ferdymercury/Controller-Electrical-Schematics/kicad/my_Design_fields.xlsx

Refs | datasheet | footprint | value | mfg-pn | digikey-pn
C1 | http://datasheets.avx.com/AR-Series.pdf | C_Rect_L5.08mm_W3.175mm_P2.54mm:C_Rect_L5.08mm_W3.175mm_P2.54mm | 0.1uF | AR205F104K4R | 478-5096-ND
C10 | http://datasheets.avx.com/AR-Series.pdf | C_Rect_L5.08mm_W3.175mm_P2.54mm:C_Rect_L5.08mm_W3.175mm_P2.54mm | 0.1uF | AR205F104K4R | 478-5096-ND
C11 | http://datasheets.avx.com/AR-Series.pdf | C_Rect_L5.08mm_W3.175mm_P2.54mm:C_Rect_L5.08mm_W3.175mm_P2.54mm | 0.1uF | AR205F104K4R | 478-5096-ND
C12 | http://datasheets.avx.com/AR-Series.pdf | C_Rect_L5.08mm_W3.175mm_P2.54mm:C_Rect_L5.08mm_W3.175mm_P2.54mm | 0.1uF | AR205F104K4R | 478-5096-ND
C13 | http://datasheets.avx.com/AR-Series.pdf | C_Rect_L5.08mm_W3.175mm_P2.54mm:C_Rect_L5.08mm_W3.175mm_P2.54mm | 0.1uF | AR205F104K4R | 478-5096-ND
C14 | http://datasheets.avx.com/AR-Series.pdf | C_Rect_L5.08mm_W3.175mm_P2.54mm:C_Rect_L5.08mm_W3.175mm_P2.54mm | 0.1uF | AR205F104K4R | 478-5096-ND
C15 | http://datasheets.avx.com/AR-Series.pdf | C_Rect_L5.08mm_W3.175mm_P2.54mm:C_Rect_L5.08mm_W3.175mm_P2.54mm | 0.1uF | AR205F104K4R | 478-5096-ND
C16 | http://datasheets.avx.com/AR-Series.pdf | C_Rect_L5.08mm_W3.175mm_P2.54mm:C_Rect_L5.08mm_W3.175mm_P2.54mm | 0.1uF | AR205F104K4R | 478-5096-ND
C17 | http://datasheets.avx.com/AR-Series.pdf | C_Rect_L5.08mm_W3.175mm_P2.54mm:C_Rect_L5.08mm_W3.175mm_P2.54mm | 0.1uF | AR205F104K4R | 478-5096-ND
C18 | http://datasheets.avx.com/AR-Series.pdf | C_Rect_L5.08mm_W3.175mm_P2.54mm:C_Rect_L5.08mm_W3.175mm_P2.54mm | 0.1uF | AR205F104K4R | 478-5096-ND
C2 | http://datasheets.avx.com/AR-Series.pdf | C_Rect_L5.08mm_W3.175mm_P2.54mm:C_Rect_L5.08mm_W3.175mm_P2.54mm | 0.1uF | AR205F104K4R | 478-5096-ND
C3 | http://datasheets.avx.com/AR-Series.pdf | C_Rect_L5.08mm_W3.175mm_P2.54mm:C_Rect_L5.08mm_W3.175mm_P2.54mm | 0.1uF | AR205F104K4R | 478-5096-ND
C4 | http://datasheets.avx.com/AR-Series.pdf | C_Rect_L5.08mm_W3.175mm_P2.54mm:C_Rect_L5.08mm_W3.175mm_P2.54mm | 0.1uF | AR205F104K4R | 478-5096-ND
C5 | http://datasheets.avx.com/AR-Series.pdf | C_Rect_L5.08mm_W3.175mm_P2.54mm:C_Rect_L5.08mm_W3.175mm_P2.54mm | 0.01uF | AR205F103K4R | 478-5095-ND
C6 | http://datasheets.avx.com/AR-Series.pdf | C_Rect_L5.08mm_W3.175mm_P2.54mm:C_Rect_L5.08mm_W3.175mm_P2.54mm | 0.01uF | AR205F103K4R | 478-5095-ND
C7 | http://datasheets.avx.com/AR-Series.pdf | C_Rect_L5.08mm_W3.175mm_P2.54mm:C_Rect_L5.08mm_W3.175mm_P2.54mm | 0.1uF | AR205F104K4R | 478-5096-ND
C8 | http://datasheets.avx.com/AR-Series.pdf | C_Rect_L5.08mm_W3.175mm_P2.54mm:C_Rect_L5.08mm_W3.175mm_P2.54mm | 0.1uF | AR205F104K4R | 478-5096-ND
C9 | http://datasheets.avx.com/AR-Series.pdf | C_Rect_L5.08mm_W3.175mm_P2.54mm:C_Rect_L5.08mm_W3.175mm_P2.54mm | 0.1uF | AR205F104K4R | 478-5096-ND
D11 | https://media.digikey.com/pdf/Data%20Sheets/Comchip%20PDFs/SB520E-G_SB5100E-G.pdf | Diodes_THT:D_DO-201AD_P15.24mm_Horizontal | SB5100E-G | SB5100E-G | 641-1421-1-ND
D2 | https://media.digikey.com/pdf/Data%20Sheets/Comchip%20PDFs/SB520E-G_SB5100E-G.pdf | Diodes_THT:D_DO-201AD_P15.24mm_Horizontal | SB5100E-G | SB5100E-G | 641-1421-1-ND
D3 | https://media.digikey.com/pdf/Data%20Sheets/Comchip%20PDFs/SB520E-G_SB5100E-G.pdf | Diodes_THT:D_DO-201AD_P15.24mm_Horizontal | SB5100E-G | SB5100E-G | 641-1421-1-ND
D4 | http://www.kingbrightusa.com/images/catalog/SPEC/WP7113ID.pdf | LEDs:LED_D5.0mm | WP7113ID | WP7113ID | 754-1264-ND
D5 | http://www.kingbrightusa.com/images/catalog/SPEC/WP7113ID.pdf | LEDs:LED_D5.0mm | WP7113ID | WP7113ID | 754-1264-ND
D7 | https://media.digikey.com/pdf/Data%20Sheets/Comchip%20PDFs/SB520E-G_SB5100E-G.pdf | Diodes_THT:D_DO-201AD_P15.24mm_Horizontal | SB5100E-G | SB5100E-G | 641-1421-1-ND
D8 | https://media.digikey.com/pdf/Data%20Sheets/Comchip%20PDFs/SB520E-G_SB5100E-G.pdf | Diodes_THT:D_DO-201AD_P15.24mm_Horizontal | SB5100E-G | SB5100E-G | 641-1421-1-ND
Q1 | https://www.fairchildsemi.com/datasheets/MM/MMBT3904.pdf | TO_SOT_Packages_THT:TO-92_Inline_Wide | 2N3904 | 2N3904BU | 2N3904FS-ND
Q10 | http://www.onsemi.com/pub/Collateral/NTB5605P-D.PDF | TO_SOT_Packages_THT:TO-220-3_Vertical | NTB5605PT4G | NTB5605PT4G | NTB5605PT4GOSCT-ND
Q11 | https://www.fairchildsemi.com/datasheets/MM/MMBT3904.pdf | TO_SOT_Packages_THT:TO-92_Inline_Wide | 2N3904 | 2N3904BU | 2N3904FS-ND
Q12 | https://www.fairchildsemi.com/datasheets/FQ/FQB30N06L.pdf | TO_SOT_Packages_SMD:TO-263-3_TabPin2 | FQB30N06LTM | FQB30N06LTM | FQB30N06LTMCT-ND
Q13 | https://www.fairchildsemi.com/datasheets/FQ/FQB30N06L.pdf | TO_SOT_Packages_SMD:TO-263-3_TabPin2 | FQB30N06LTM | FQB30N06LTM | FQB30N06LTMCT-ND
Q14 | http://www.onsemi.com/pub/Collateral/NTB5605P-D.PDF | TO_SOT_Packages_THT:TO-220-3_Vertical | NTB5605PT4G | NTB5605PT4G | NTB5605PT4GOSCT-ND
Q15 | https://www.fairchildsemi.com/datasheets/MM/MMBT3904.pdf | TO_SOT_Packages_THT:TO-92_Inline_Wide | 2N3904 | 2N3904BU | 2N3904FS-ND
Q16 | http://www.onsemi.com/pub/Collateral/NTB5605P-D.PDF | TO_SOT_Packages_THT:TO-220-3_Vertical | NTB5605PT4G | NTB5605PT4G | NTB5605PT4GOSCT-ND
Q17 | https://www.fairchildsemi.com/datasheets/MM/MMBT3904.pdf | TO_SOT_Packages_THT:TO-92_Inline_Wide | 2N3904 | 2N3904BU | 2N3904FS-ND
Q18 | http://www.onsemi.com/pub/Collateral/NTB5605P-D.PDF | TO_SOT_Packages_THT:TO-220-3_Vertical | NTB5605PT4G | NTB5605PT4G | NTB5605PT4GOSCT-ND
Q19 | https://www.fairchildsemi.com/datasheets/MM/MMBT3904.pdf | TO_SOT_Packages_THT:TO-92_Inline_Wide | 2N3904 | 2N3904BU | 2N3904FS-ND
Q2 | http://www.onsemi.com/pub/Collateral/NTB5605P-D.PDF | TO_SOT_Packages_THT:TO-220-3_Vertical | NTB5605PT4G | NTB5605PT4G | NTB5605PT4GOSCT-ND
Q20 | http://www.onsemi.com/pub/Collateral/NTB5605P-D.PDF | TO_SOT_Packages_THT:TO-220-3_Vertical | FQB30N06LTM | FQB30N06LTM | FQB30N06LTMCT-ND
Q21 | https://www.fairchildsemi.com/datasheets/MM/MMBT3904.pdf | TO_SOT_Packages_THT:TO-92_Molded_Narrow | 2N3904 | 2N3904BU | 2N3904FS-ND
Q22 | https://www.fairchildsemi.com/datasheets/MM/MMBT3904.pdf | TO_SOT_Packages_THT:TO-92_Molded_Narrow | 2N3904 | 2N3904BU | 2N3904FS-ND
Q23 | http://www.onsemi.com/pub/Collateral/NTB5605P-D.PDF | TO_SOT_Packages_THT:TO-220-3_Vertical | NTB5605PT4G | NTB5605PT4G | NTB5605PT4GOSCT-ND
Q24 | https://www.fairchildsemi.com/datasheets/MM/MMBT3904.pdf | TO_SOT_Packages_THT:TO-92_Inline_Wide | 2N3904 | 2N3904BU | 2N3904FS-ND
Q25 | http://www.onsemi.com/pub/Collateral/NTB5605P-D.PDF | TO_SOT_Packages_THT:TO-220-3_Vertical | NTB5605PT4G | NTB5605PT4G | NTB5605PT4GOSCT-ND
Q26 | https://www.fairchildsemi.com/datasheets/MM/MMBT3904.pdf | TO_SOT_Packages_THT:TO-92_Inline_Wide | 2N3904 | 2N3904BU | 2N3904FS-ND
Q27 | http://www.onsemi.com/pub/Collateral/NTB5605P-D.PDF | TO_SOT_Packages_THT:TO-220-3_Vertical | NTB5605PT4G | NTB5605PT4G | NTB5605PT4GOSCT-ND
Q28 | https://www.fairchildsemi.com/datasheets/MM/MMBT3904.pdf | TO_SOT_Packages_THT:TO-92_Inline_Wide | 2N3904 | 2N3904BU | 2N3904FS-ND
Q29 | http://www.onsemi.com/pub/Collateral/NTB5605P-D.PDF | TO_SOT_Packages_THT:TO-220-3_Vertical | NTB5605PT4G | NTB5605PT4G | NTB5605PT4GOSCT-ND
Q3 | http://www.onsemi.com/pub/Collateral/NTB5605P-D.PDF | TO_SOT_Packages_THT:TO-220-3_Vertical | NTB5605PT4G | NTB5605PT4G | NTB5605PT4GOSCT-ND
Q30 | https://www.fairchildsemi.com/datasheets/MM/MMBT3904.pdf | TO_SOT_Packages_THT:TO-92_Inline_Wide | 2N3904 | 2N3904BU | 2N3904FS-ND
Q31 | https://www.fairchildsemi.com/datasheets/FQ/FQB30N06L.pdf | TO_SOT_Packages_SMD:TO-263-3_TabPin2 | FQB30N06LTM | FQB30N06LTM | FQB30N06LTMCT-ND
Q32 | https://www.fairchildsemi.com/datasheets/FQ/FQB30N06L.pdf | TO_SOT_Packages_SMD:TO-263-3_TabPin2 | FQB30N06LTM | FQB30N06LTM | FQB30N06LTMCT-ND
Q33 | http://www.onsemi.com/pub/Collateral/NTB5605P-D.PDF | TO_SOT_Packages_THT:TO-220-3_Vertical | NTB5605PT4G | NTB5605PT4G | NTB5605PT4GOSCT-ND
Q34 | https://www.fairchildsemi.com/datasheets/MM/MMBT3904.pdf | TO_SOT_Packages_THT:TO-92_Inline_Wide | 2N3904 | 2N3904BU | 2N3904FS-ND
Q35 | http://www.onsemi.com/pub/Collateral/NTB5605P-D.PDF | TO_SOT_Packages_THT:TO-220-3_Vertical | NTB5605PT4G | NTB5605PT4G | NTB5605PT4GOSCT-ND
Q36 | https://www.fairchildsemi.com/datasheets/MM/MMBT3904.pdf | TO_SOT_Packages_THT:TO-92_Inline_Wide | 2N3904 | 2N3904BU | 2N3904FS-ND
Q37 | http://www.onsemi.com/pub/Collateral/NTB5605P-D.PDF | TO_SOT_Packages_THT:TO-220-3_Vertical | NTB5605PT4G | NTB5605PT4G | NTB5605PT4GOSCT-ND
Q38 | https://www.fairchildsemi.com/datasheets/MM/MMBT3904.pdf | TO_SOT_Packages_THT:TO-92_Inline_Wide | 2N3904 | 2N3904BU | 2N3904FS-ND
Q39 | http://www.onsemi.com/pub/Collateral/NTB5605P-D.PDF | TO_SOT_Packages_THT:TO-220-3_Vertical | NTB5605PT4G | NTB5605PT4G | NTB5605PT4GOSCT-ND
Q4 | https://www.fairchildsemi.com/datasheets/MM/MMBT3904.pdf | TO_SOT_Packages_THT:TO-92_Inline_Wide | 2N3904 | 2N3904BU | 2N3904FS-ND
Q40 | https://www.fairchildsemi.com/datasheets/MM/MMBT3904.pdf | TO_SOT_Packages_THT:TO-92_Inline_Wide | 2N3904 | 2N3904BU | 2N3904FS-ND
Q41 | http://www.onsemi.com/pub/Collateral/BSS138LT1-D.PDF | TO_SOT_Packages_SMD:SOT-23 | BSS138 | BSS138LT1G | BSS138LT1GOSCT-ND
Q42 | http://www.onsemi.com/pub/Collateral/BSS138LT1-D.PDF | TO_SOT_Packages_SMD:SOT-23 | BSS138 | BSS138LT1G | BSS138LT1GOSCT-ND
Q5 | http://www.onsemi.com/pub/Collateral/NTB5605P-D.PDF | TO_SOT_Packages_THT:TO-220-3_Vertical | NTB5605PT4G | NTB5605PT4G | NTB5605PT4GOSCT-ND
Q6 | https://www.fairchildsemi.com/datasheets/MM/MMBT3904.pdf | TO_SOT_Packages_THT:TO-92_Inline_Wide | 2N3904 | 2N3904BU | 2N3904FS-ND
Q7 | https://www.fairchildsemi.com/datasheets/FQ/FQB30N06L.pdf | TO_SOT_Packages_SMD:TO-263-3_TabPin2 | FQB30N06LTM | FQB30N06LTM | FQB30N06LTMCT-ND
Q8 | http://www.onsemi.com/pub/Collateral/NTB5605P-D.PDF | TO_SOT_Packages_THT:TO-220-3_Vertical | NTB5605PT4G | NTB5605PT4G | NTB5605PT4GOSCT-ND
Q9 | https://www.fairchildsemi.com/datasheets/MM/MMBT3904.pdf | TO_SOT_Packages_THT:TO-92_Inline_Wide | 2N3904 | 2N3904BU | 2N3904FS-ND
R1 |  | Resistors_THT:R_Axial_DIN0204_L3.6mm_D1.6mm_P5.08mm_Horizontal | 10KΩ | MBA02040C1002FRP00 | BC10.0KXCT-ND
R100 |  | Resistors_THT:R_Axial_DIN0204_L3.6mm_D1.6mm_P5.08mm_Horizontal | 10KΩ | MBA02040C1002FRP00 | BC10.0KXCT-ND
R102 |  | Resistors_THT:R_Axial_DIN0204_L3.6mm_D1.6mm_P5.08mm_Horizontal | 10KΩ | MBA02040C1002FRP00 | BC10.0KXCT-ND
R103 |  | Resistors_THT:R_Axial_DIN0204_L3.6mm_D1.6mm_P5.08mm_Horizontal | 1KΩ | MBA02040C1001FRP00 | BC1.00KXCT-ND
R104 |  | Resistors_THT:R_Axial_DIN0204_L3.6mm_D1.6mm_P5.08mm_Horizontal | 10KΩ | MBA02040C1002FRP00 | BC10.0KXCT-ND
R107 |  | Resistors_THT:R_Axial_DIN0204_L3.6mm_D1.6mm_P5.08mm_Horizontal | 10KΩ | MBA02040C1002FRP00 | BC10.0KXCT-ND
R109 |  | Resistors_THT:R_Axial_DIN0204_L3.6mm_D1.6mm_P5.08mm_Horizontal | 10KΩ | MBA02040C1002FRP00 | BC10.0KXCT-ND
R11 |  | Resistors_THT:R_Axial_DIN0204_L3.6mm_D1.6mm_P5.08mm_Horizontal | 1KΩ | MBA02040C1001FRP00 | BC1.00KXCT-ND
R110 |  | Resistors_THT:R_Axial_DIN0204_L3.6mm_D1.6mm_P5.08mm_Horizontal | 10KΩ | MBA02040C1002FRP00 | BC10.0KXCT-ND
R111 |  | Resistors_THT:R_Axial_DIN0204_L3.6mm_D1.6mm_P5.08mm_Horizontal | 1KΩ | MBA02040C1001FRP00 | BC1.00KXCT-ND
R112 |  | Resistors_THT:R_Axial_DIN0204_L3.6mm_D1.6mm_P5.08mm_Horizontal | 10KΩ | MBA02040C1002FRP00 | BC10.0KXCT-ND
R114 |  | Resistors_THT:R_Axial_DIN0204_L3.6mm_D1.6mm_P5.08mm_Horizontal | 10KΩ | MBA02040C1002FRP00 | BC10.0KXCT-ND
R115 |  | Resistors_THT:R_Axial_DIN0204_L3.6mm_D1.6mm_P5.08mm_Horizontal | 1KΩ | MBA02040C1001FRP00 | BC1.00KXCT-ND
R116 |  | Resistors_THT:R_Axial_DIN0204_L3.6mm_D1.6mm_P5.08mm_Horizontal | 10KΩ | MBA02040C1002FRP00 | BC10.0KXCT-ND
R118 |  | Resistors_THT:R_Axial_DIN0204_L3.6mm_D1.6mm_P5.08mm_Horizontal | 100KΩ | MBA02040C1003FRP00 | BC100KXCT-ND
R119 |  | Resistors_THT:R_Axial_DIN0204_L3.6mm_D1.6mm_P5.08mm_Horizontal | 51KΩ | MBA02040C5102FRP00 | BC3531CT-ND
R12 |  | Resistors_THT:R_Axial_DIN0204_L3.6mm_D1.6mm_P5.08mm_Horizontal | 1KΩ | MBA02040C1001FRP00 | BC1.00KXCT-ND
R120 |  | Resistors_THT:R_Axial_DIN0204_L3.6mm_D1.6mm_P5.08mm_Horizontal | 10KΩ | MBA02040C1002FRP00 | BC10.0KXCT-ND
R121 |  | Resistors_THT:R_Axial_DIN0204_L3.6mm_D1.6mm_P5.08mm_Horizontal | 1KΩ | MBA02040C1001FRP00 | BC1.00KXCT-ND
R122 |  | Resistors_THT:R_Axial_DIN0204_L3.6mm_D1.6mm_P5.08mm_Horizontal | 10KΩ | MBA02040C1002FRP00 | BC10.0KXCT-ND
R124 |  | Resistors_THT:R_Axial_DIN0204_L3.6mm_D1.6mm_P5.08mm_Horizontal | 10KΩ | MBA02040C1002FRP00 | BC10.0KXCT-ND
R125 |  | Resistors_THT:R_Axial_DIN0204_L3.6mm_D1.6mm_P5.08mm_Horizontal | 1KΩ | MBA02040C1001FRP00 | BC1.00KXCT-ND
R126 |  | Resistors_THT:R_Axial_DIN0204_L3.6mm_D1.6mm_P5.08mm_Horizontal | 10KΩ | MBA02040C1002FRP00 | BC10.0KXCT-ND
R128 |  | Resistors_THT:R_Axial_DIN0204_L3.6mm_D1.6mm_P5.08mm_Horizontal | 10KΩ | MBA02040C1002FRP00 | BC10.0KXCT-ND
R129 |  | Resistors_THT:R_Axial_DIN0204_L3.6mm_D1.6mm_P5.08mm_Horizontal | 10KΩ | MBA02040C1002FRP00 | BC10.0KXCT-ND
R13 |  | Resistors_THT:R_Axial_DIN0204_L3.6mm_D1.6mm_P5.08mm_Horizontal | 100KΩ | MBA02040C1003FRP00 | BC100KXCT-ND
R130 |  | Resistors_THT:R_Axial_DIN0204_L3.6mm_D1.6mm_P5.08mm_Horizontal | 10KΩ | MBA02040C1002FRP00 | BC10.0KXCT-ND
R131 |  | Resistors_THT:R_Axial_DIN0204_L3.6mm_D1.6mm_P5.08mm_Horizontal | 10KΩ | MBA02040C1002FRP00 | BC10.0KXCT-ND
R14 |  | Resistors_THT:R_Axial_DIN0204_L3.6mm_D1.6mm_P5.08mm_Horizontal | 51KΩ | MBA02040C5102FRP00 | BC3531CT-ND
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
R78 |  | Resistors_THT:R_Axial_DIN0204_L3.6mm_D1.6mm_P5.08mm_Horizontal | 3.3KΩ | MBA02040C3301FRP00 | BC3499CT-ND
R79 |  | Resistors_THT:R_Axial_DIN0204_L3.6mm_D1.6mm_P5.08mm_Horizontal | 3.3KΩ | MBA02040C3301FRP00 | BC3499CT-ND
R8 |  | Resistors_THT:R_Axial_DIN0204_L3.6mm_D1.6mm_P5.08mm_Horizontal | 10KΩ | MBA02040C1002FRP00 | BC10.0KXCT-ND
R80 |  | Resistors_THT:R_Axial_DIN0204_L3.6mm_D1.6mm_P5.08mm_Horizontal | 10KΩ | MBA02040C1002FRP00 | BC10.0KXCT-ND
R81 |  | Resistors_THT:R_Axial_DIN0204_L3.6mm_D1.6mm_P5.08mm_Horizontal | 10KΩ | MBA02040C1002FRP00 | BC10.0KXCT-ND
R82 |  | Resistors_THT:R_Axial_DIN0204_L3.6mm_D1.6mm_P5.08mm_Horizontal | 10KΩ | MBA02040C1002FRP00 | BC10.0KXCT-ND
R83 |  | Resistors_THT:R_Axial_DIN0204_L3.6mm_D1.6mm_P5.08mm_Horizontal | 10KΩ | MBA02040C1002FRP00 | BC10.0KXCT-ND
R84 |  | Resistors_THT:R_Axial_DIN0204_L3.6mm_D1.6mm_P5.08mm_Horizontal | 10KΩ | MBA02040C1002FRP00 | BC10.0KXCT-ND
R85 |  | Resistors_THT:R_Axial_DIN0204_L3.6mm_D1.6mm_P5.08mm_Horizontal | 10KΩ | MBA02040C1002FRP00 | BC10.0KXCT-ND
R86 |  | Resistors_THT:R_Axial_DIN0204_L3.6mm_D1.6mm_P5.08mm_Horizontal | 15KΩ | MBA02040C1502FCT00 | BC3248CT-ND
R87 |  | Resistors_THT:R_Axial_DIN0204_L3.6mm_D1.6mm_P5.08mm_Horizontal | 10KΩ | MBA02040C1002FRP00 | BC10.0KXCT-ND
R88 |  | Resistors_THT:R_Axial_DIN0204_L3.6mm_D1.6mm_P5.08mm_Horizontal | 10KΩ | MBA02040C1002FRP00 | BC10.0KXCT-ND
R89 |  | Resistors_THT:R_Axial_DIN0204_L3.6mm_D1.6mm_P5.08mm_Horizontal | 10KΩ | MBA02040C1002FRP00 | BC10.0KXCT-ND
R9 |  | Resistors_THT:R_Axial_DIN0204_L3.6mm_D1.6mm_P5.08mm_Horizontal | 10KΩ | MBA02040C1002FRP00 | BC10.0KXCT-ND
R90 |  | Resistors_THT:R_Axial_DIN0204_L3.6mm_D1.6mm_P5.08mm_Horizontal | 10KΩ | MBA02040C1002FRP00 | BC10.0KXCT-ND
R91 |  | Resistors_THT:R_Axial_DIN0204_L3.6mm_D1.6mm_P5.08mm_Horizontal | 1KΩ | MBA02040C1001FRP00 | BC1.00KXCT-ND
R92 |  | Resistors_THT:R_Axial_DIN0204_L3.6mm_D1.6mm_P5.08mm_Horizontal | 10KΩ | MBA02040C1002FRP00 | BC10.0KXCT-ND
R94 |  | Resistors_THT:R_Axial_DIN0204_L3.6mm_D1.6mm_P5.08mm_Horizontal | 10KΩ | MBA02040C1002FRP00 | BC10.0KXCT-ND
R95 |  | Resistors_THT:R_Axial_DIN0204_L3.6mm_D1.6mm_P5.08mm_Horizontal | 1KΩ | MBA02040C1001FRP00 | BC1.00KXCT-ND
R96 |  | Resistors_THT:R_Axial_DIN0204_L3.6mm_D1.6mm_P5.08mm_Horizontal | 10KΩ | MBA02040C1002FRP00 | BC10.0KXCT-ND
R98 |  | Resistors_THT:R_Axial_DIN0204_L3.6mm_D1.6mm_P5.08mm_Horizontal | 10KΩ | MBA02040C1002FRP00 | BC10.0KXCT-ND
R99 |  | Resistors_THT:R_Axial_DIN0204_L3.6mm_D1.6mm_P5.08mm_Horizontal | 1KΩ | MBA02040C1001FRP00 | BC1.00KXCT-ND
RV1 | http://www.bourns.com/docs/Product-Datasheets/pv36.pdf | Potentiometers:Potentiometer_Trimmer_Bourns_PV36W | 10KΩ | PV36W103C01B00 | 490-2875-ND
SHIELD1 |  | freetronics_footprints:ARDUINO_MEGA_SHIELD | ARDUINO_MEGA_SHIELD
U1 | https://power.murata.com/data/power/ncl/kdc_ncs3.pdf | NCS3S1205SC:NCS3S1205SC | NCS3S1205SC | NCS3S1205SC | 811-3084-ND
U2 | http://www.ixysic.com/home/pdfs.nsf/0/F9381D44DEE0D64A85256E390055B01F/$file/LCA715.pdf | Housings_DIP:DIP-6_W7.62mm_Socket | LCA715 | LCA715 | CLA308-ND
U3 |  | Housings_DIP:DIP-14_W7.62mm_Socket | CD4013B | CD4013BE | 296-2033-5-ND
U4 | http://www.ti.com/lit/ds/symlink/lm358.pdf | Housings_DIP:DIP-8_W7.62mm | LM358 | LM358P | 296-1395-5-ND
U5 | http://www.ti.com/lit/ds/symlink/sn74hc595.pdf | Housings_DIP:DIP-16_W7.62mm_Socket | 74HC595 | SN74HC595N | 296-1600-5-ND
U6 | http://www.ti.com/lit/ds/symlink/sn74hc595.pdf | Housings_DIP:DIP-16_W7.62mm_Socket | 74HC595 | SN74HC595N | 296-1600-5-ND
U7 | http://www.ti.com/lit/ds/symlink/cd74hct4067.pdf | Housings_SOIC:SOIC-24W_7.5x15.4mm_Pitch1.27mm | CD74HC4067 | CD74HCT4067M | 296-23078-ND
U8 | http://www.ti.com/lit/ds/symlink/lm139a.pdf | Housings_DIP:DIP-14_W7.62mm_Socket | LM339 | LM339N | 296-1393-5-ND
J1 | https://www.phoenixcontact.com/pxc-oc-itemdetail-pdf-web/eshop?lineItemType=LineItem&UID=1702972 | TerminalBlocks_Phoenix:TerminalBlock_Phoenix_MKDS1.5-16pol | Screw_Terminal_01x16 | 1702972 | 277-13705-ND
J10 | https://www.digikey.com/product-detail/en/amphenol-fci/75869-131LF/609-2845-ND/1302569 | Socket_Strips:Socket_Strip_Straight_2x03_Pitch2.54mm | Conn_02x03_Counter_Clockwise | 75869-131LF | 609-2845-ND
J11 | https://www.digikey.com/product-detail/en/amphenol-fci/75869-131LF/609-2845-ND/1302569 | Socket_Strips:Socket_Strip_Straight_2x03_Pitch2.54mm | Conn_02x03_Counter_Clockwise | 75869-131LF | 609-2845-ND
J12 | https://www.digikey.com/product-detail/en/amphenol-fci/75869-131LF/609-2845-ND/1302569 | Socket_Strips:Socket_Strip_Straight_2x03_Pitch2.54mm | Conn_02x03_Counter_Clockwise | 75869-131LF | 609-2845-ND
J13 | https://www.phoenixcontact.com/pxc-oc-itemdetail-pdf-web/eshop?lineItemType=LineItem&UID=1702972 | TerminalBlocks_Phoenix:TerminalBlock_Phoenix_MKDS1.5-16pol | Screw_Terminal_01x16 | 1702972 | 277-13705-ND
J14 | https://www.digikey.com/product-detail/en/amphenol-fci/75869-131LF/609-2845-ND/1302569 | Socket_Strips:Socket_Strip_Straight_2x03_Pitch2.54mm | Conn_02x03_Counter_Clockwise | 75869-131LF | 609-2845-ND
J15 | https://www.digikey.com/product-detail/en/amphenol-fci/75869-131LF/609-2845-ND/1302569 | Socket_Strips:Socket_Strip_Straight_2x03_Pitch2.54mm | Conn_02x03_Counter_Clockwise | 75869-131LF | 609-2845-ND
J16 | https://www.digikey.com/product-detail/en/amphenol-fci/75869-131LF/609-2845-ND/1302569 | Socket_Strips:Socket_Strip_Straight_2x03_Pitch2.54mm | Conn_02x03_Counter_Clockwise | 75869-131LF | 609-2845-ND
J17 | https://www.digikey.com/product-detail/en/amphenol-fci/75869-131LF/609-2845-ND/1302569 | Socket_Strips:Socket_Strip_Straight_2x03_Pitch2.54mm | Conn_02x03_Counter_Clockwise | 75869-131LF | 609-2845-ND
J18 | https://www.digikey.com/product-detail/en/amphenol-fci/75869-131LF/609-2845-ND/1302569 | Socket_Strips:Socket_Strip_Straight_2x03_Pitch2.54mm | Conn_02x03_Counter_Clockwise | 75869-131LF | 609-2845-ND
J19 | https://www.digikey.com/product-detail/en/amphenol-fci/75869-131LF/609-2845-ND/1302569 | Socket_Strips:Socket_Strip_Straight_2x03_Pitch2.54mm | Conn_02x03_Counter_Clockwise | 75869-131LF | 609-2845-ND
J2 | https://www.digikey.com/product-detail/en/amphenol-fci/75869-131LF/609-2845-ND/1302569 | Socket_Strips:Socket_Strip_Straight_2x03_Pitch2.54mm | Conn_02x03_Counter_Clockwise | 75869-131LF | 609-2845-ND
J20 | https://www.digikey.com/product-detail/en/amphenol-fci/75869-131LF/609-2845-ND/1302569 | Socket_Strips:Socket_Strip_Straight_2x03_Pitch2.54mm | Conn_02x03_Counter_Clockwise | 75869-131LF | 609-2845-ND
J21 | https://www.digikey.com/product-detail/en/amphenol-fci/75869-131LF/609-2845-ND/1302569 | Socket_Strips:Socket_Strip_Straight_2x03_Pitch2.54mm | Conn_02x03_Counter_Clockwise | 75869-131LF | 609-2845-ND
J22 | https://www.digikey.com/product-detail/en/amphenol-fci/75869-131LF/609-2845-ND/1302569 | Socket_Strips:Socket_Strip_Straight_2x03_Pitch2.54mm | Conn_02x03_Counter_Clockwise | 75869-131LF | 609-2845-ND
J23 | https://www.digikey.com/product-detail/en/amphenol-fci/75869-131LF/609-2845-ND/1302569 | Socket_Strips:Socket_Strip_Straight_2x03_Pitch2.54mm | Conn_02x03_Counter_Clockwise | 75869-131LF | 609-2845-ND
J24 | https://www.digikey.com/product-detail/en/amphenol-fci/75869-131LF/609-2845-ND/1302569 | Socket_Strips:Socket_Strip_Straight_2x03_Pitch2.54mm | Conn_02x03_Counter_Clockwise | 75869-131LF | 609-2845-ND
J3 | https://www.digikey.com/product-detail/en/amphenol-fci/75869-131LF/609-2845-ND/1302569 | 02x03_shrouded:Shroud_Socket_Strip_Straight_2x03_Pitch2.54mm | Conn_02x03_Counter_Clockwise | 75869-131LF | 609-2845-ND
J4 | https://www.phoenixcontact.com/pxc-oc-itemdetail-pdf-web/eshop?lineItemType=LineItem&UID=1702972 | TerminalBlocks_Phoenix:TerminalBlock_Phoenix_MKDS1.5-16pol | Screw_Terminal_01x16 | 1702972 | 277-13705-ND
J5 | https://www.digikey.com/product-detail/en/amphenol-fci/75869-131LF/609-2845-ND/1302569 | Socket_Strips:Socket_Strip_Straight_2x03_Pitch2.54mm | Conn_02x03_Counter_Clockwise | 75869-131LF | 609-2845-ND
J6 | https://www.digikey.com/product-detail/en/amphenol-fci/75869-131LF/609-2845-ND/1302569 | Socket_Strips:Socket_Strip_Straight_2x03_Pitch2.54mm | Conn_02x03_Counter_Clockwise | 75869-131LF | 609-2845-ND
J7 | https://www.digikey.com/product-detail/en/amphenol-fci/75869-131LF/609-2845-ND/1302569 | Socket_Strips:Socket_Strip_Straight_2x03_Pitch2.54mm | Conn_02x03_Counter_Clockwise | 75869-131LF | 609-2845-ND
J8 | https://www.phoenixcontact.com/pxc-oc-itemdetail-pdf-web/eshop?lineItemType=LineItem&UID=1702972 | TerminalBlocks_Phoenix:TerminalBlock_Phoenix_MKDS1.5-16pol | Screw_Terminal_01x16 | 1702972 | 277-13705-ND
J9 | https://www.digikey.com/product-detail/en/amphenol-fci/75869-131LF/609-2845-ND/1302569 | Socket_Strips:Socket_Strip_Straight_2x03_Pitch2.54mm | Conn_02x03_Counter_Clockwise | 75869-131LF | 609-2845-ND
JP1 |  |  | Jumper
