ferdymercury/Controller-Electrical-Schematics/pcb-outline.DXF

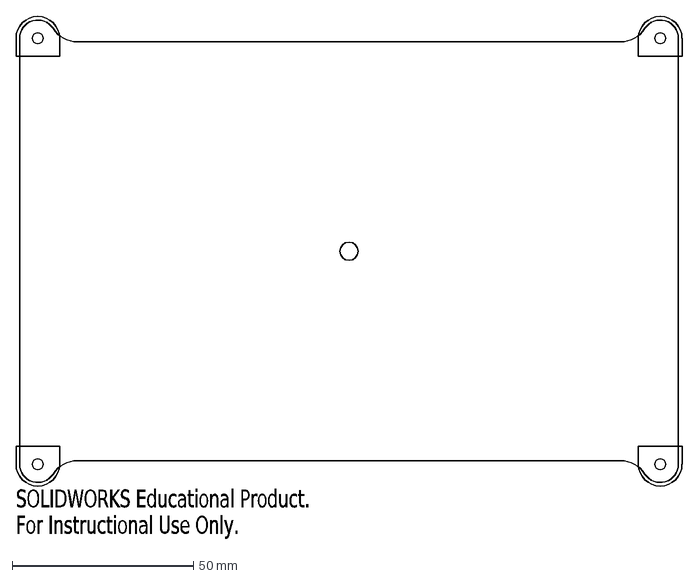
[picture p2: CAD file, 2018-07-02]
pcb-outline.DXF
SOLIDWORKS Educational Product.
For Instructional Use Only.
