ferdymercury/Controller-Electrical-Schematics/hitchco-mk4-schematic.pdf

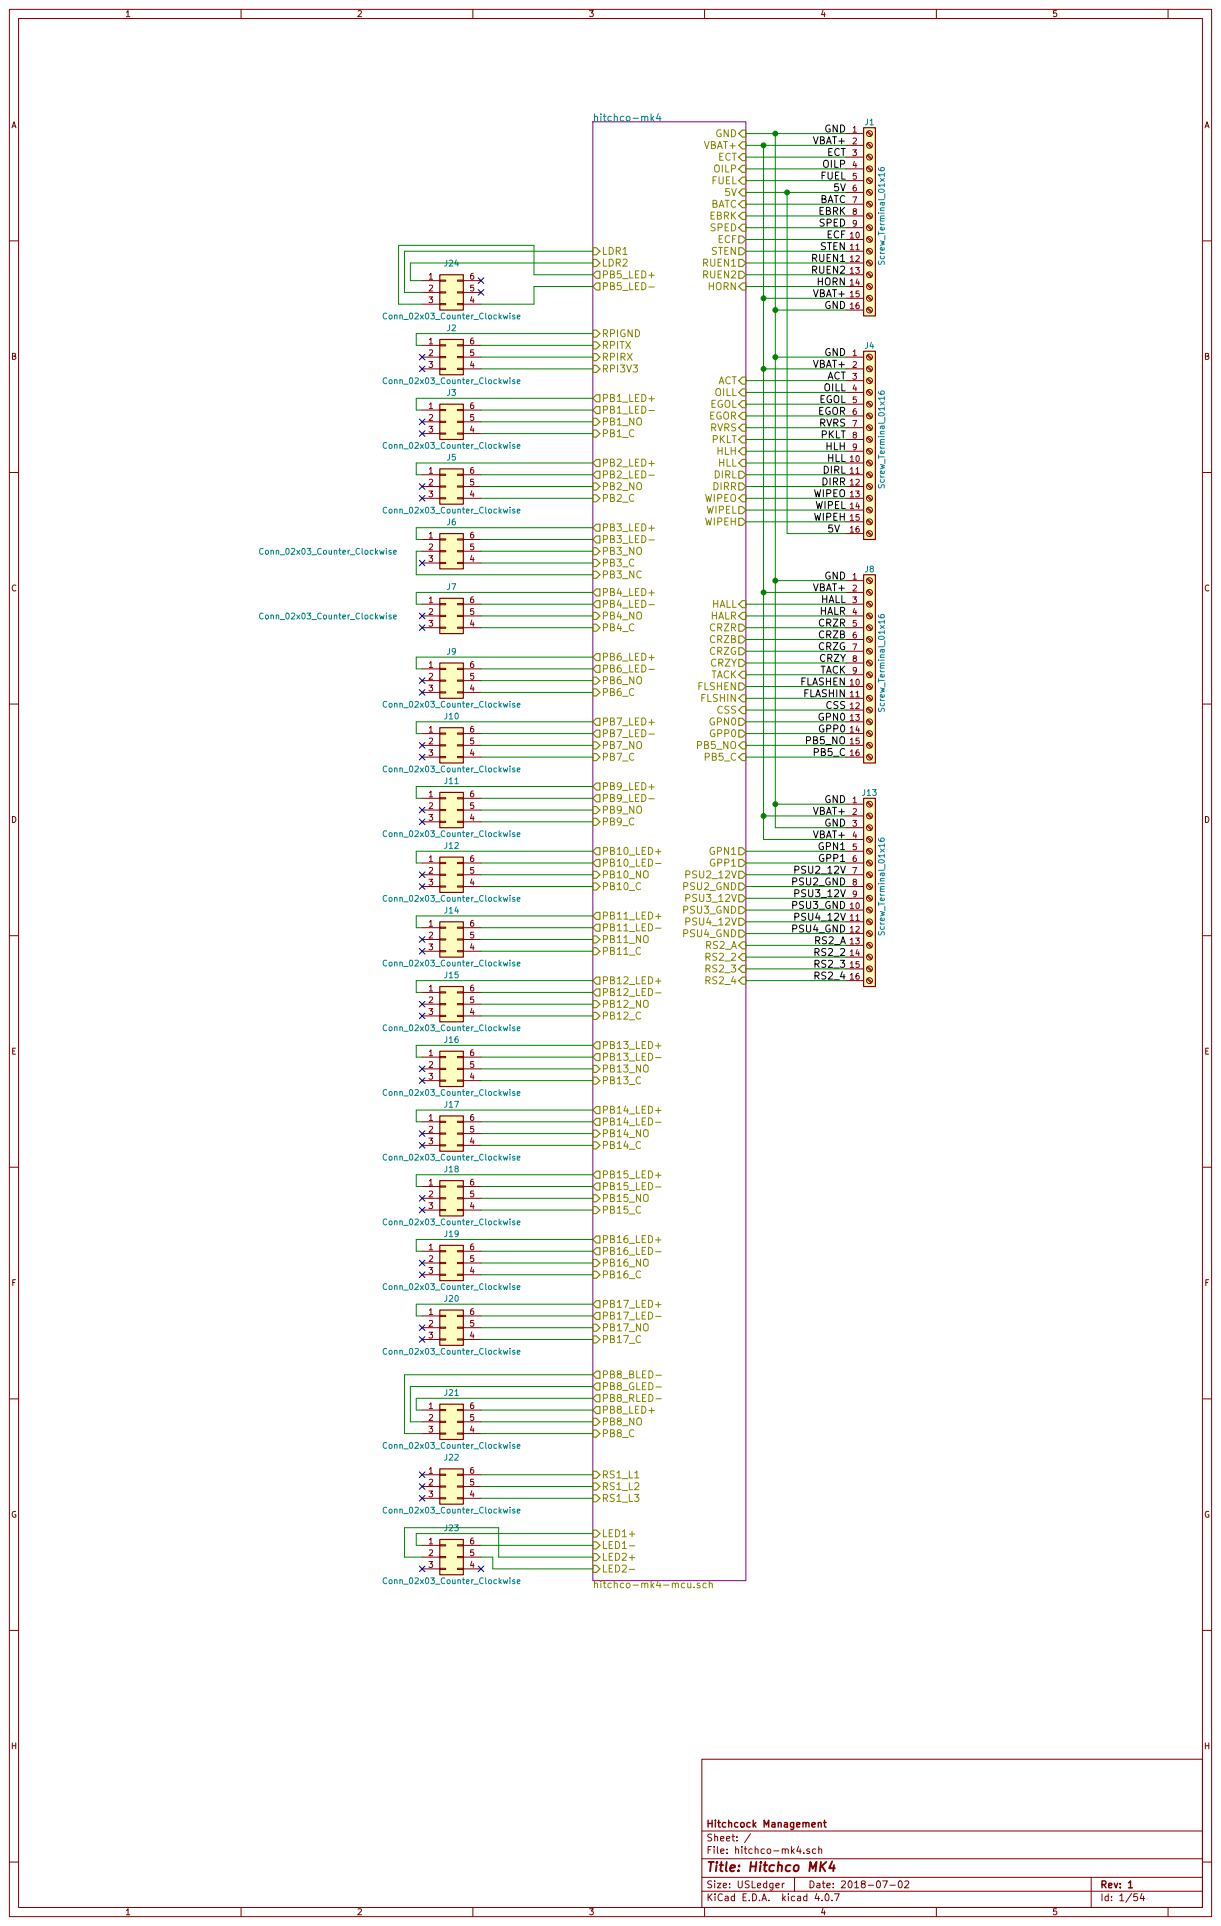
[picture p48: page 1]

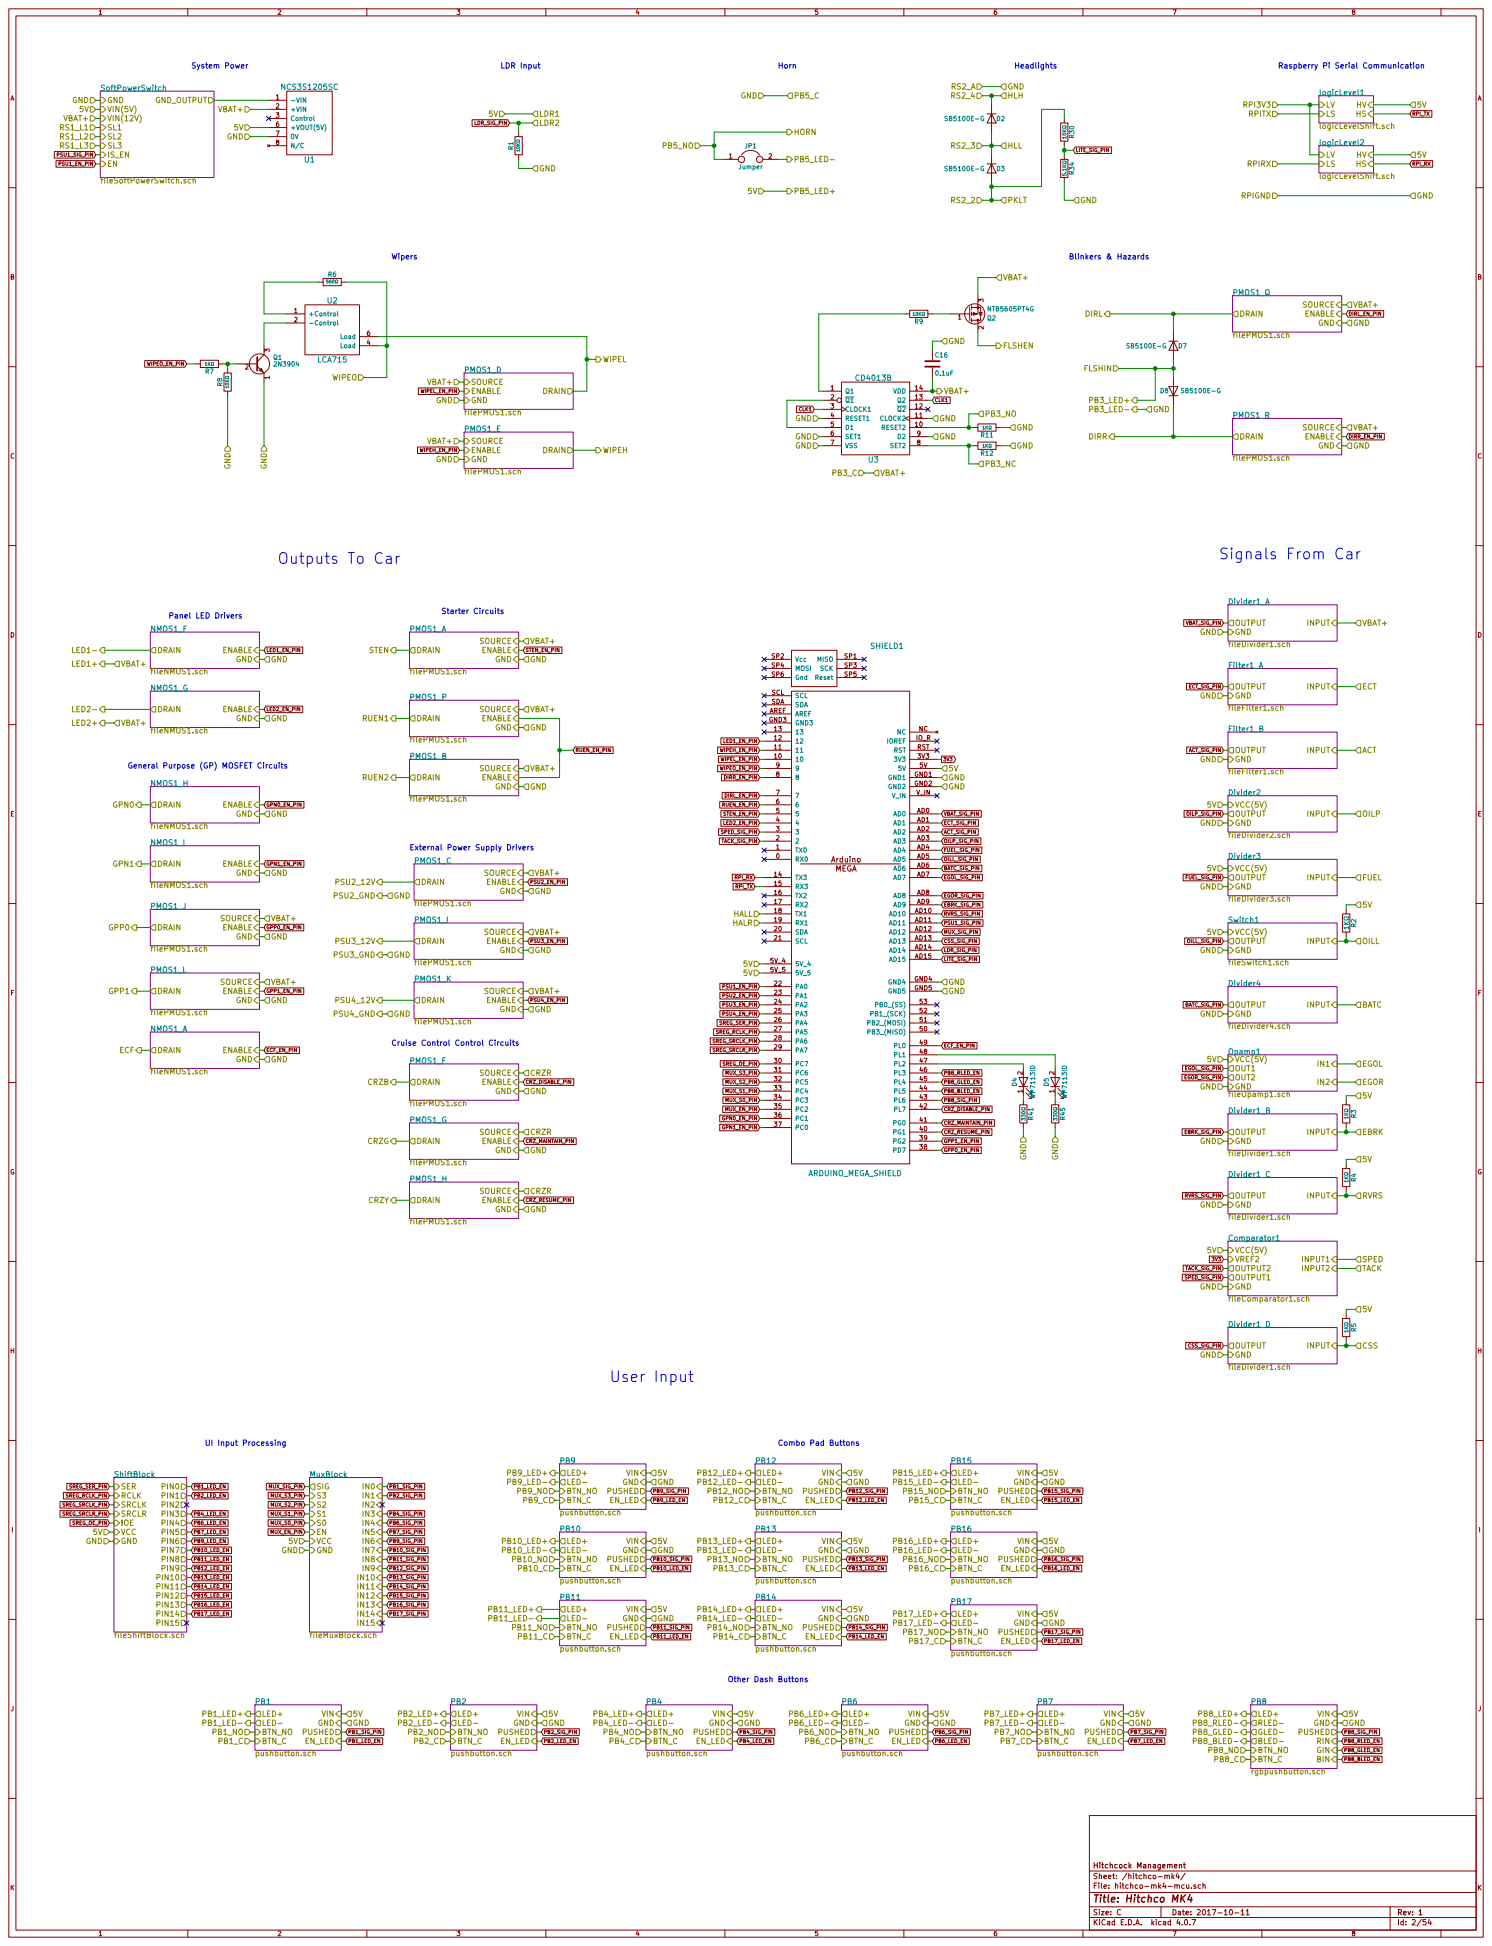
[picture p49: page 2]

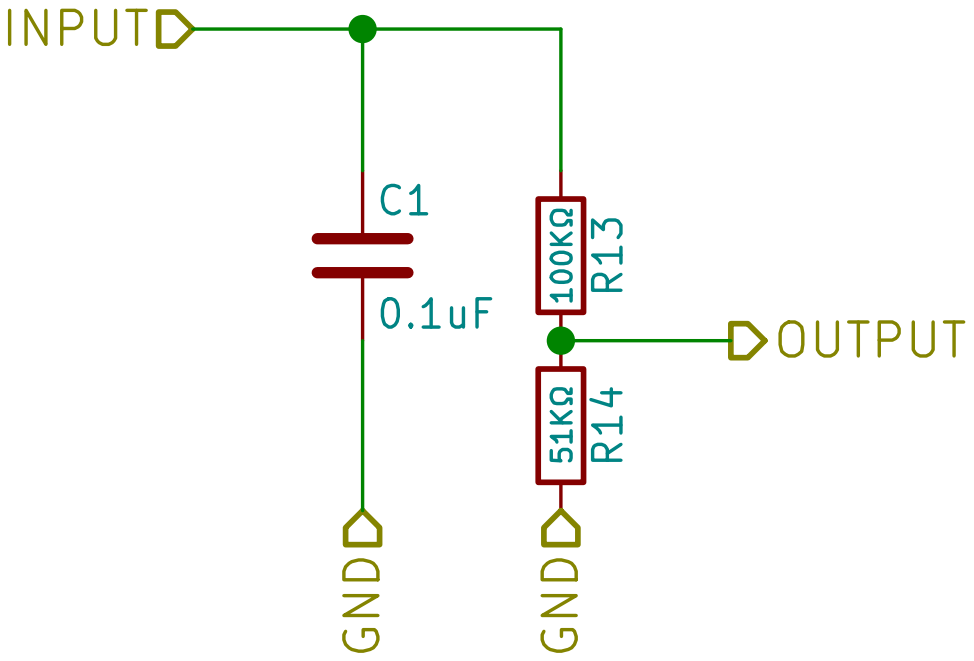
[picture p50: page 3]

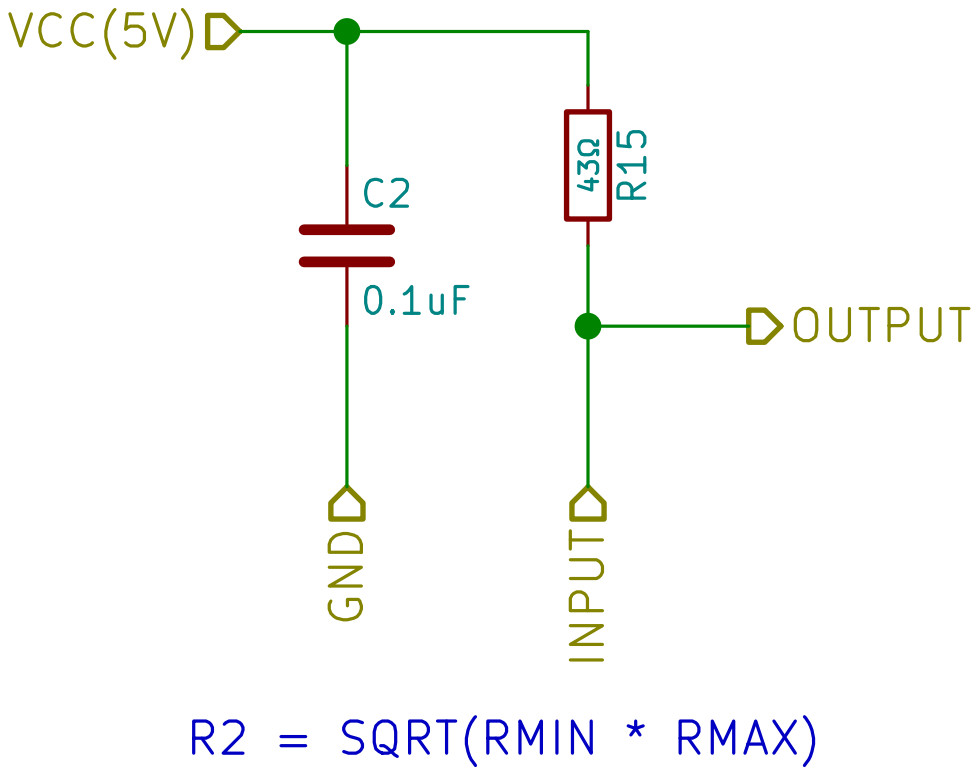
[picture p51: page 4]

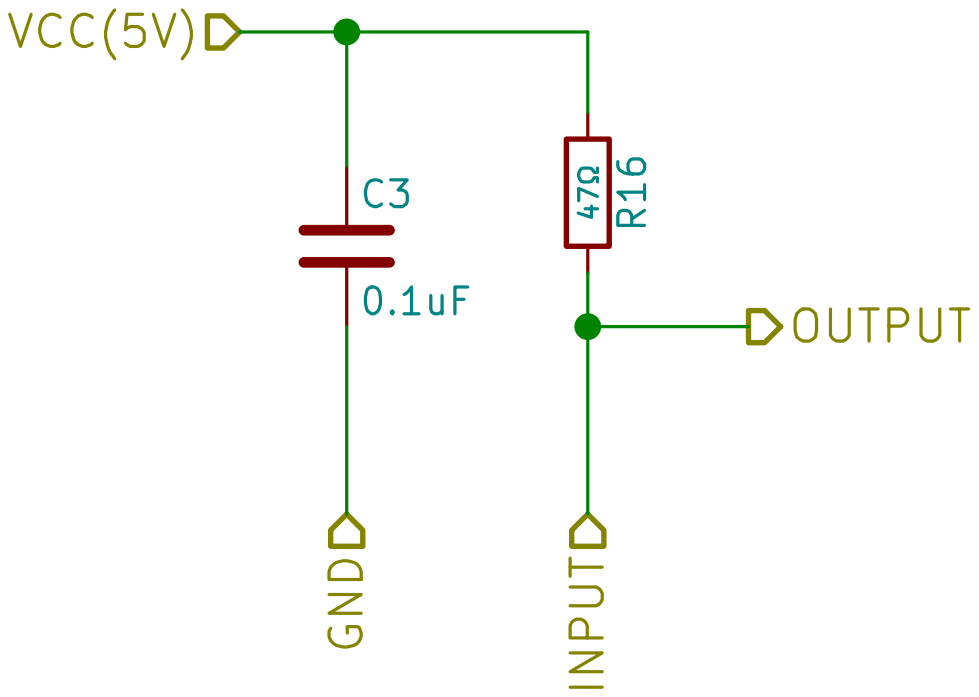
[picture p52: page 5]

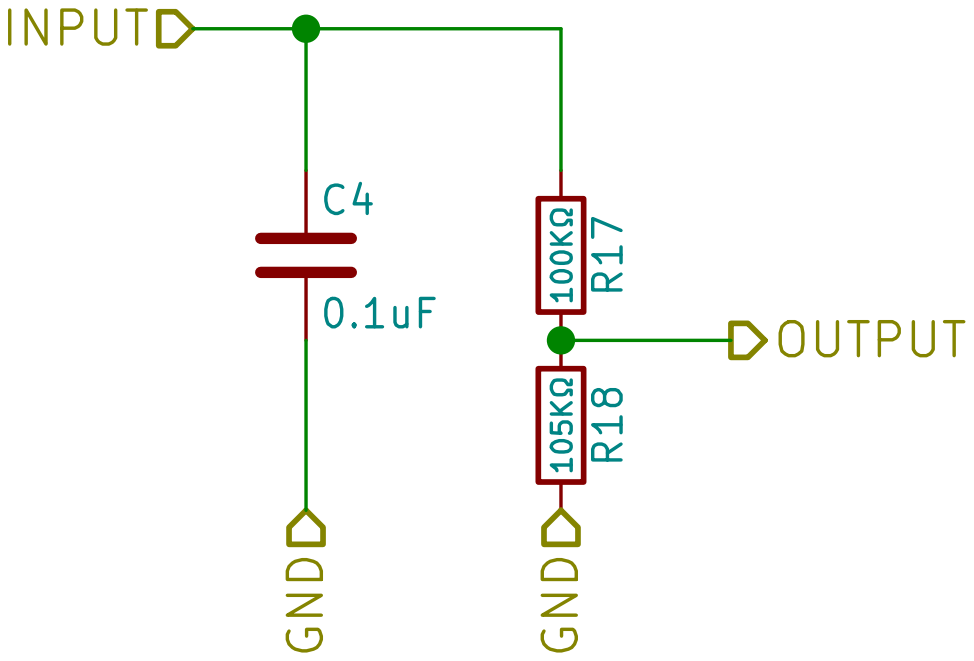
[picture p53: page 6]

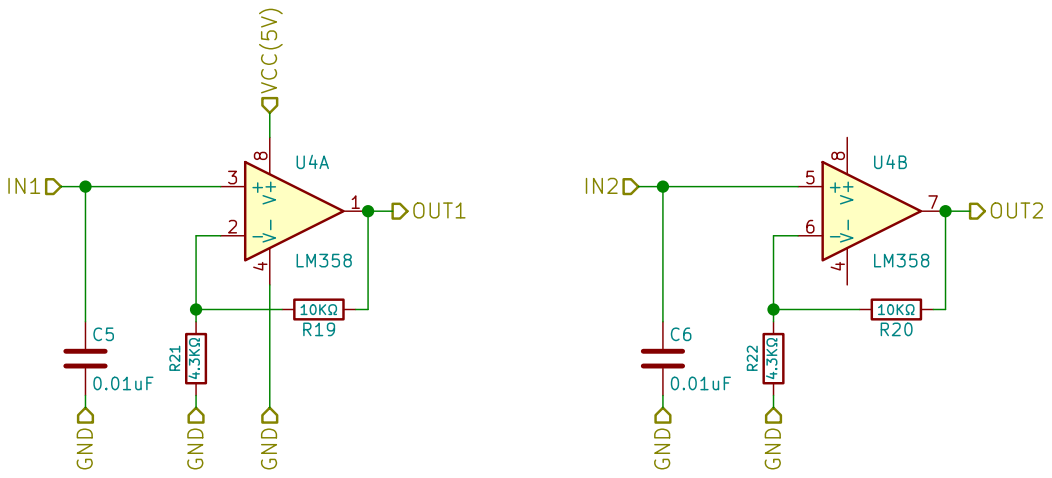
[picture p54: page 7]

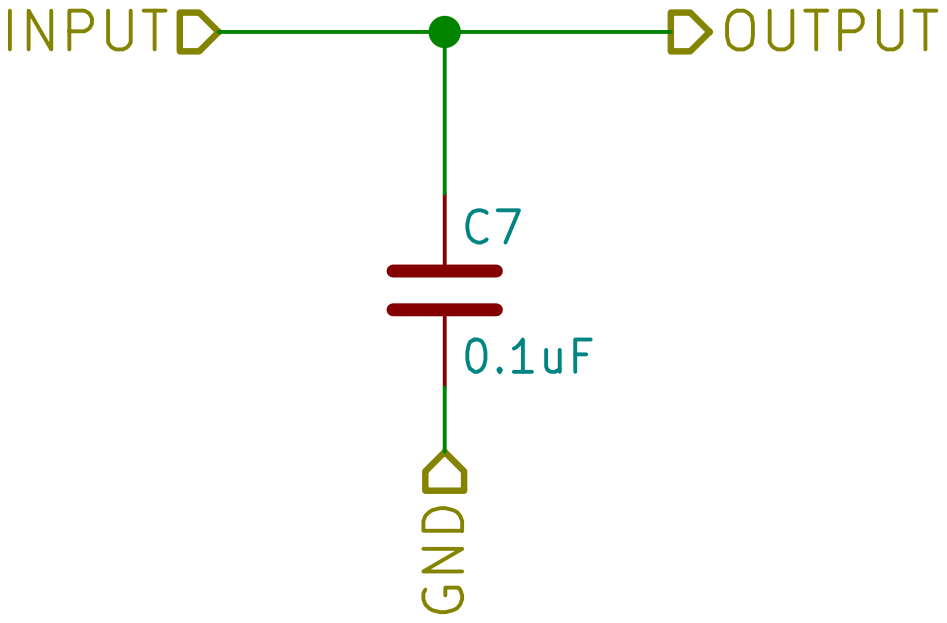
[picture p55: page 8]

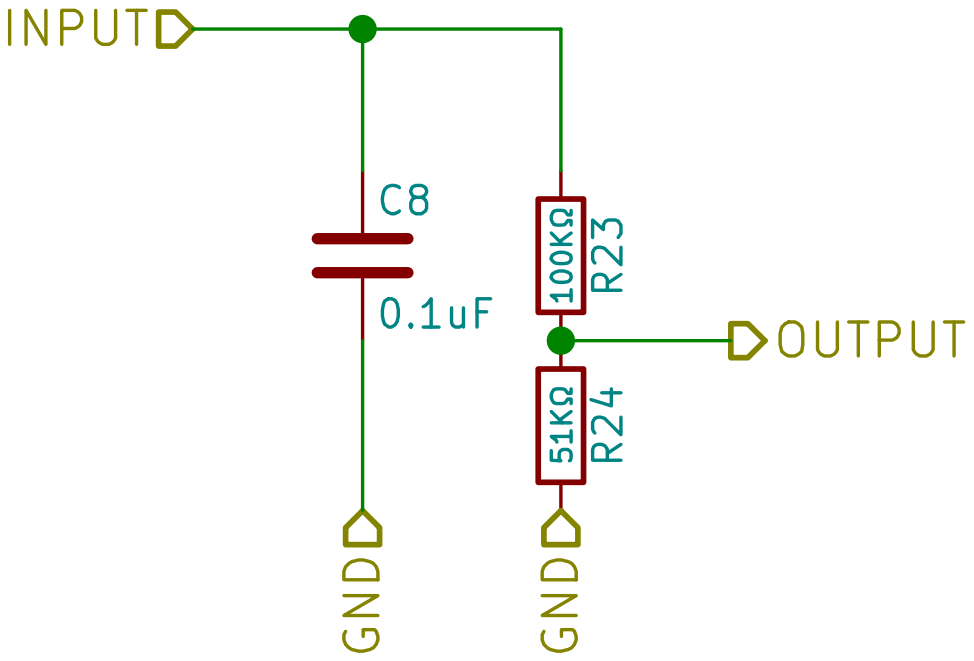
[picture p56: page 9]

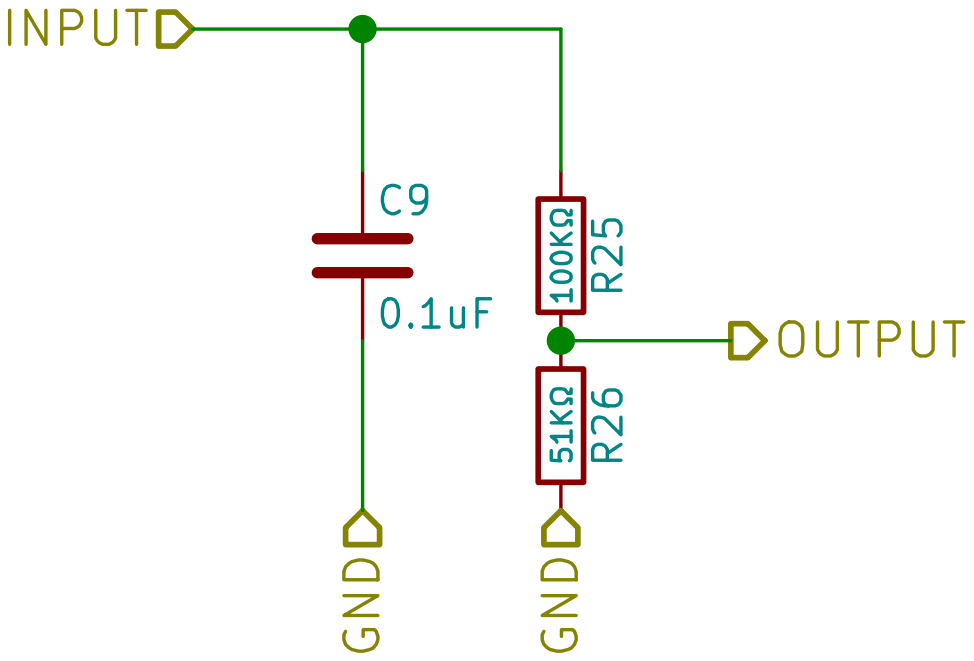
[picture p57: page 10]

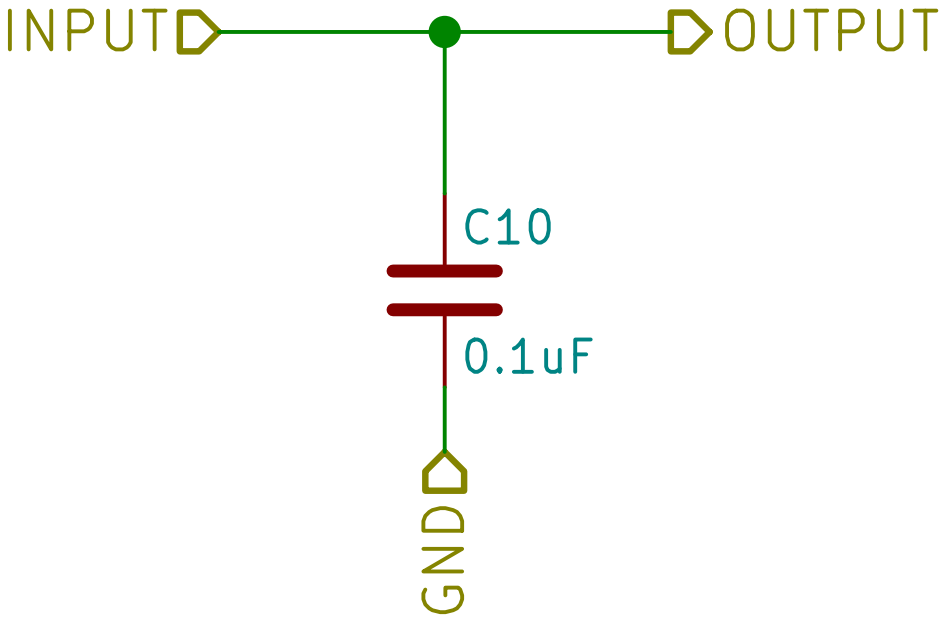
[picture p58: page 11]

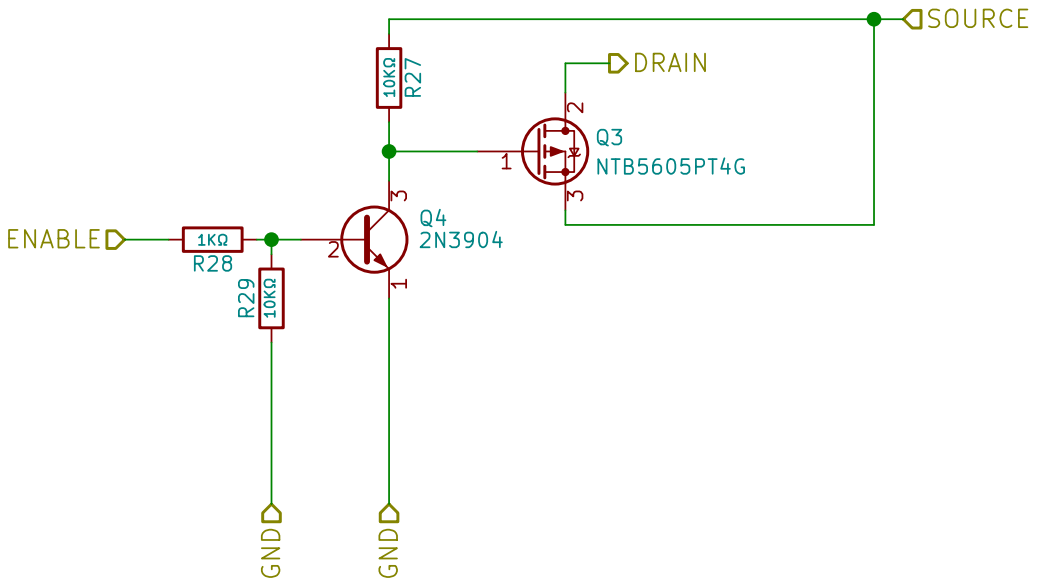
[picture p59: page 12]

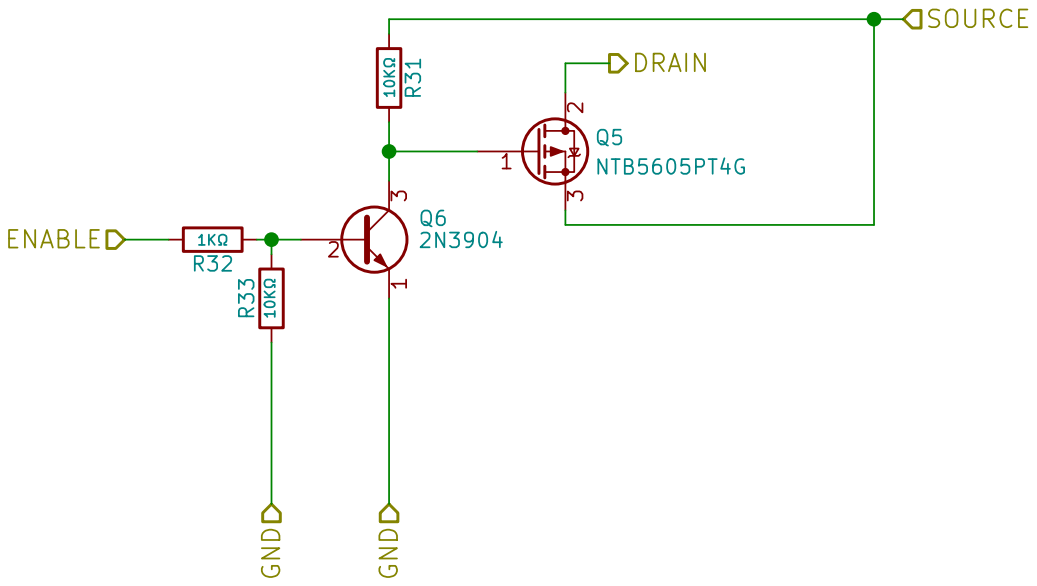
[picture p60: page 13]

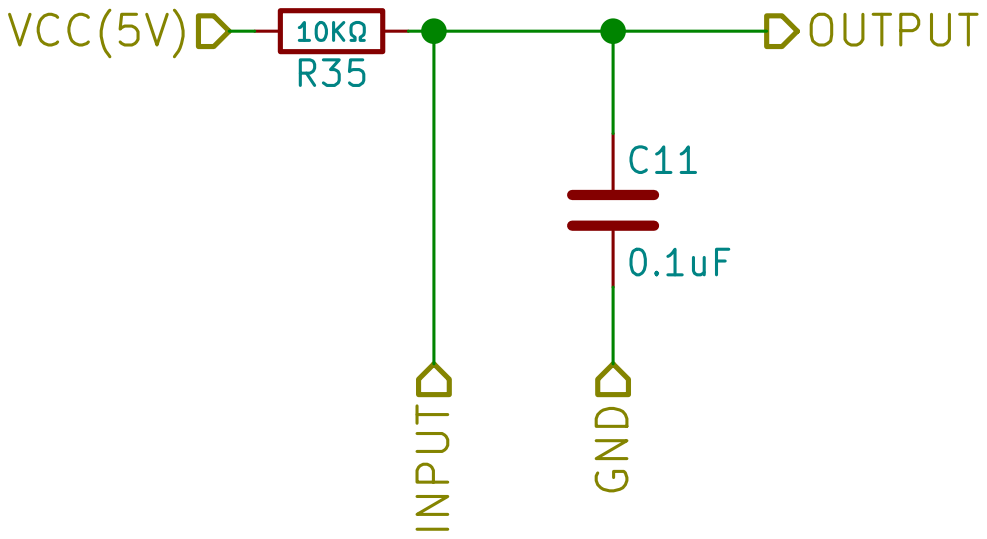
[picture p61: page 14]

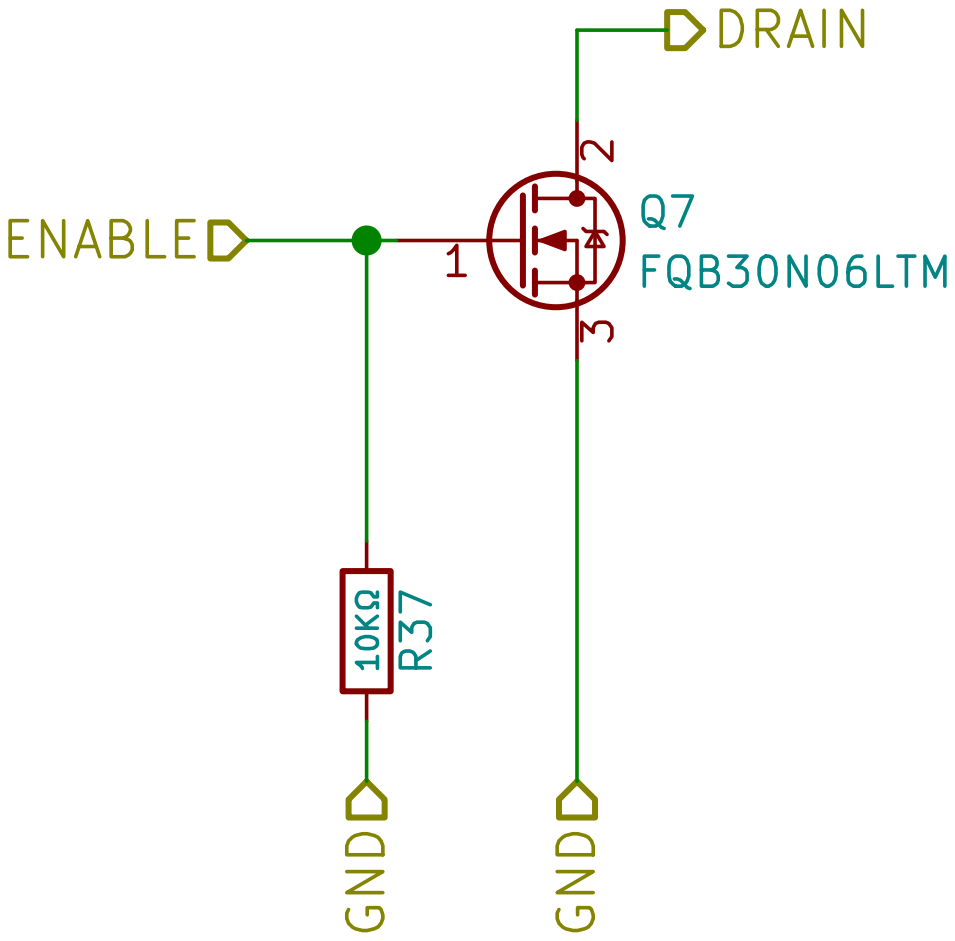
[picture p62: page 15]

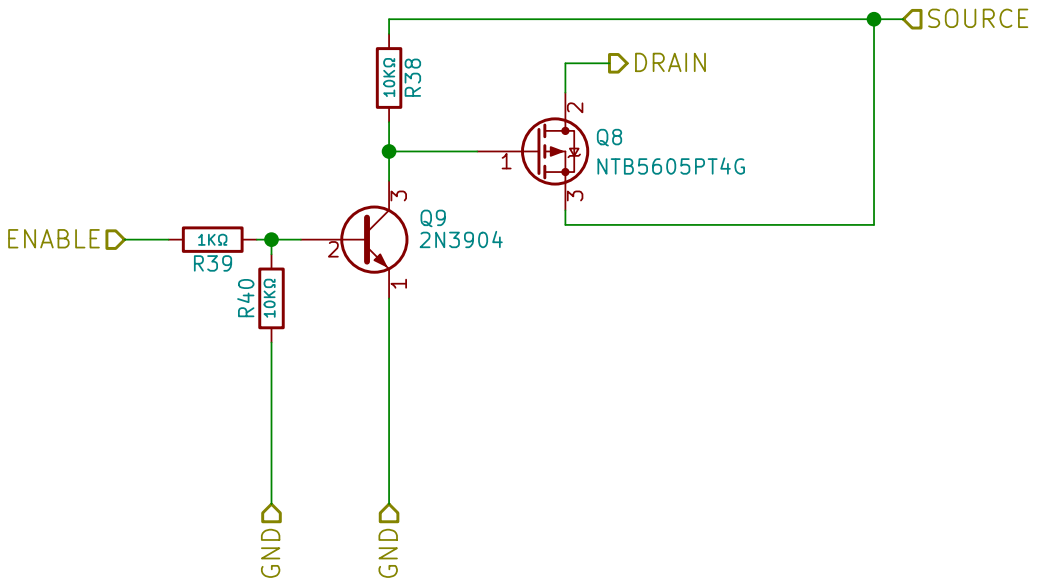
[picture p63: page 16]

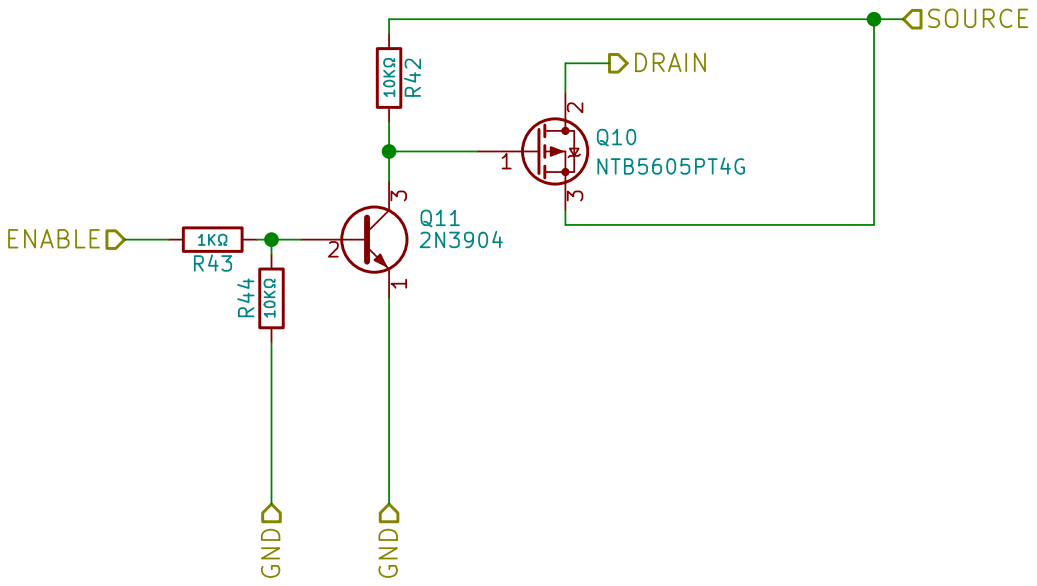
[picture p64: page 17]

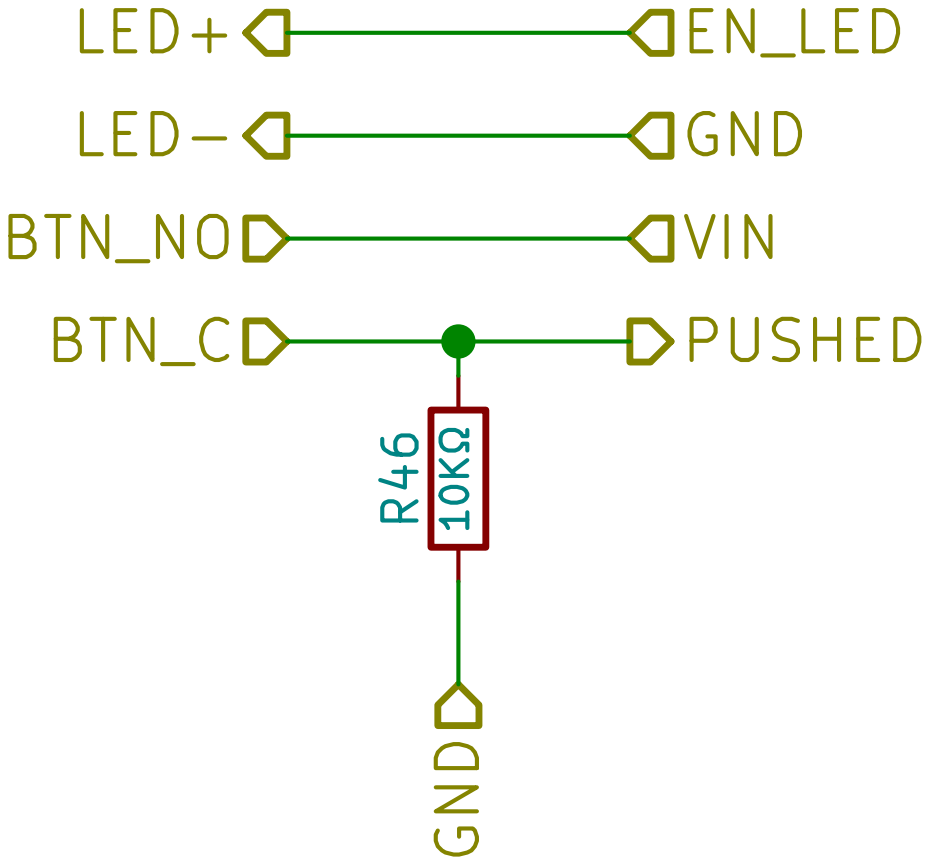
[picture p65: page 18]

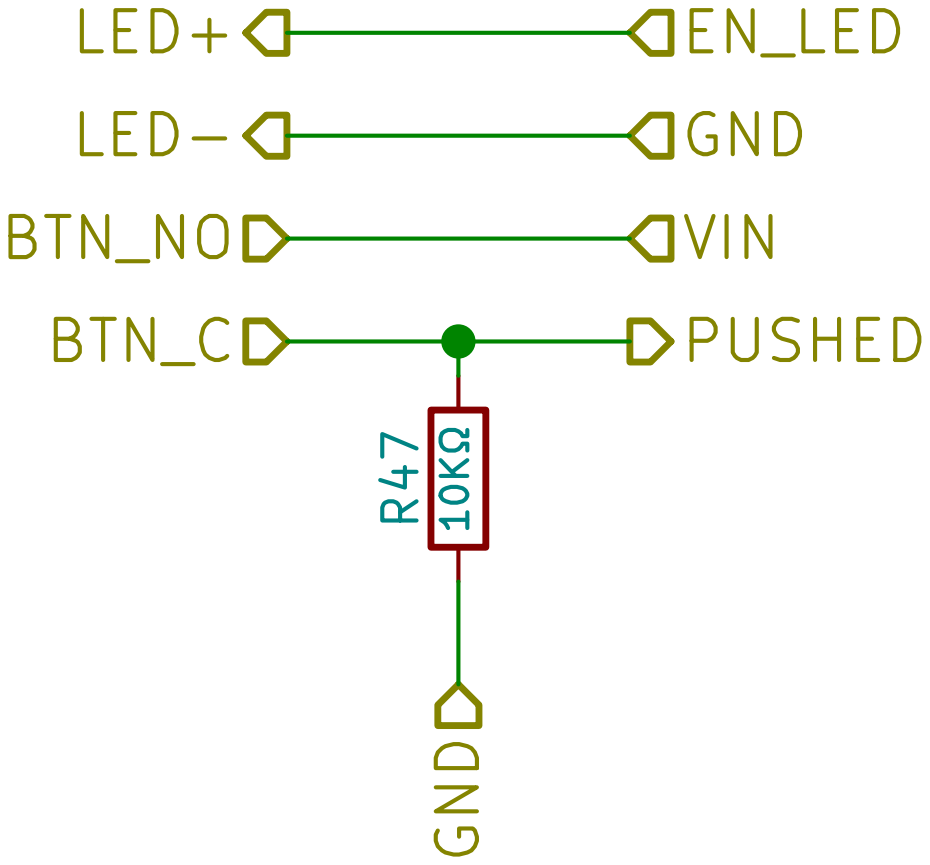
[picture p66: page 19]

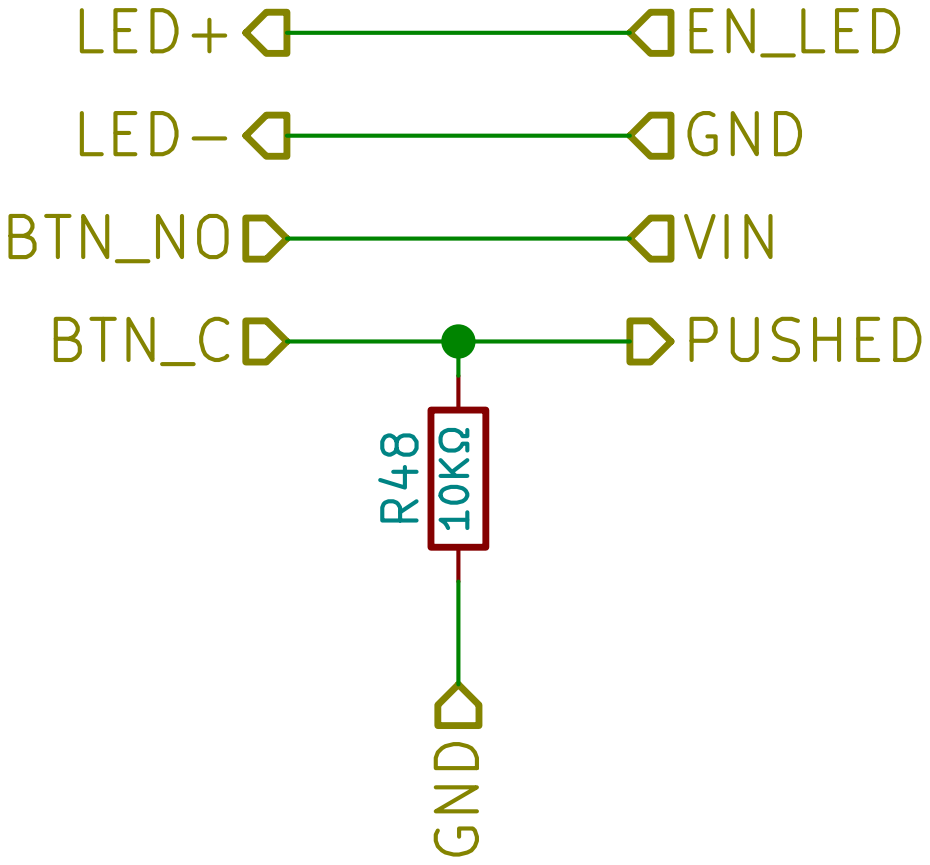
[picture p67: page 20]

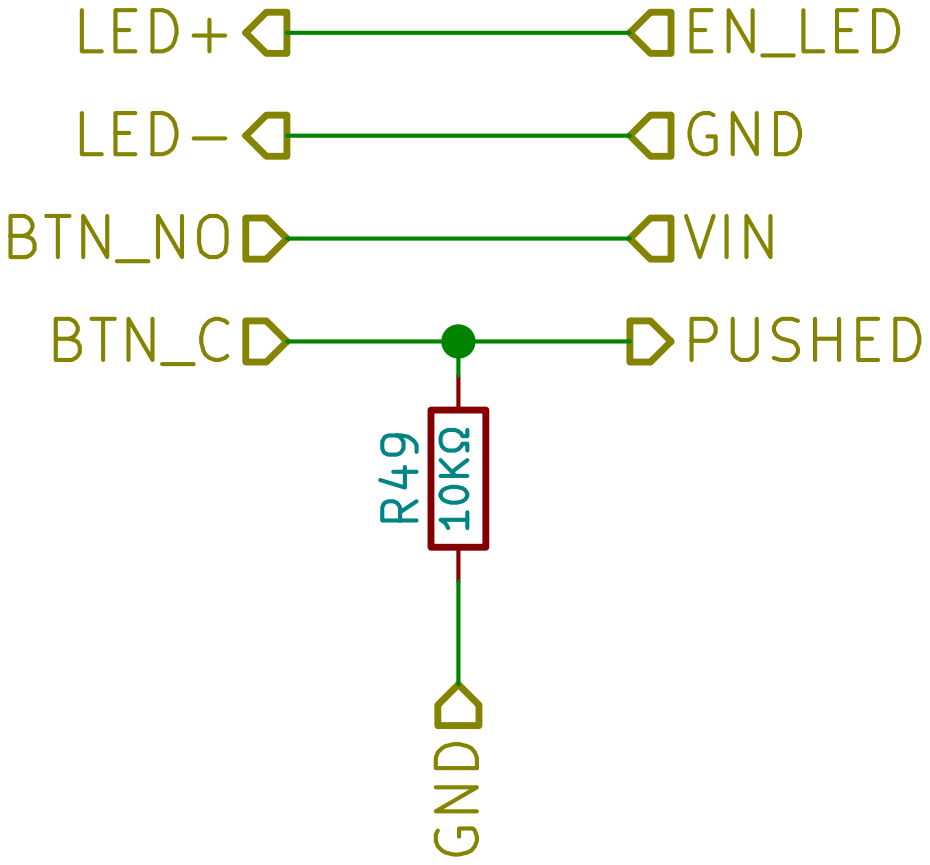
[picture p68: page 21]

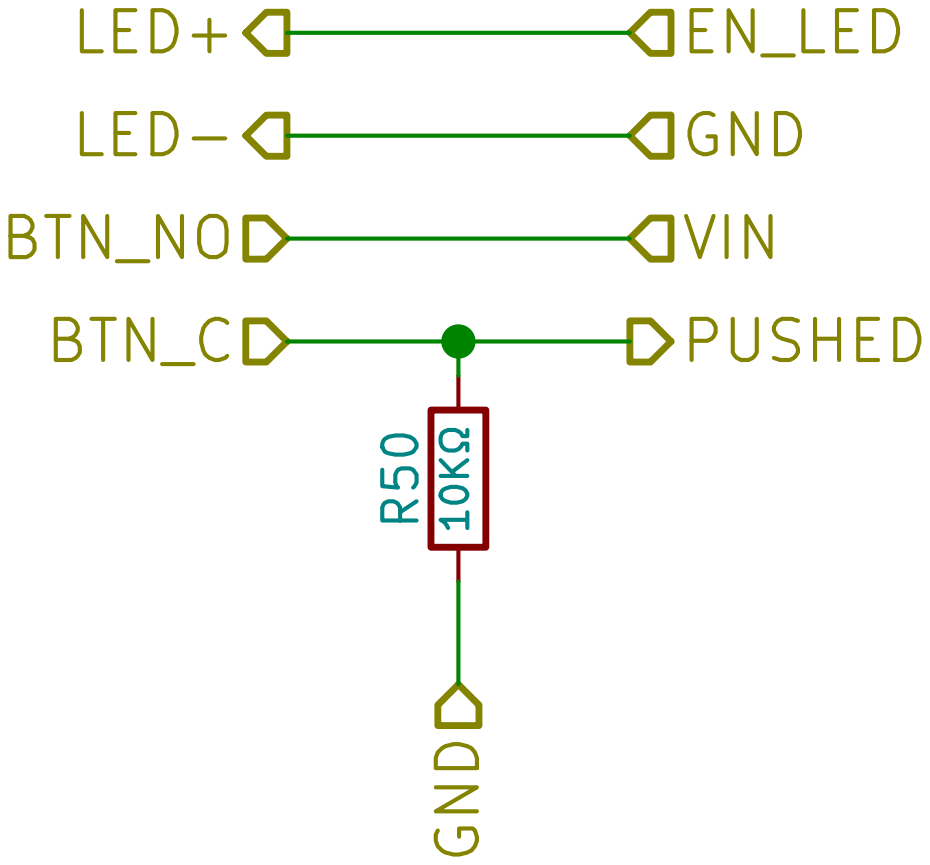
[picture p69: page 22]

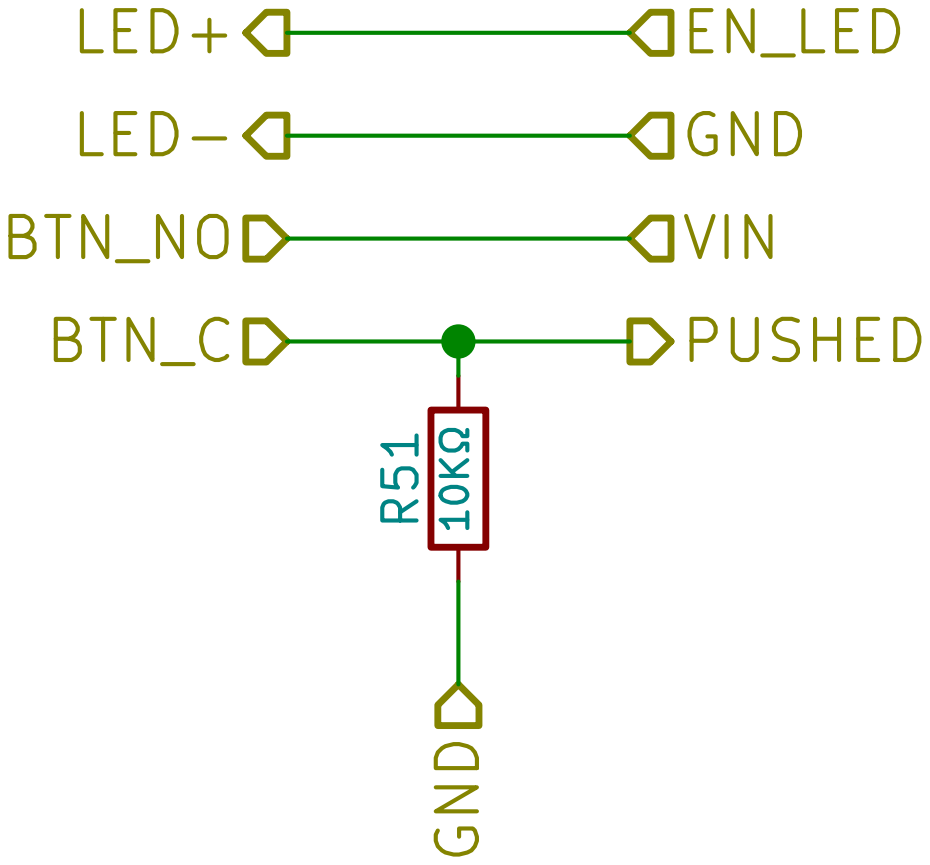
[picture p70: page 23]

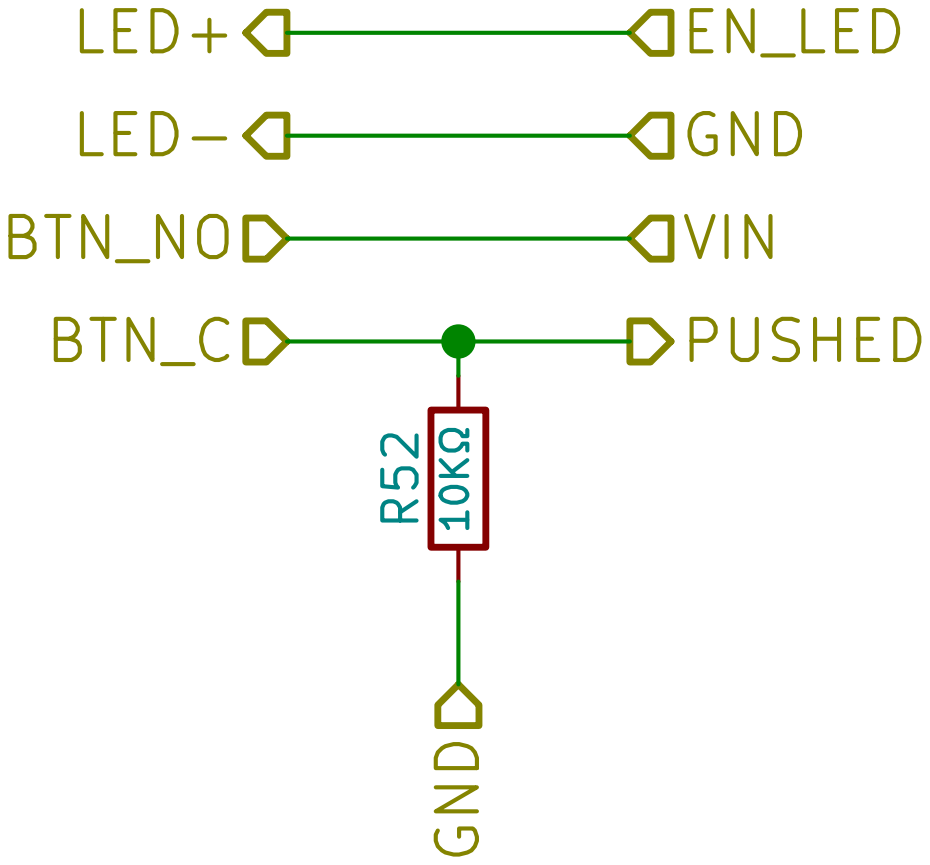
[picture p71: page 24]

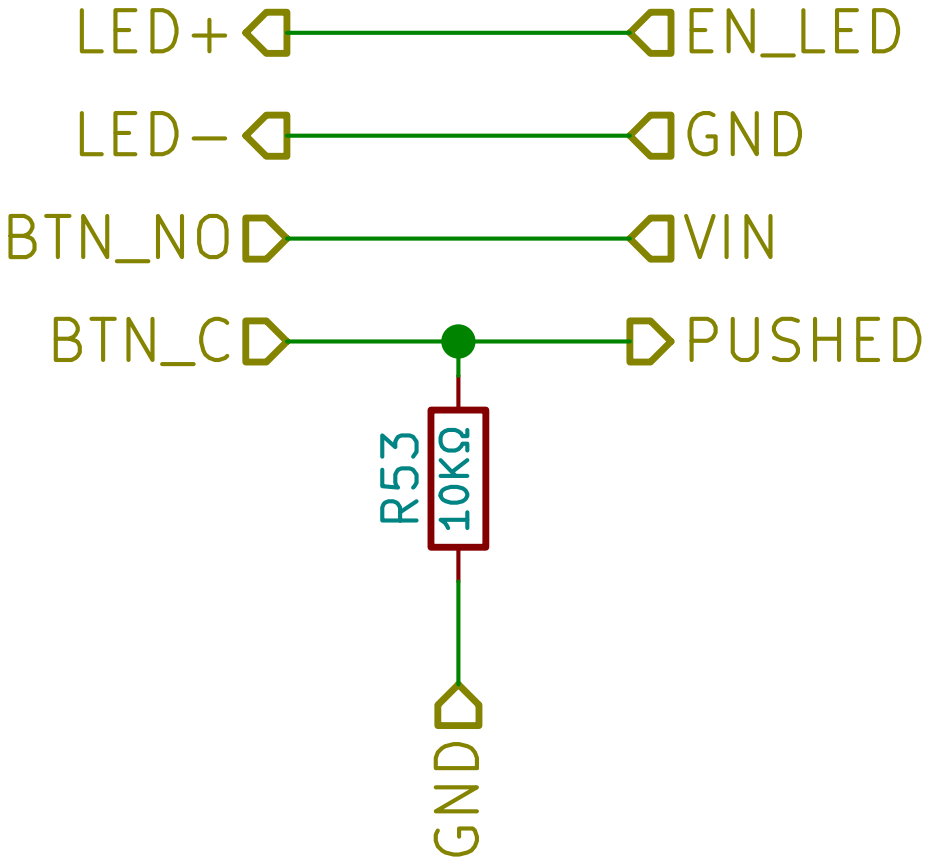
[picture p72: page 25]

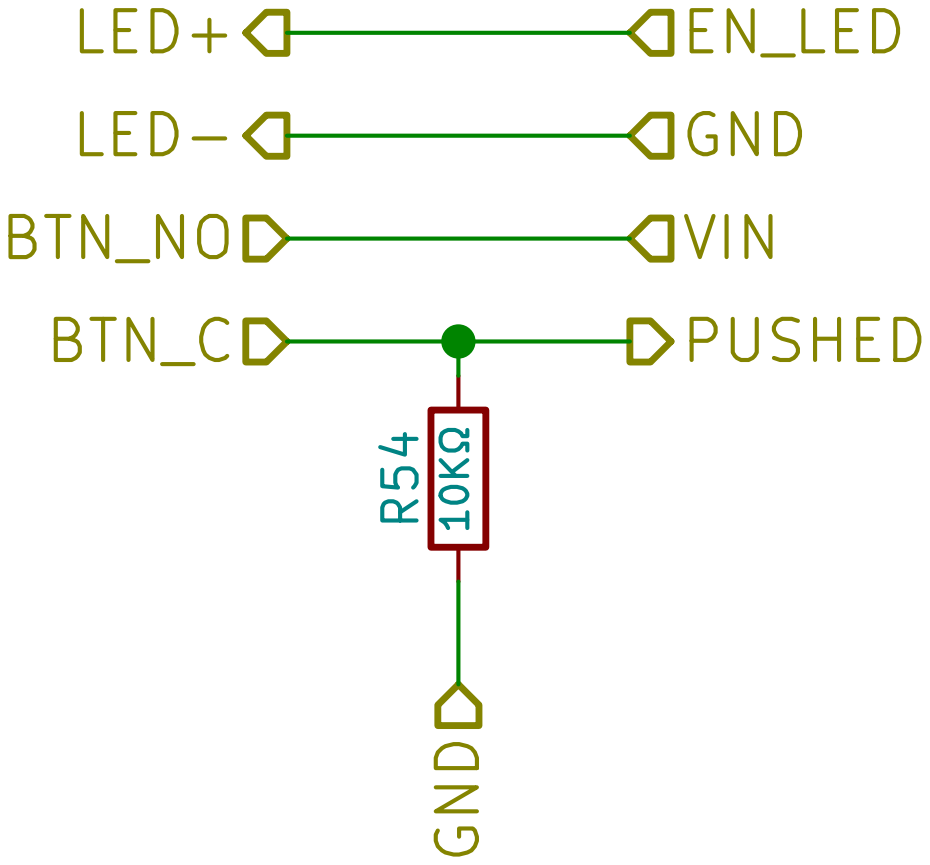
[picture p73: page 26]

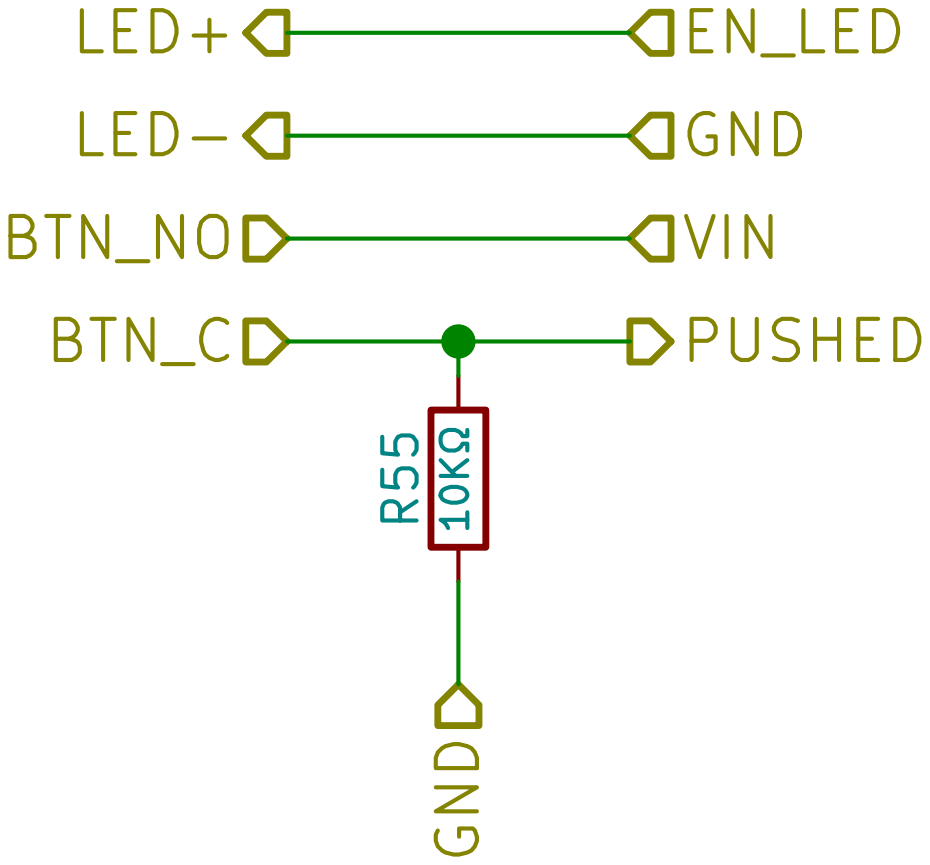
[picture p74: page 27]

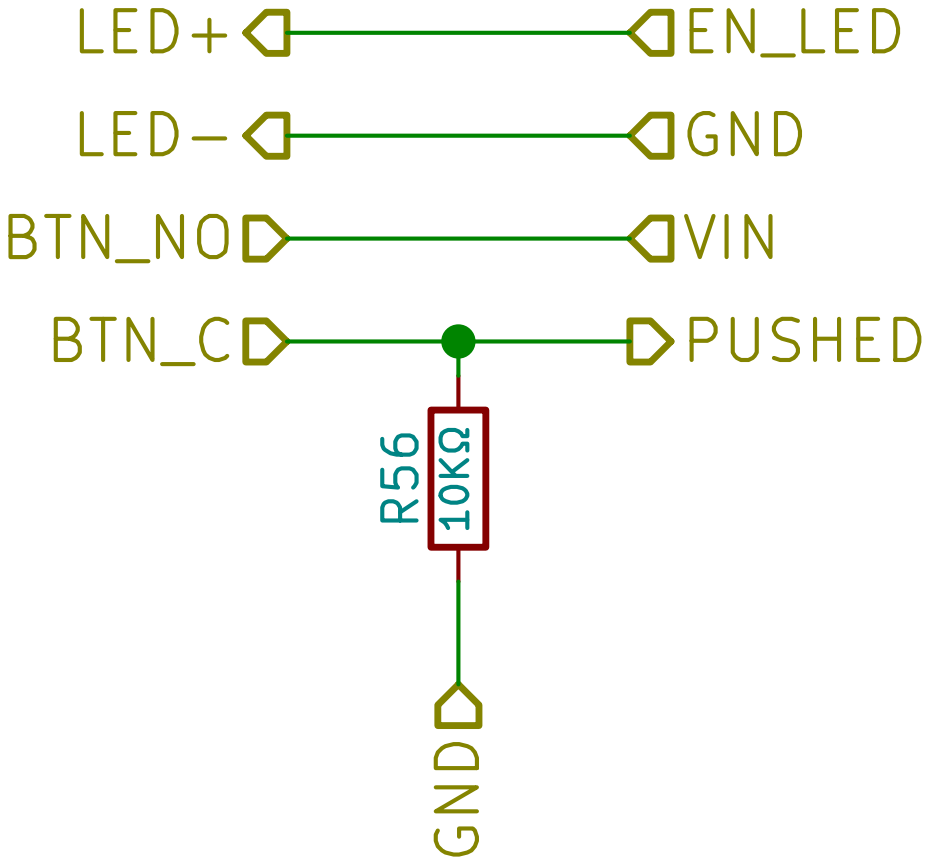
[picture p75: page 28]

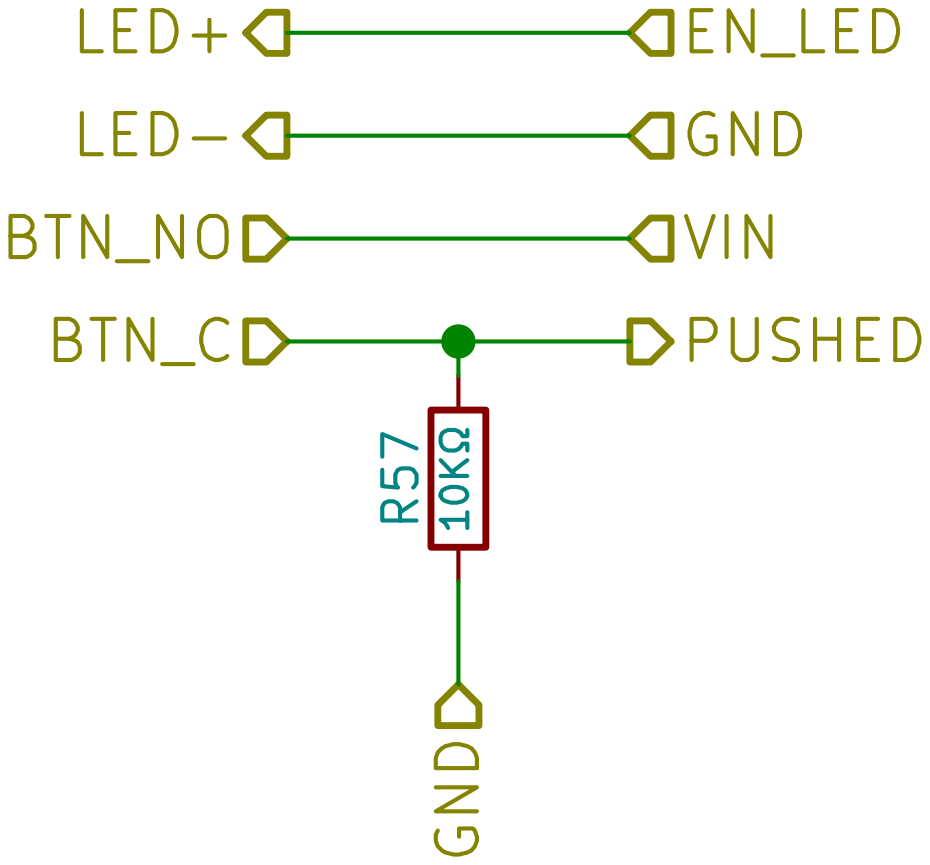
[picture p76: page 29]

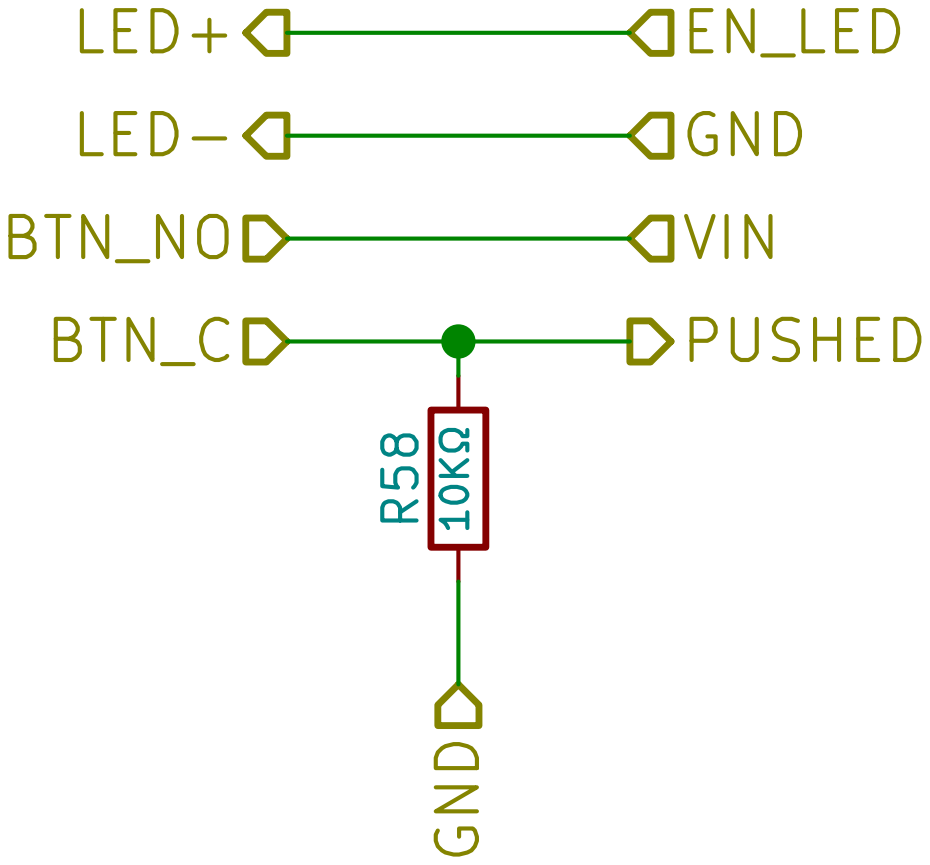
[picture p77: page 30]

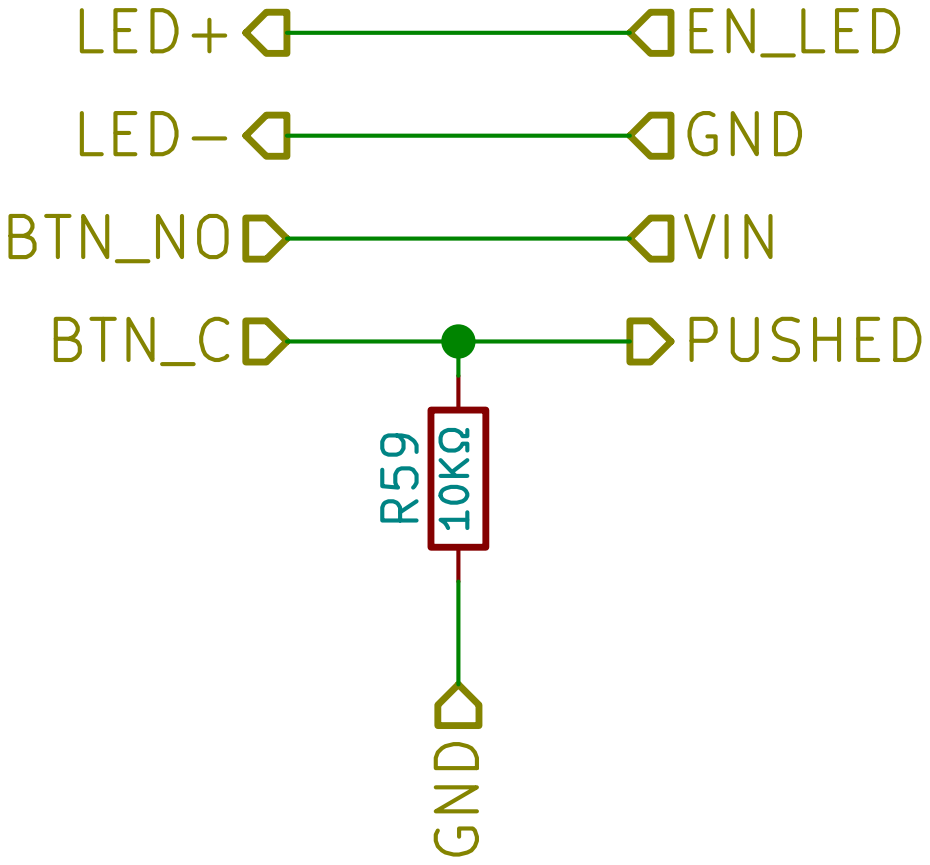
[picture p78: page 31]

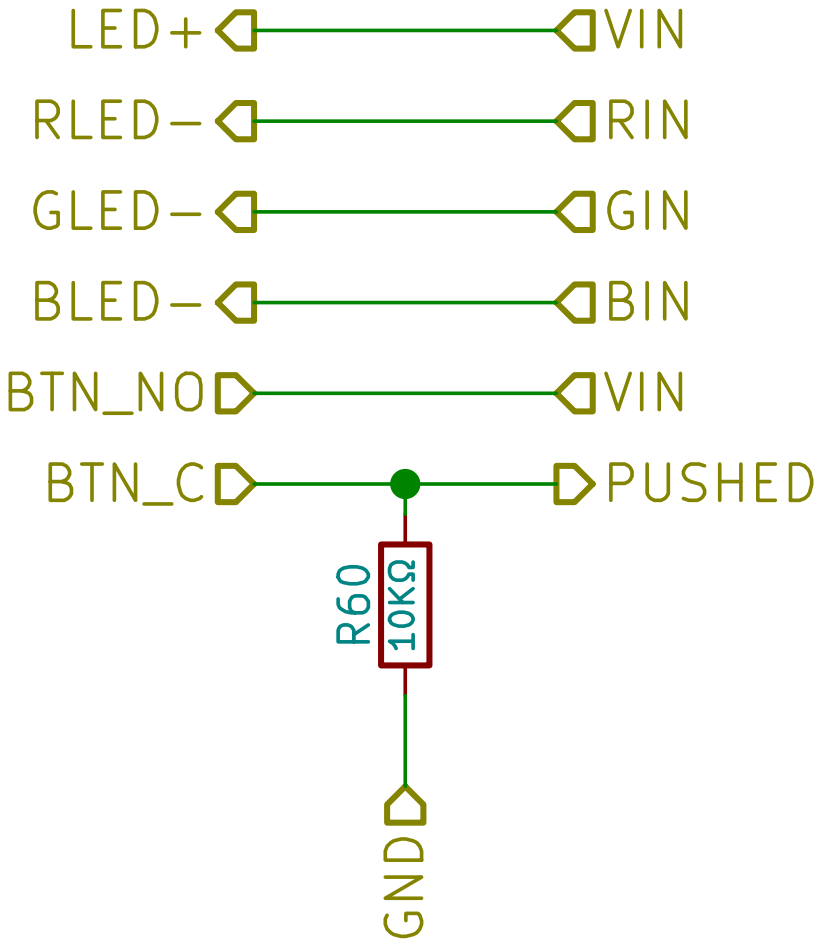
[picture p79: page 32]

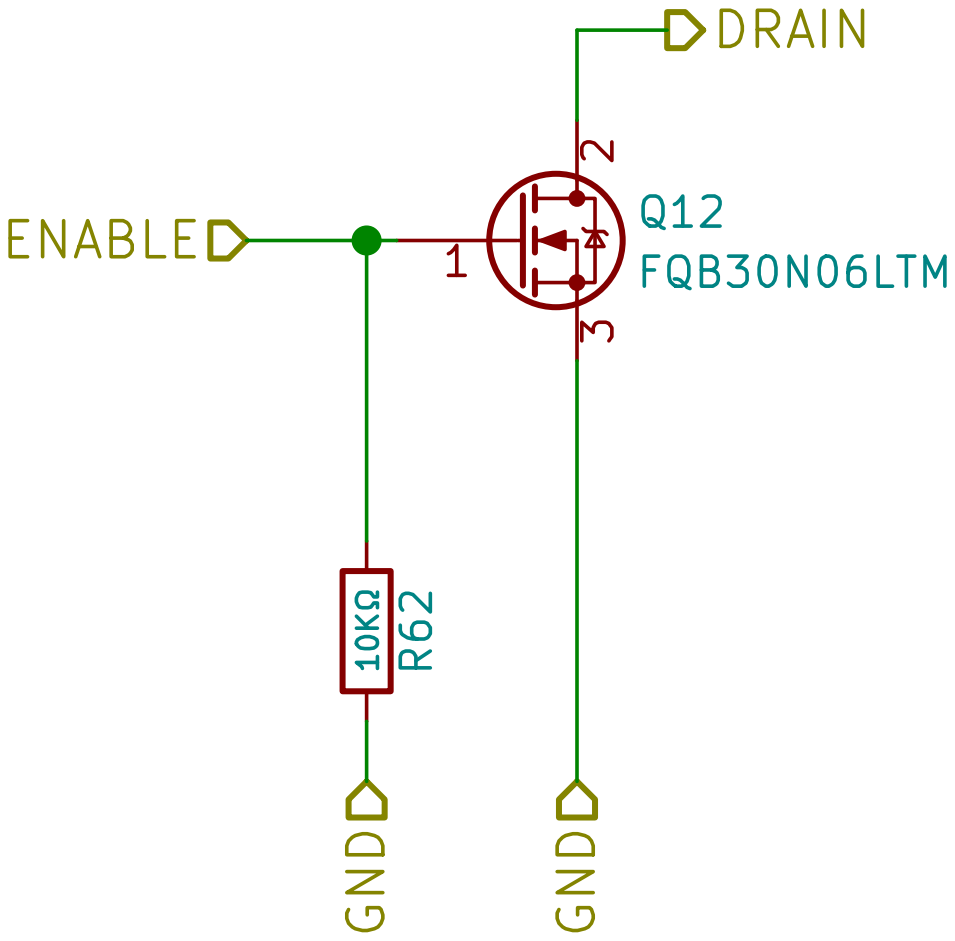
[picture p80: page 33]

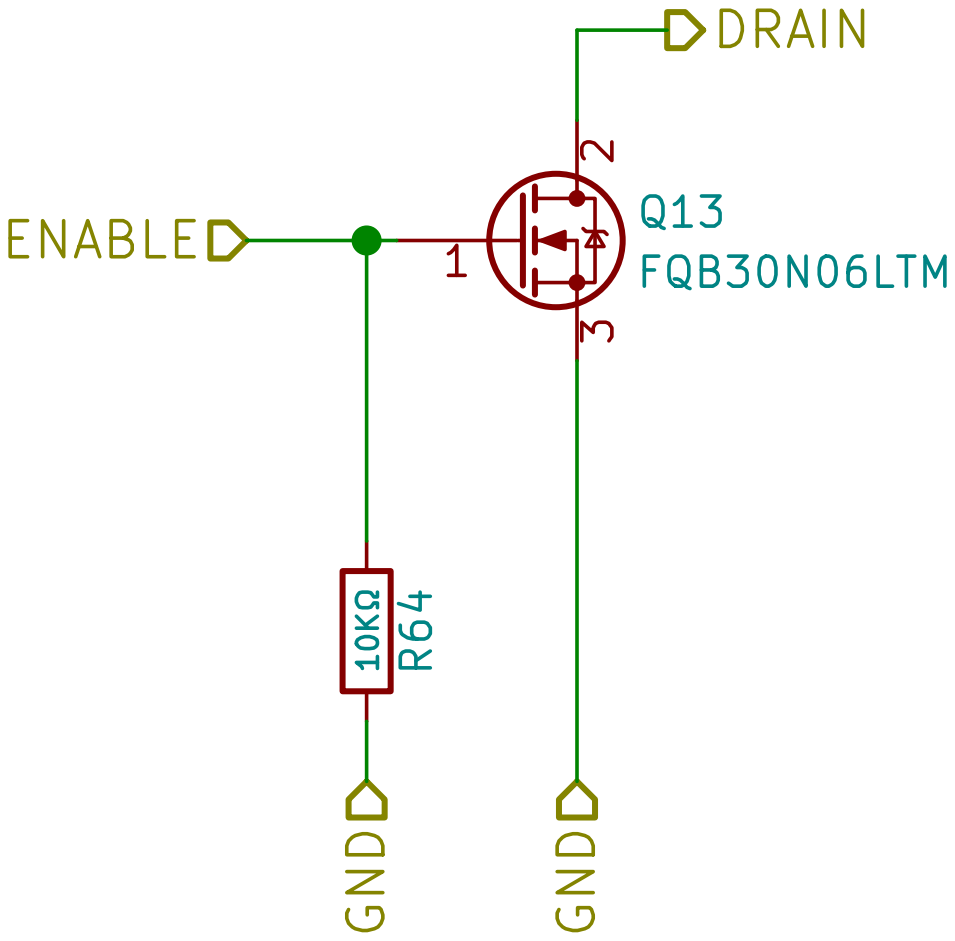
[picture p81: page 34]

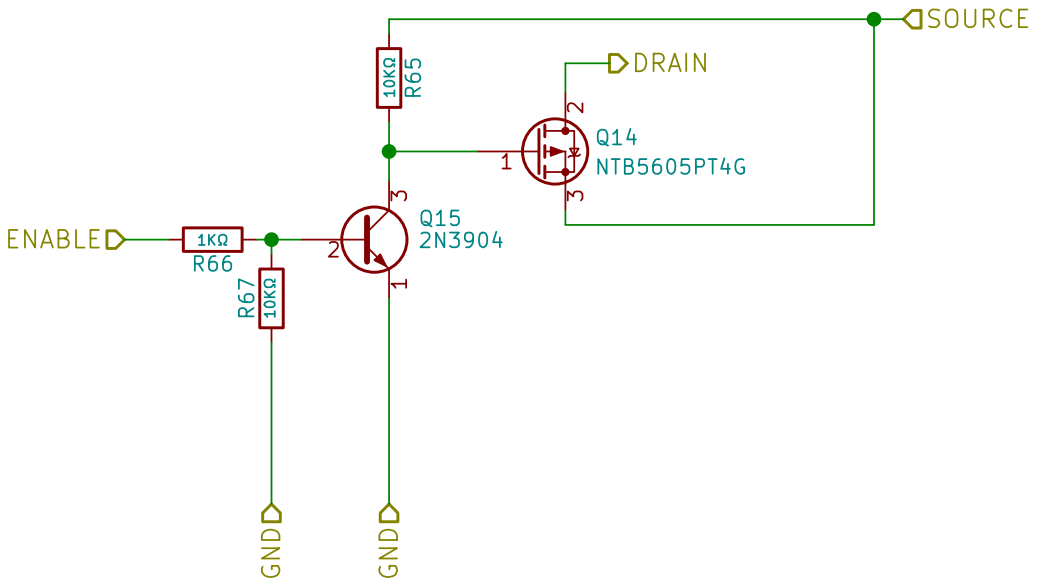
[picture p82: page 35]

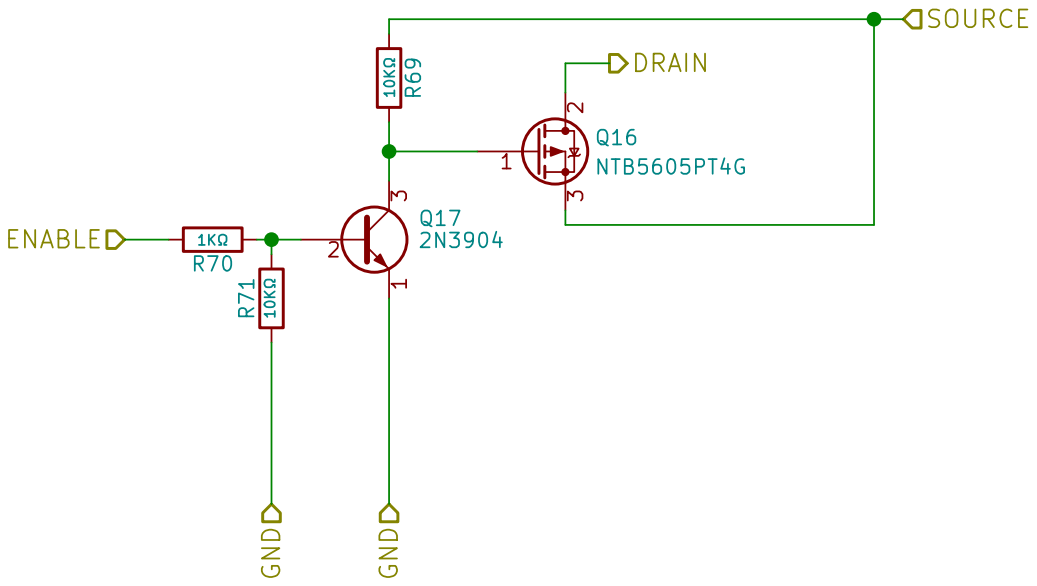
[picture p83: page 36]

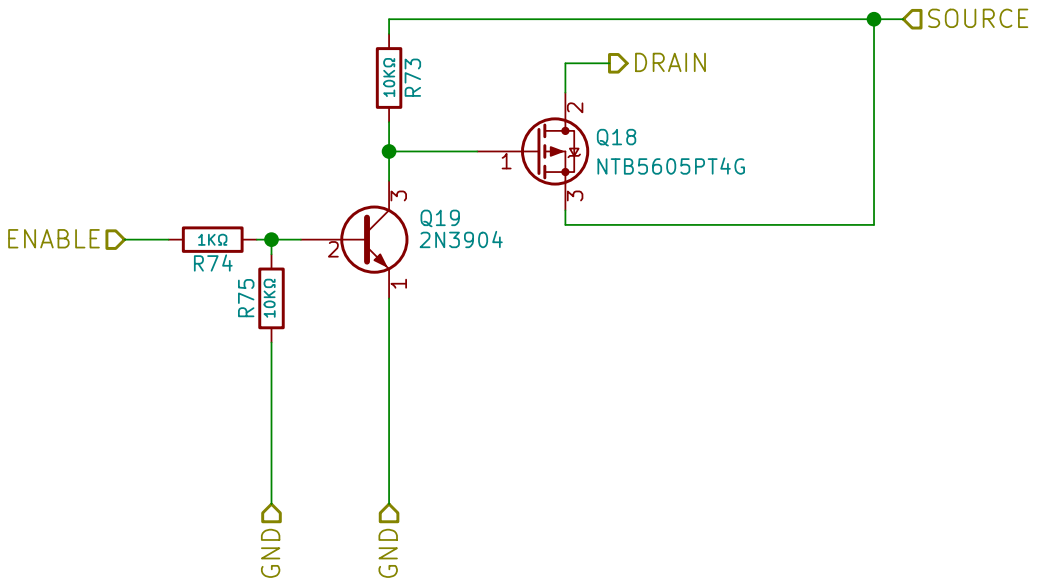
[picture p84: page 37]

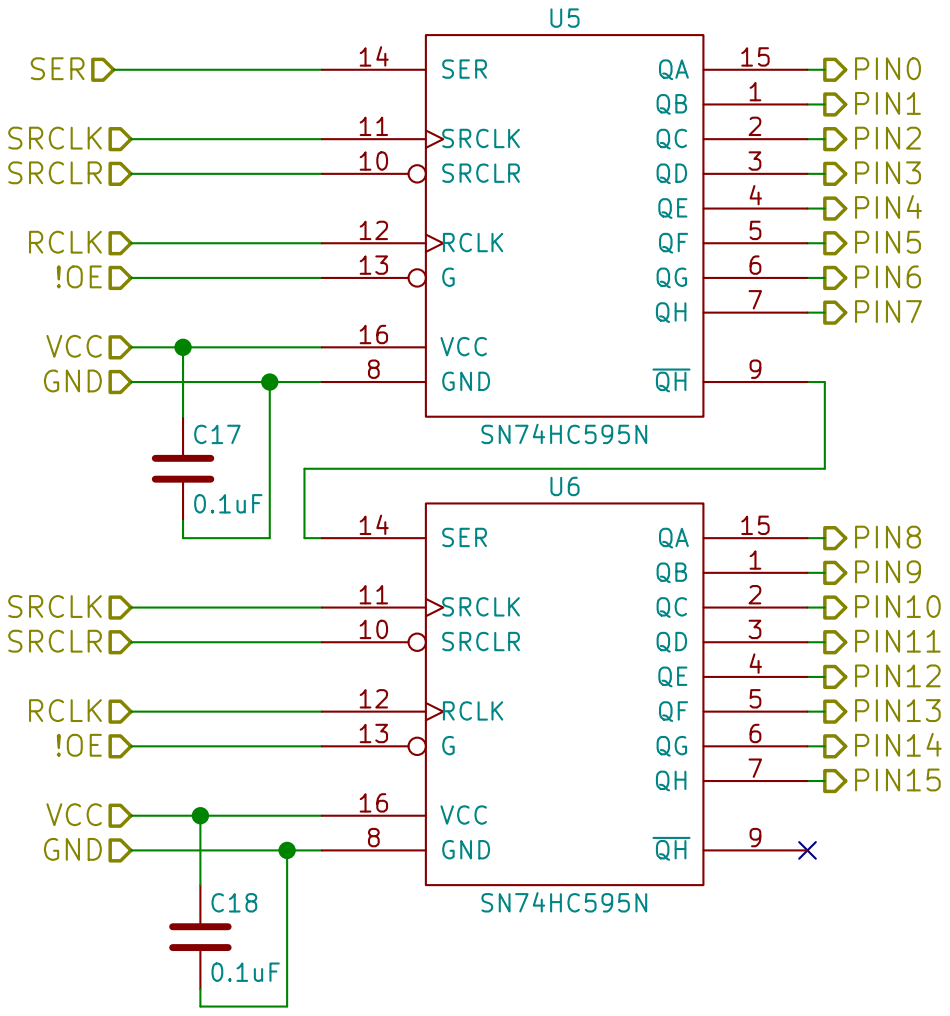
[picture p85: page 38]

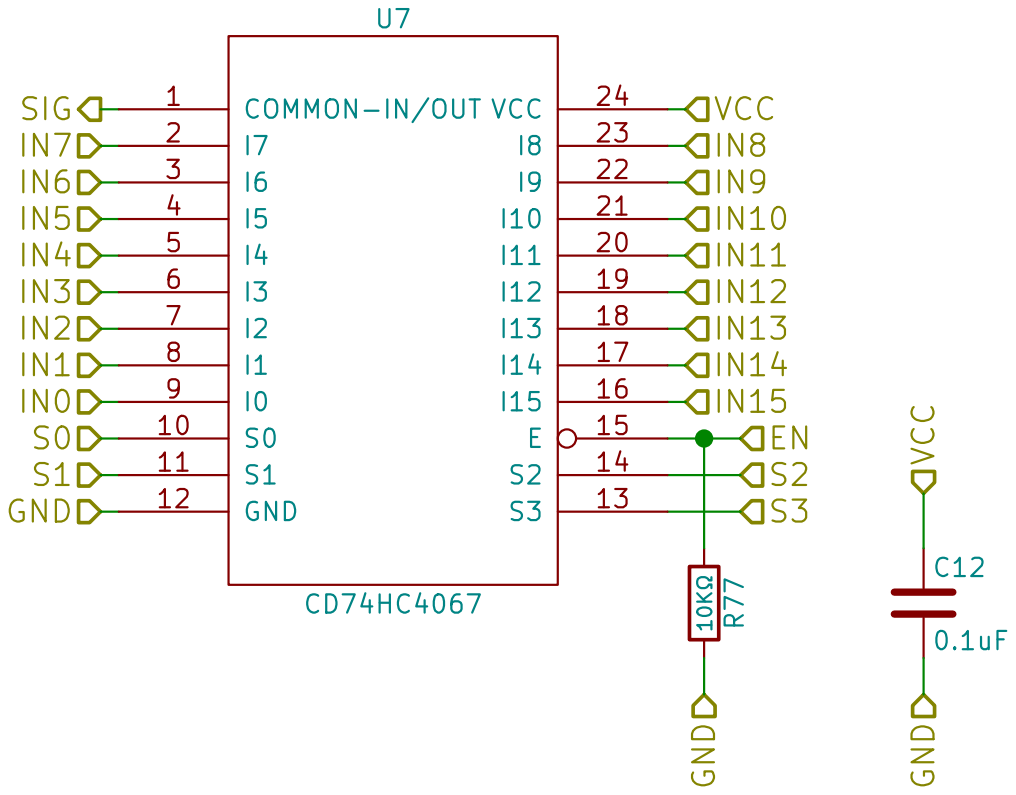
[picture p86: page 39]

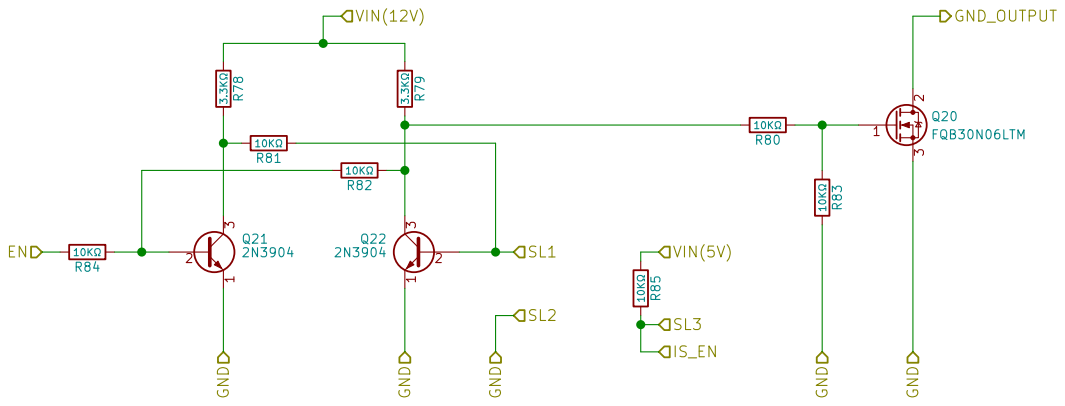
[picture p87: page 40]

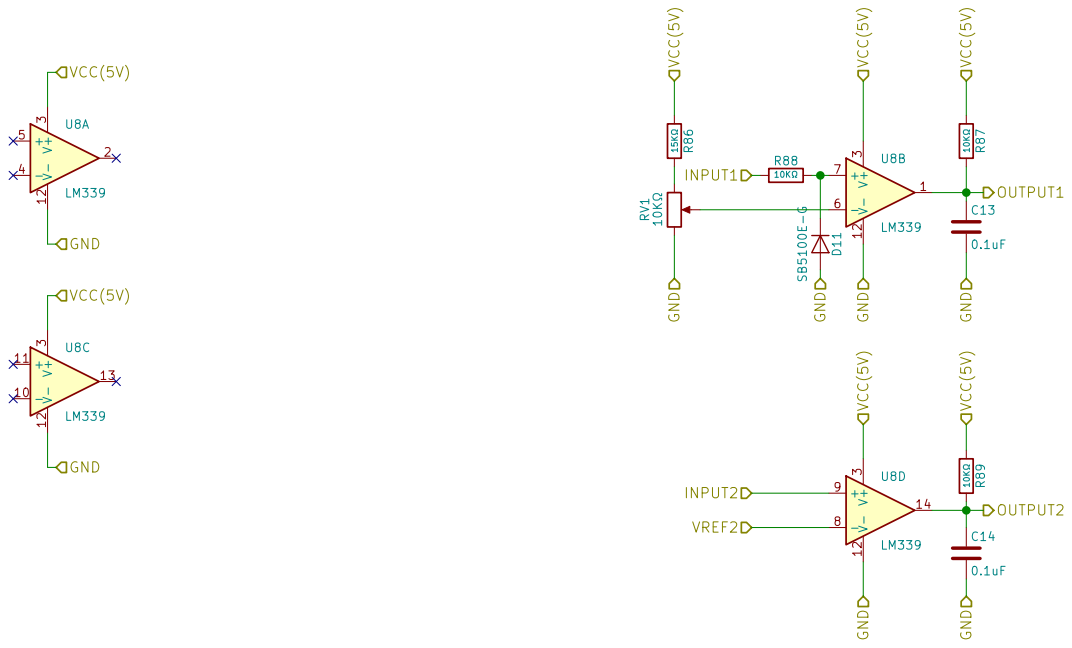
[picture p88: page 41]

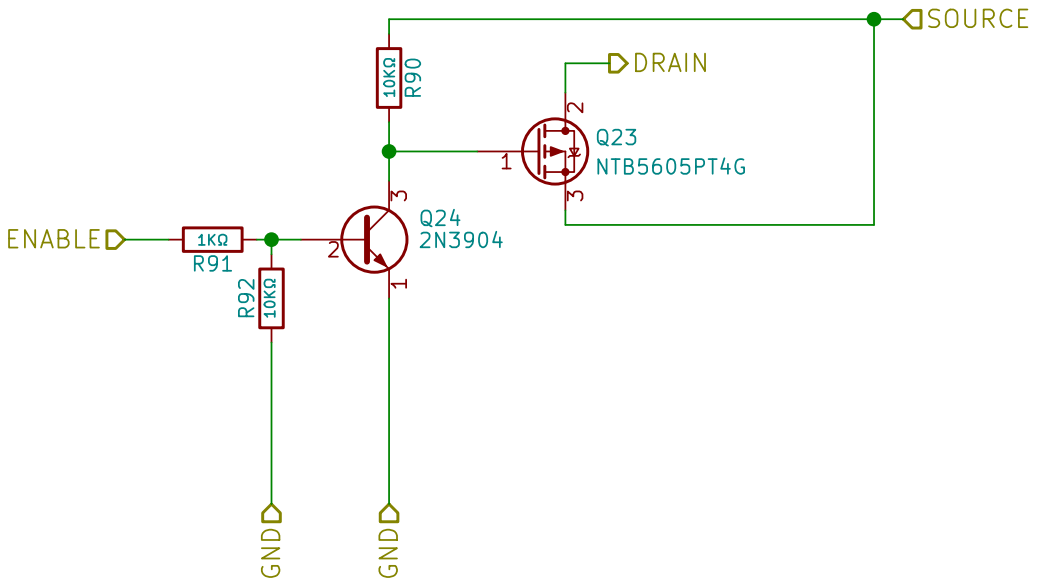
[picture p89: page 42]

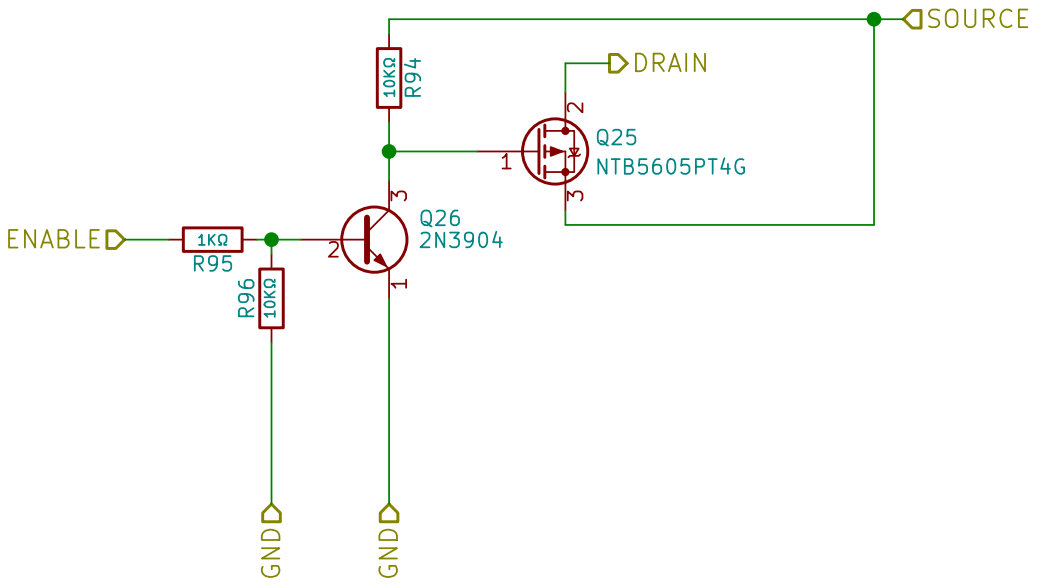
[picture p90: page 43]

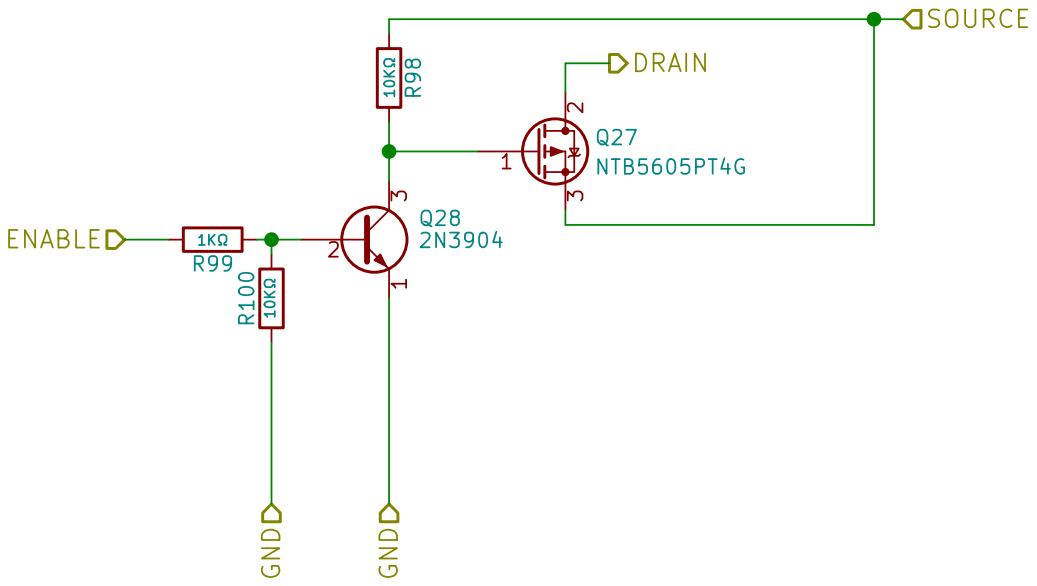
[picture p91: page 44]

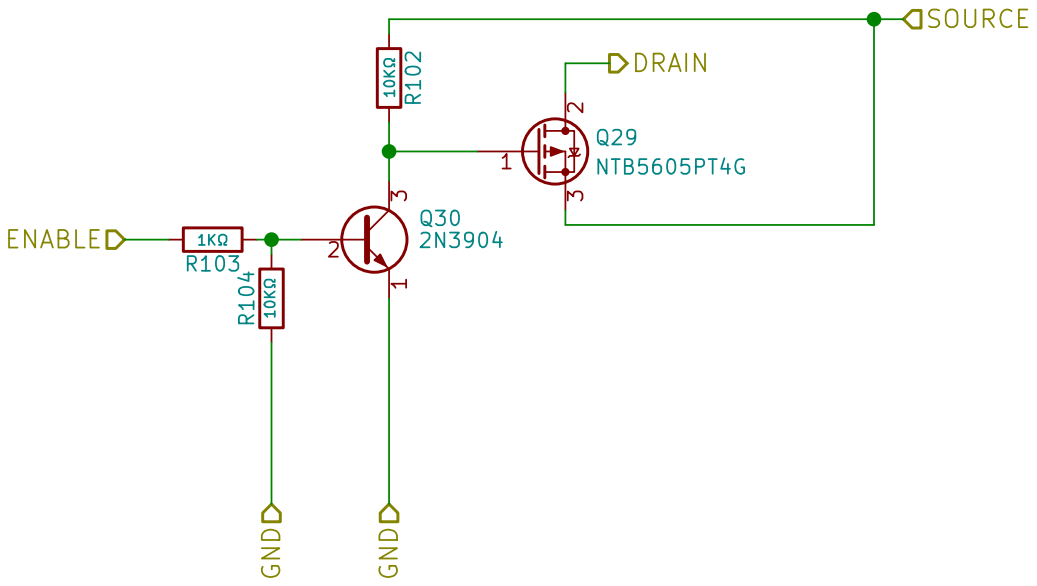
[picture p92: page 45]

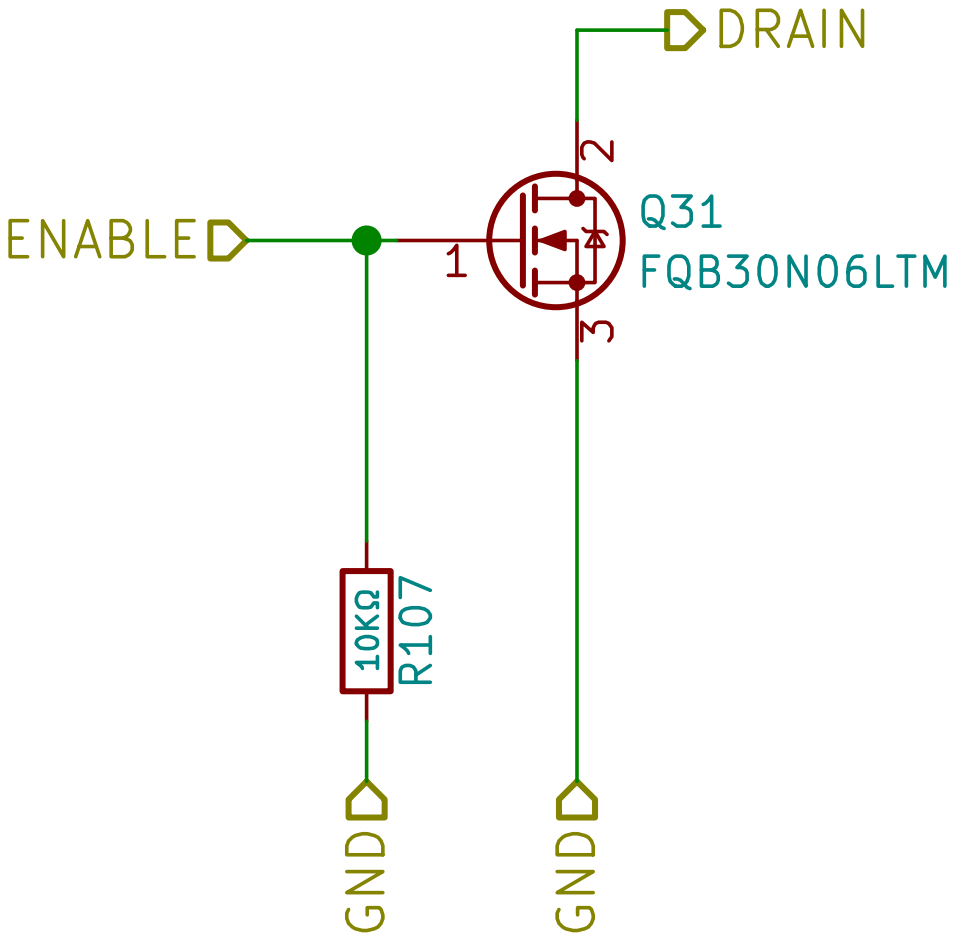
[picture p93: page 46]

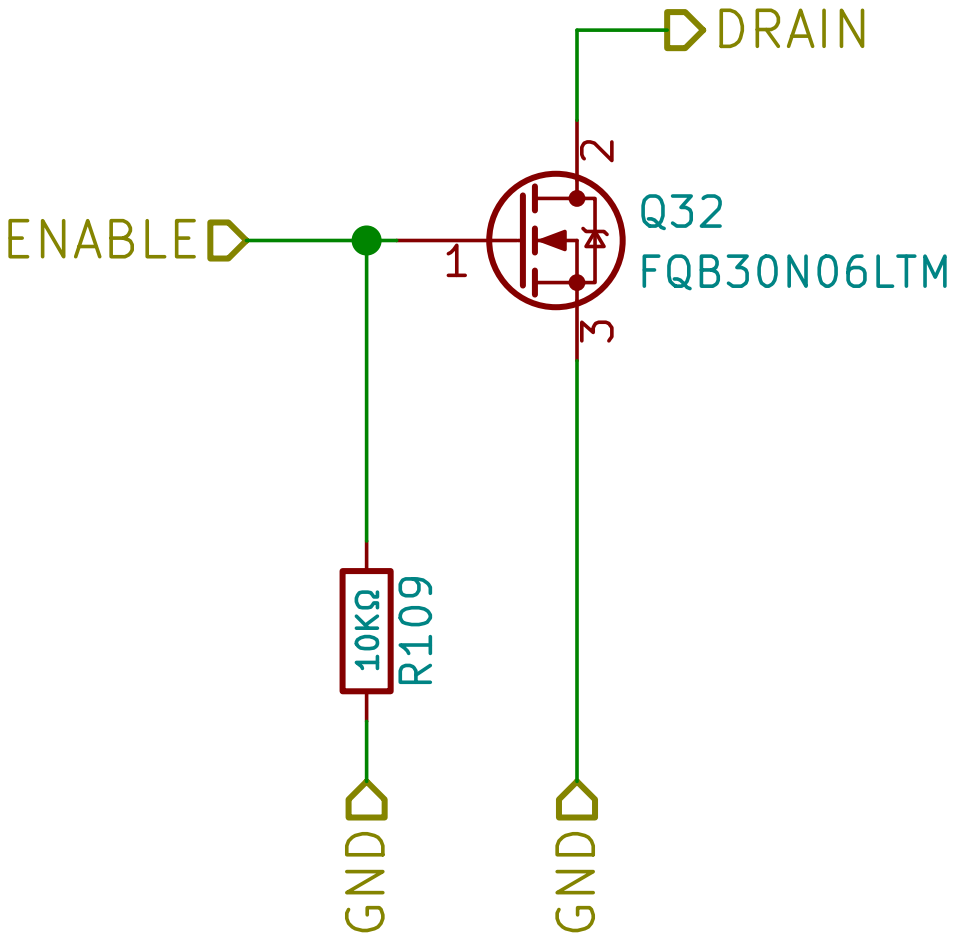
[picture p94: page 47]

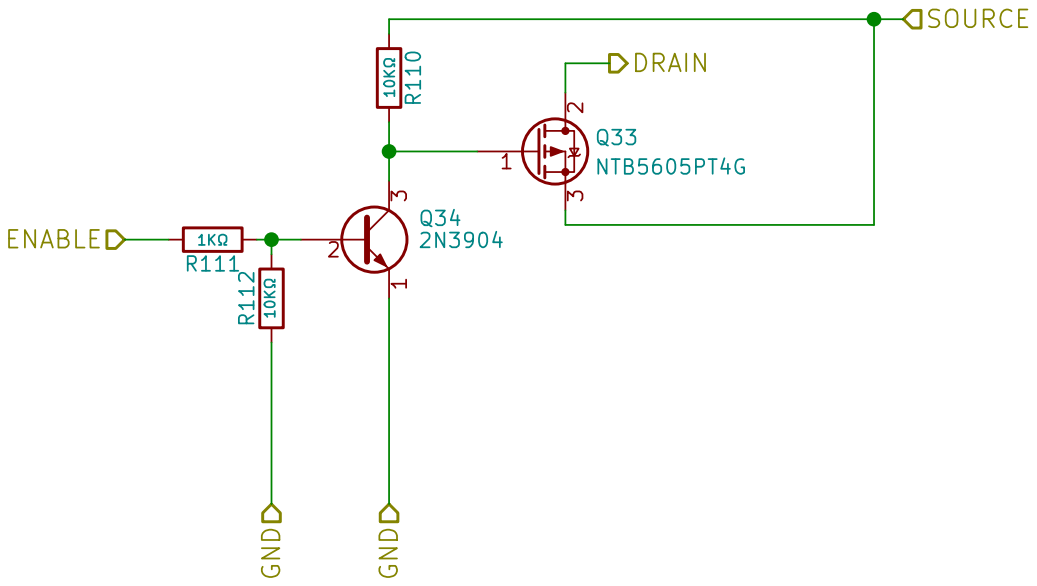
[picture p95: page 48]

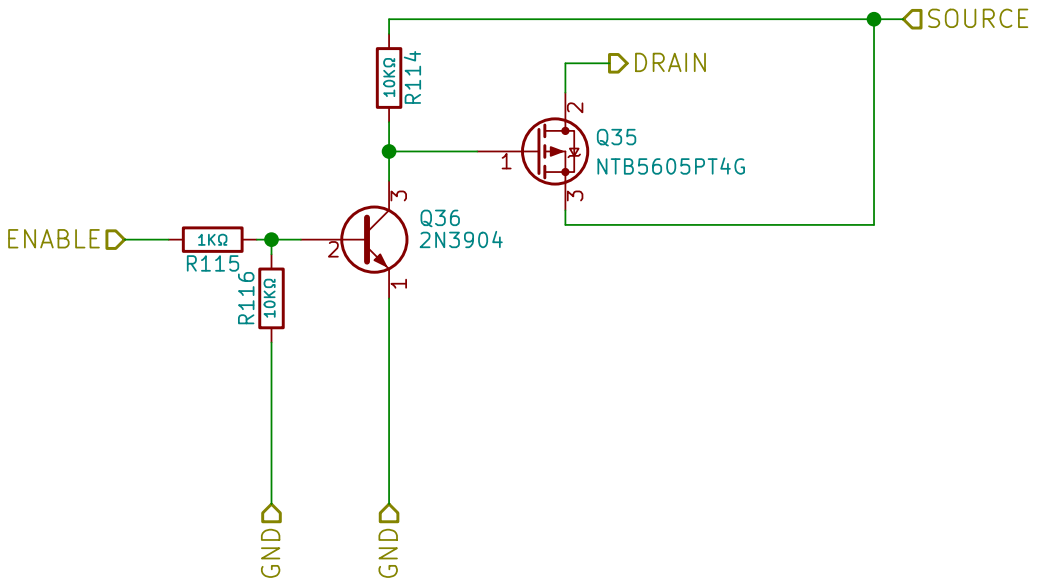
[picture p96: page 49]

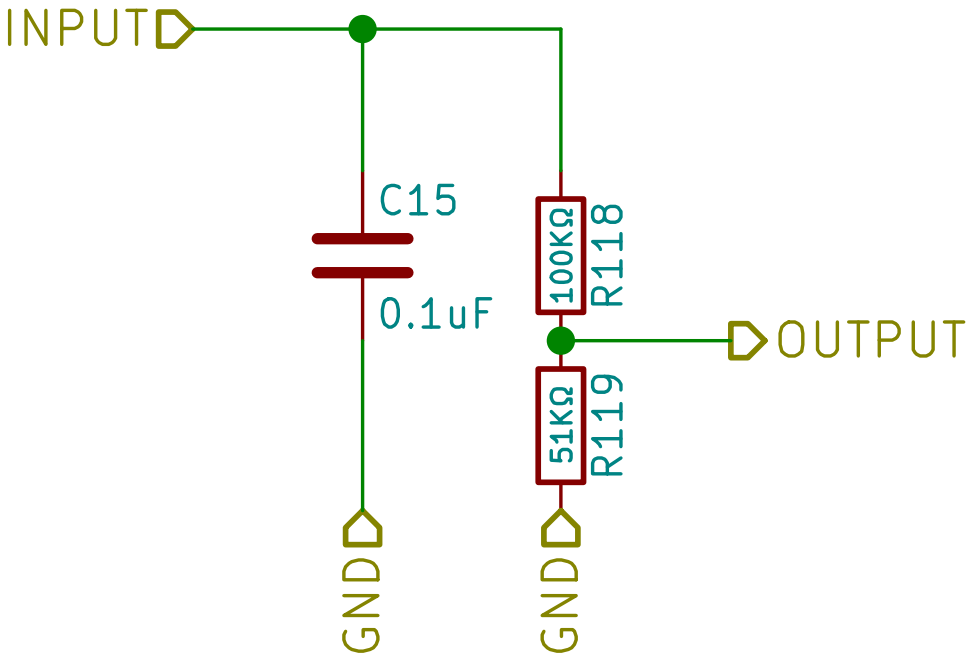
[picture p97: page 50]

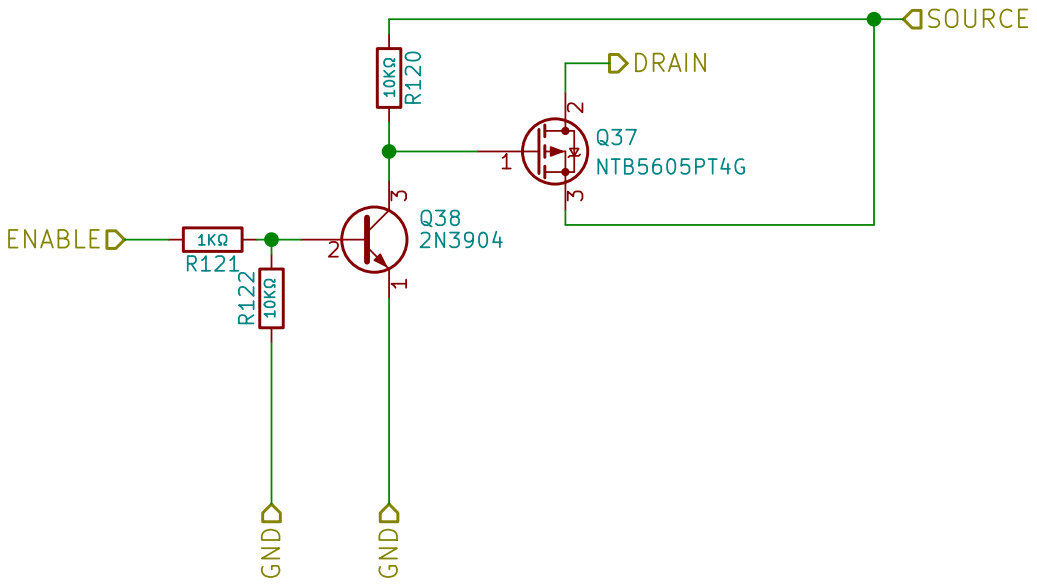
[picture p98: page 51]

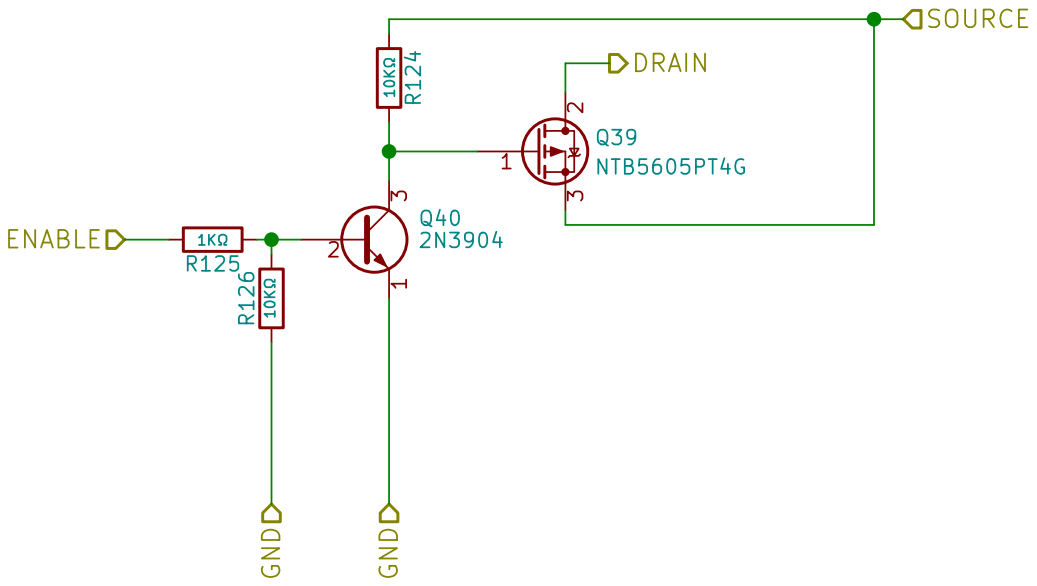
[picture p99: page 52]

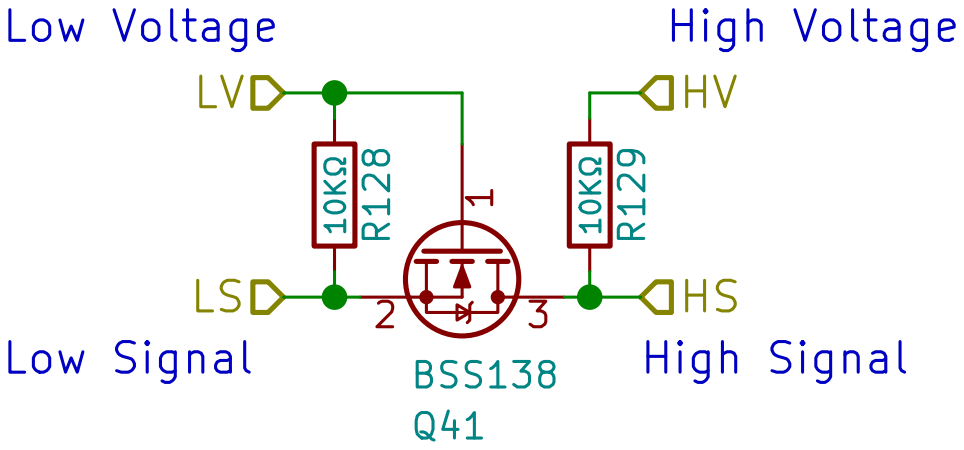
[picture p100: page 53]

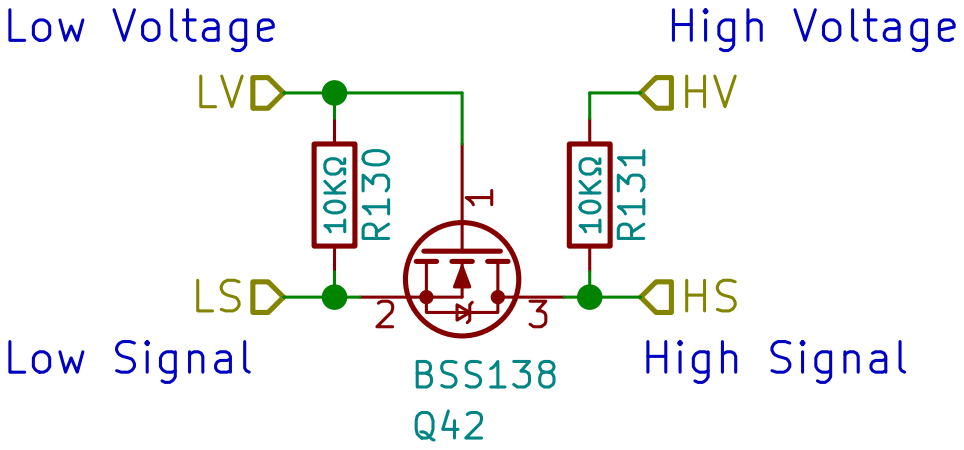
[picture p101: page 54]
