ferdymercury/Controller-Electrical-Schematics/hitchco-mk4-layout-b-cu.pdf

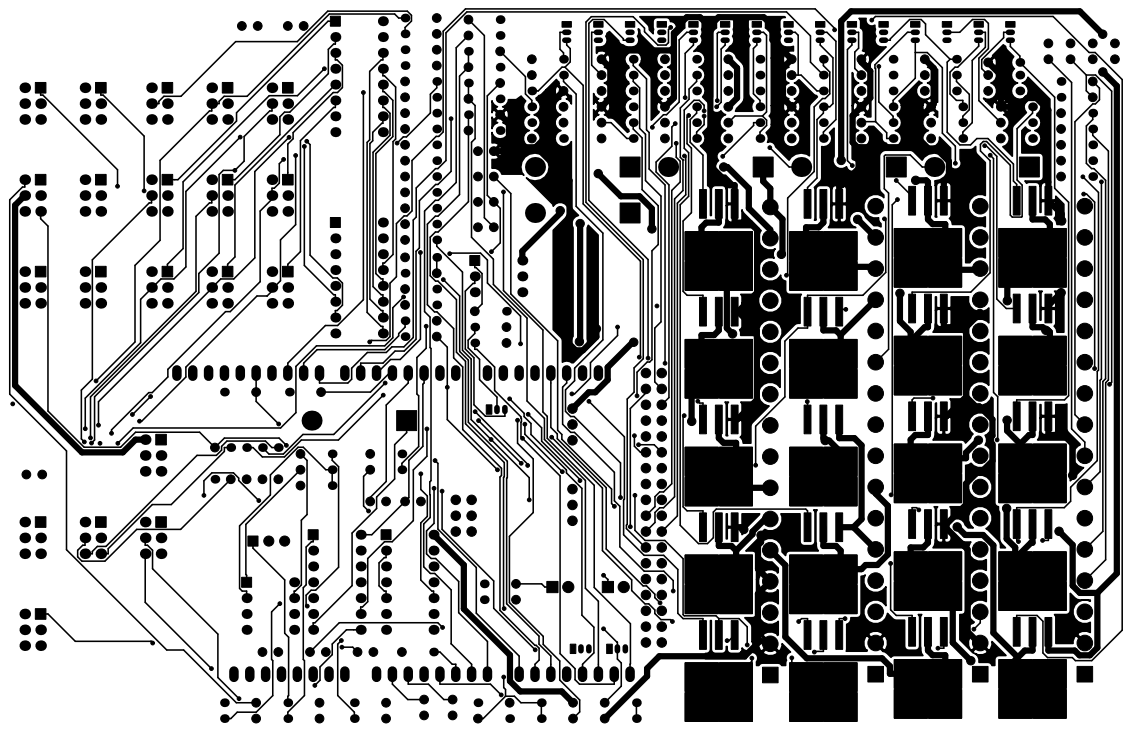
[picture p102: page 1]
