ferdymercury/Controller-Electrical-Schematics/hitchco-mk4-layout-f-cu.pdf

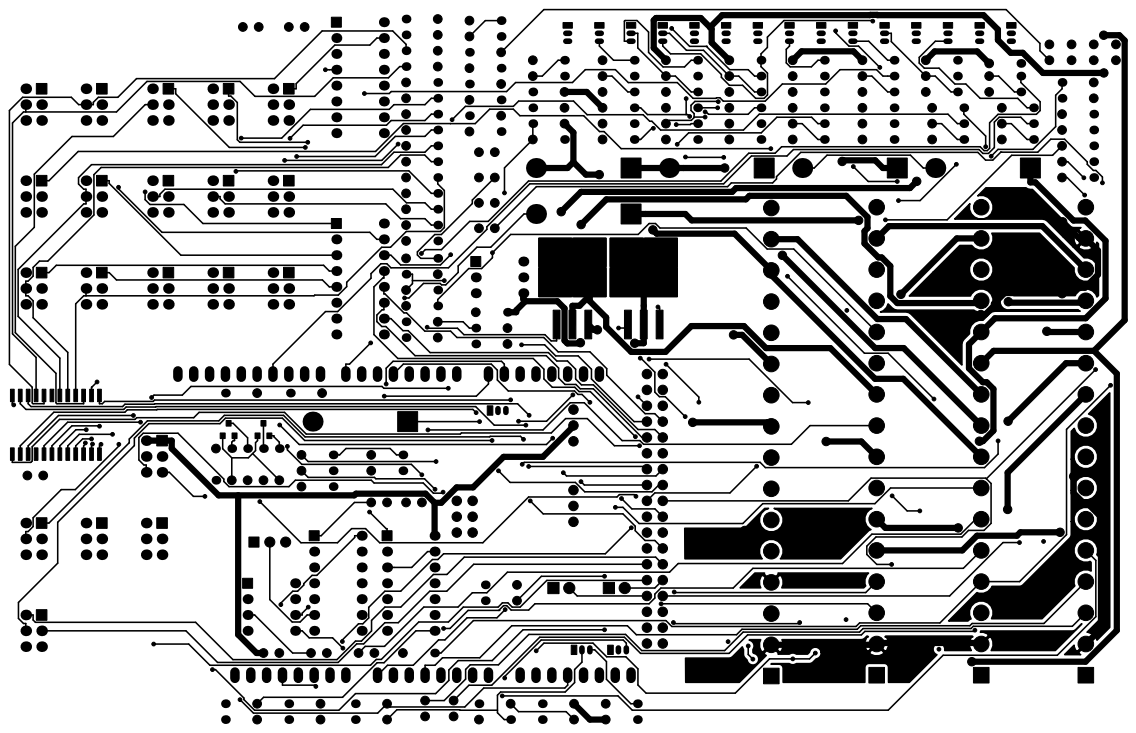
[picture p103: page 1]
