ferdymercury/Controller-Electrical-Schematics/hitchco-mk4-layout-full.pdf

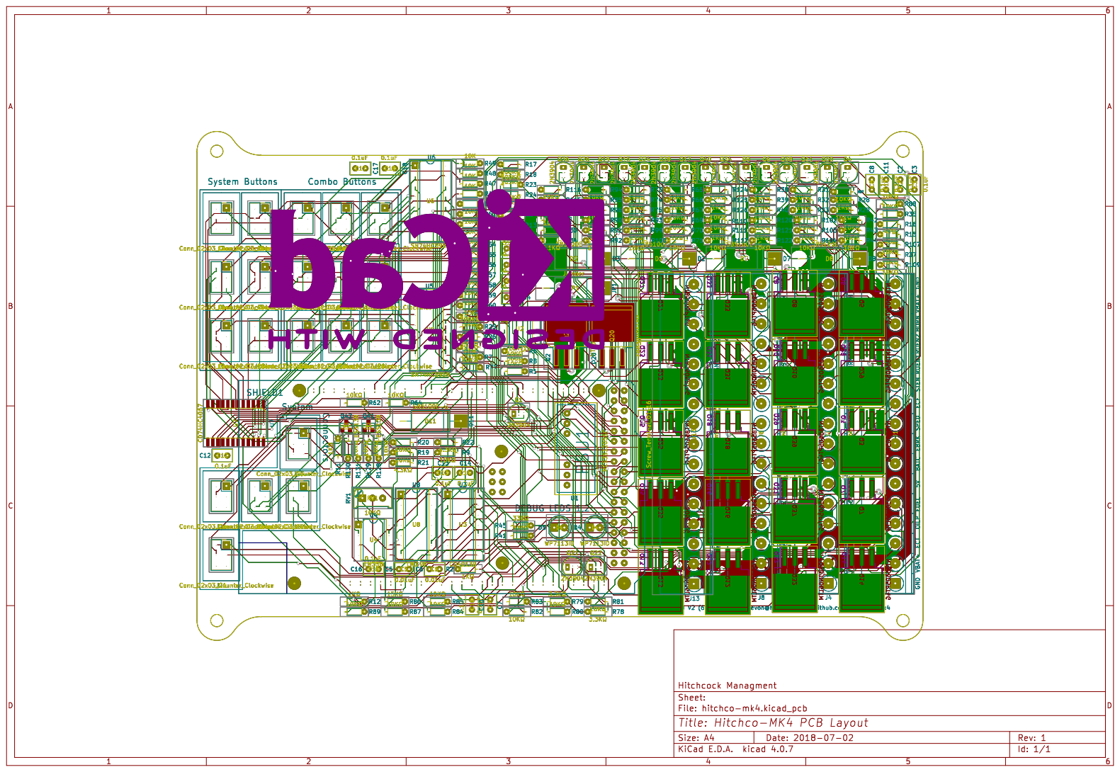
[picture p104: page 1]
