ferdymercury/Controller-Electrical-Schematics/revision-1-do-not-use/mk4-v1-blank-board/hitchco-mk4.pdf

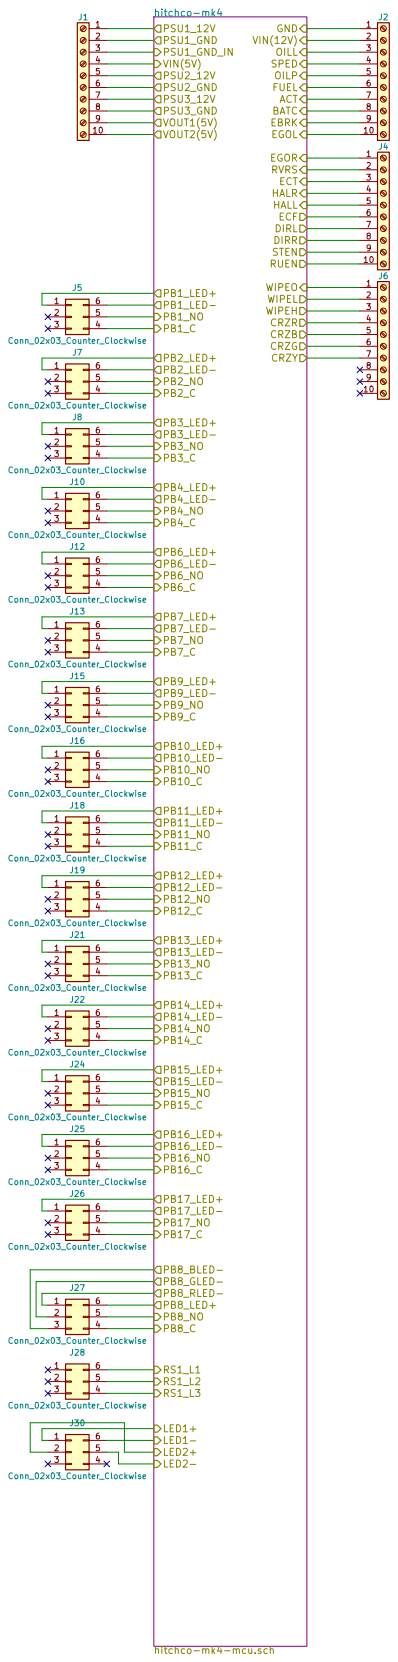
[picture p105: page 1]

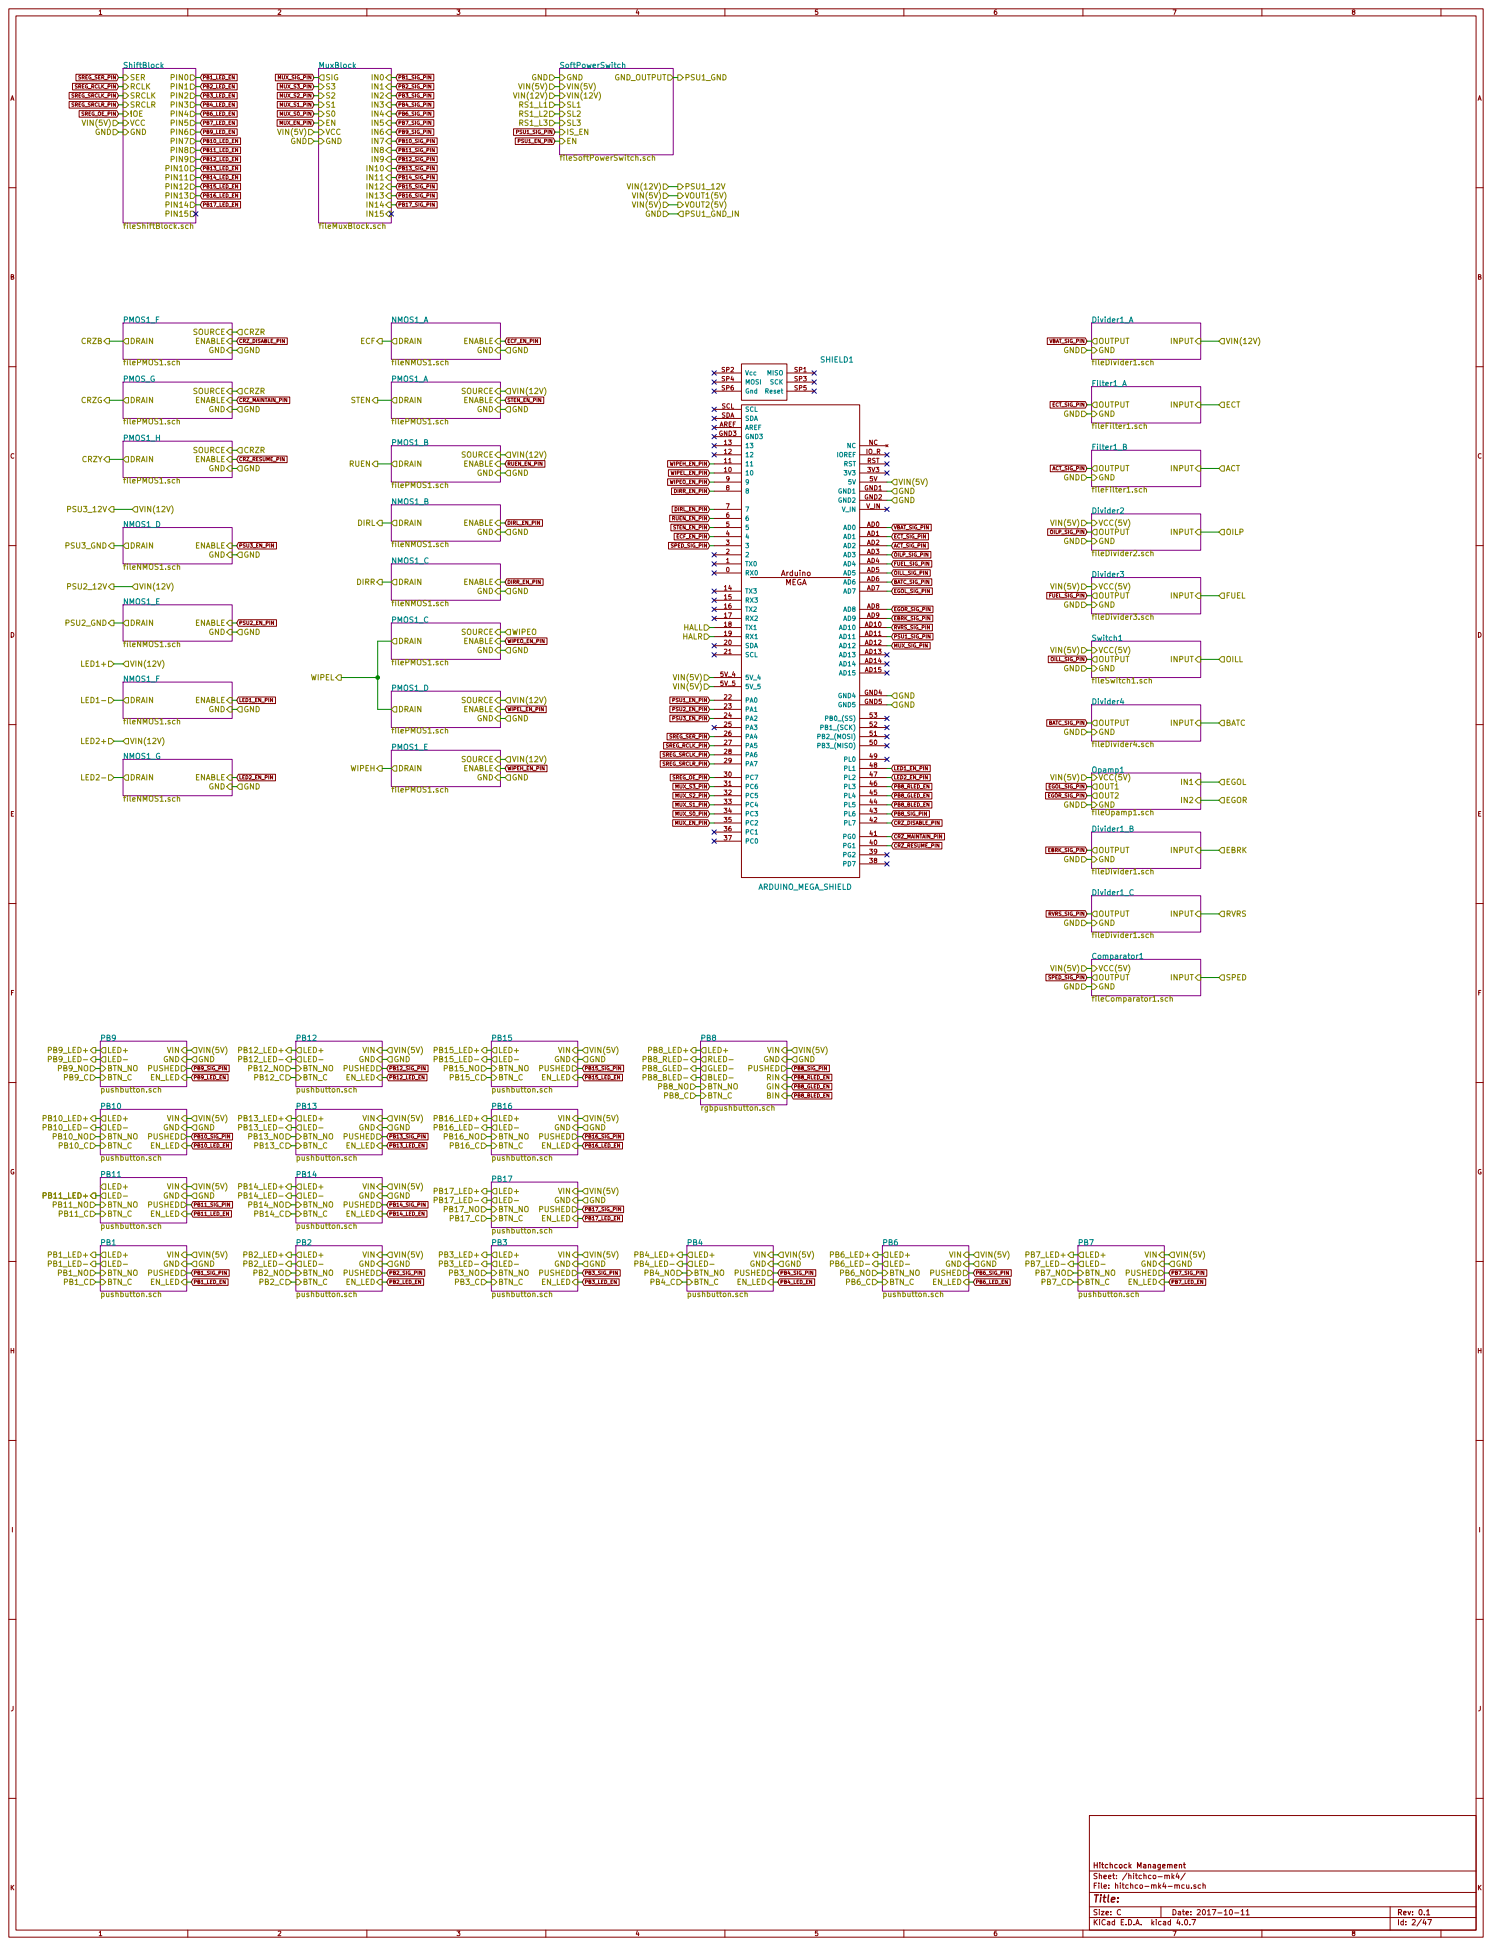
[picture p106: page 2]





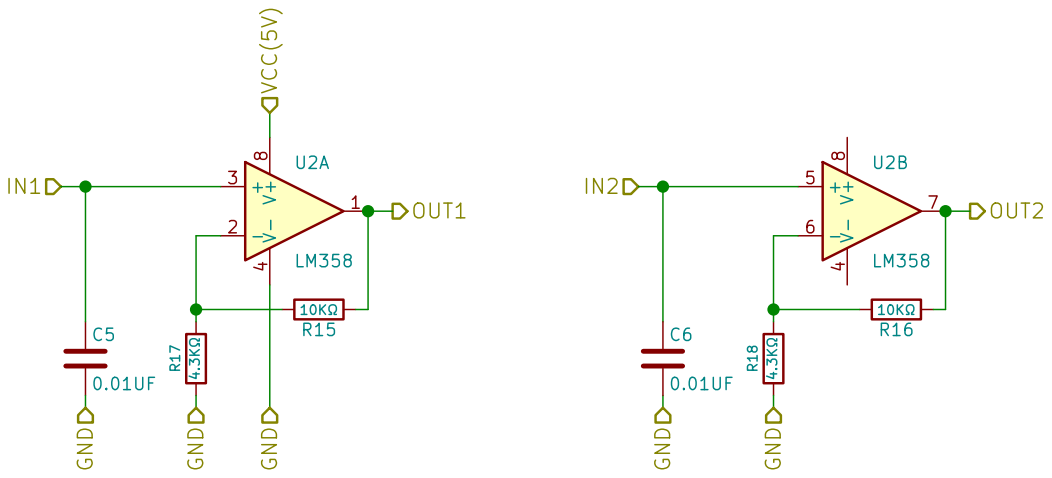
[picture p107: page 7]

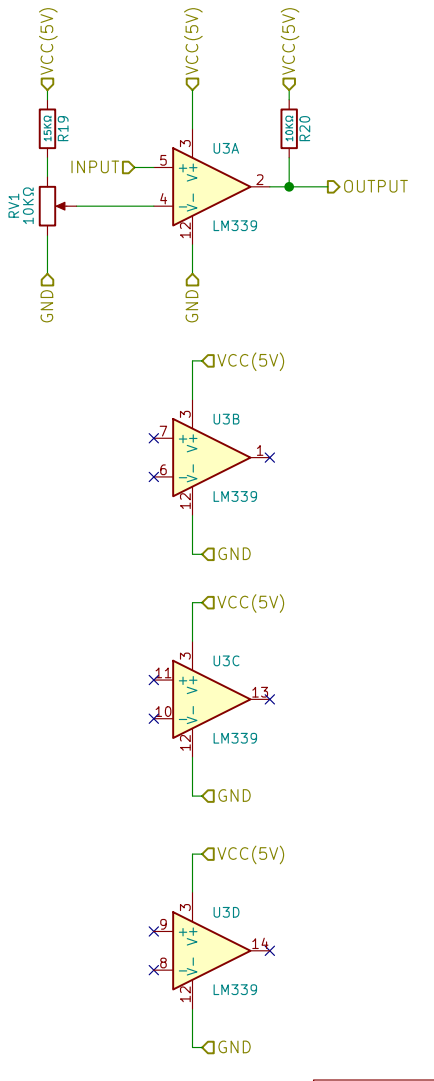
[picture p108: page 8]




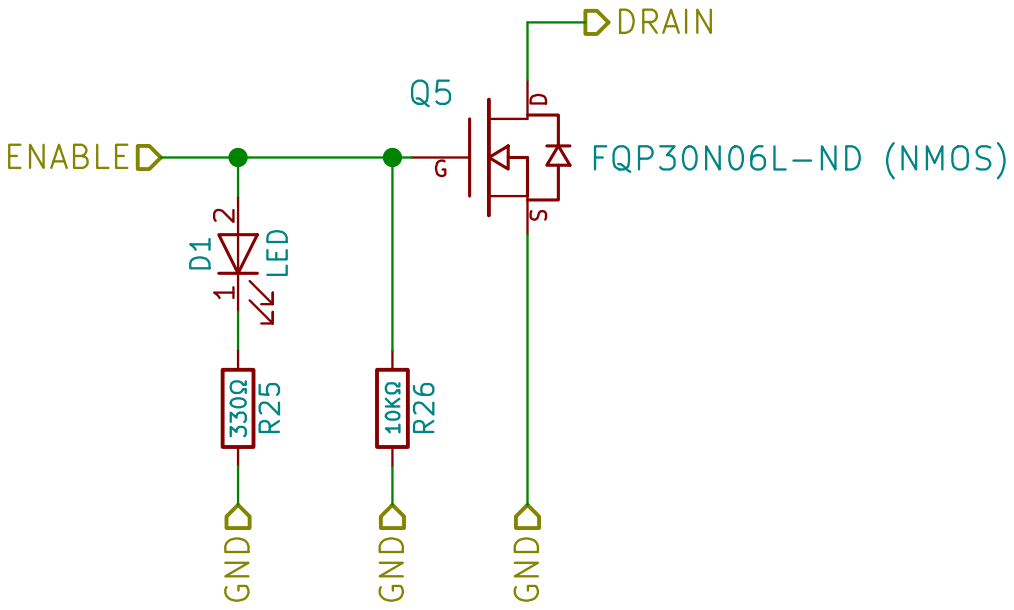
[picture p109: page 12]

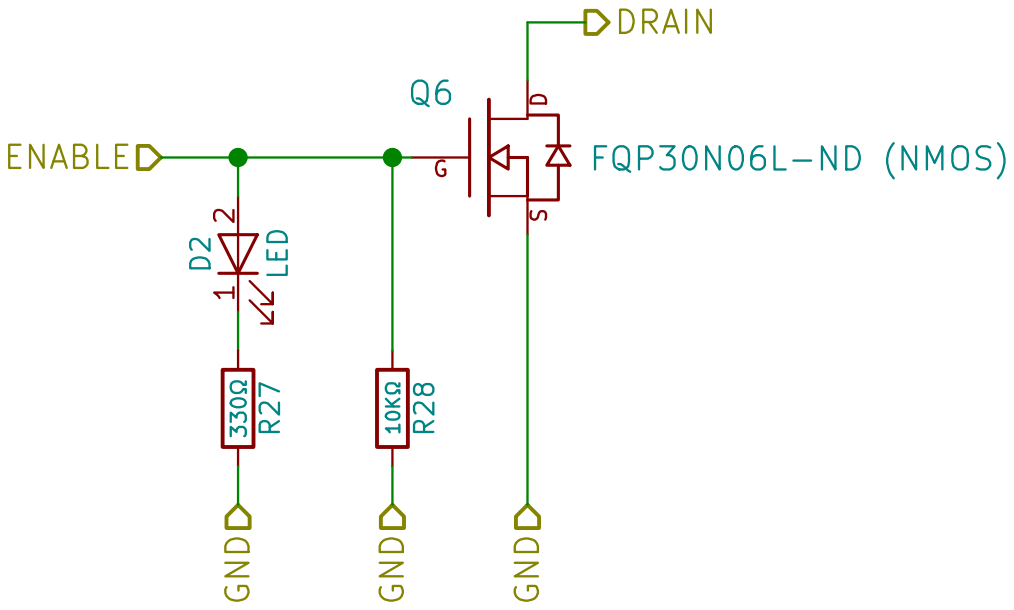
[picture p110: page 13]


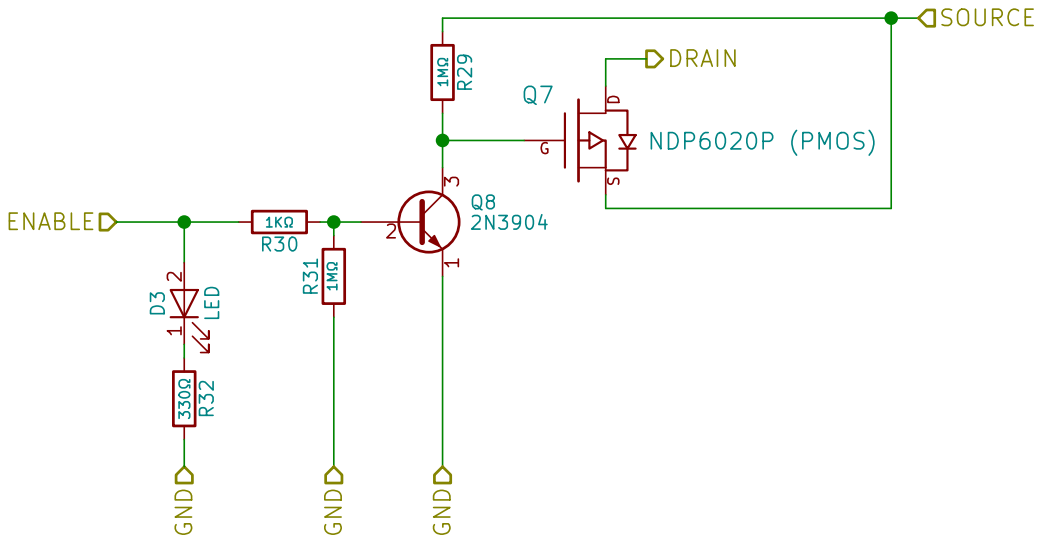
[picture p111: page 15]

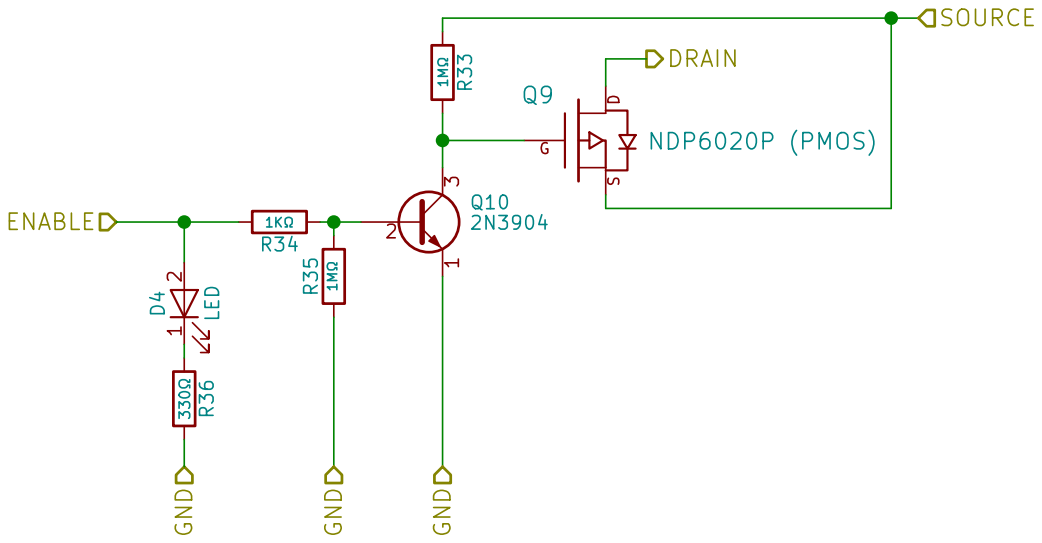
[picture p112: page 16]


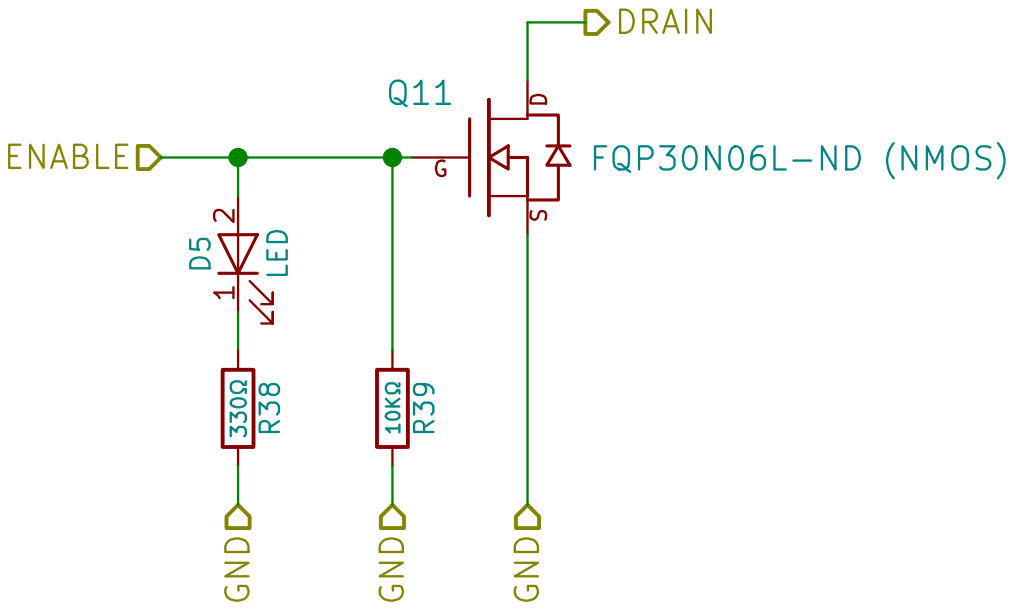
[picture p113: page 18]

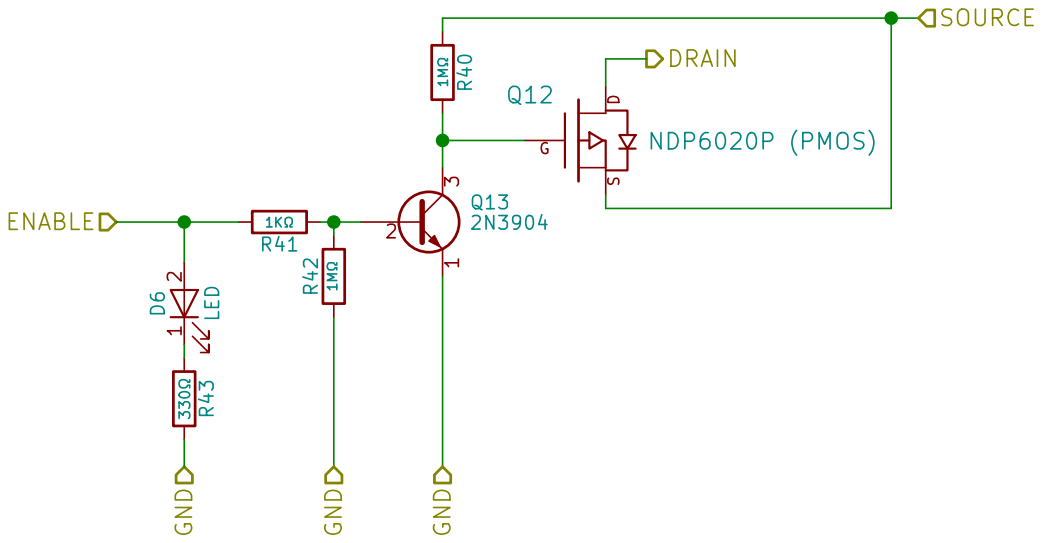
[picture p114: page 19]

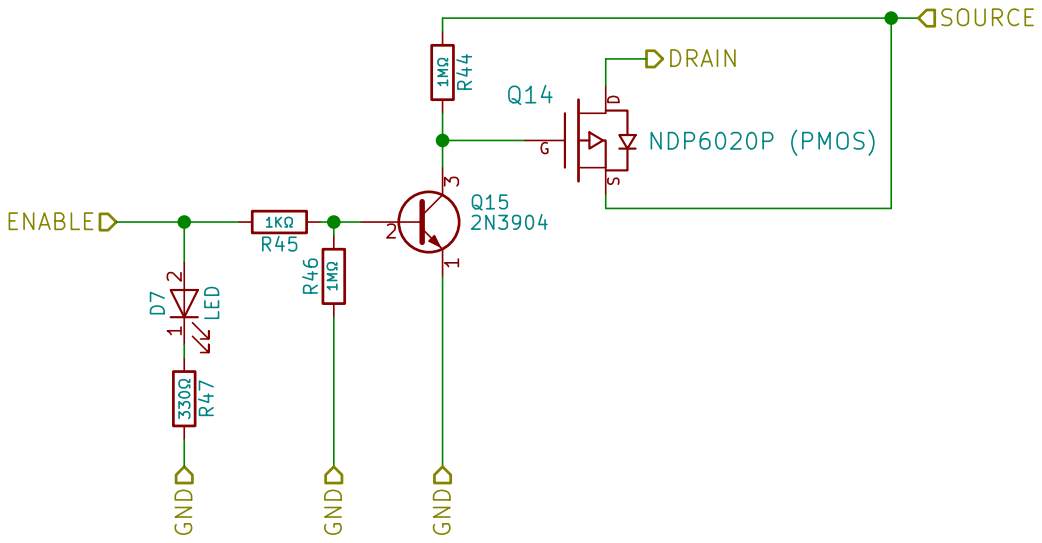
[picture p115: page 20]

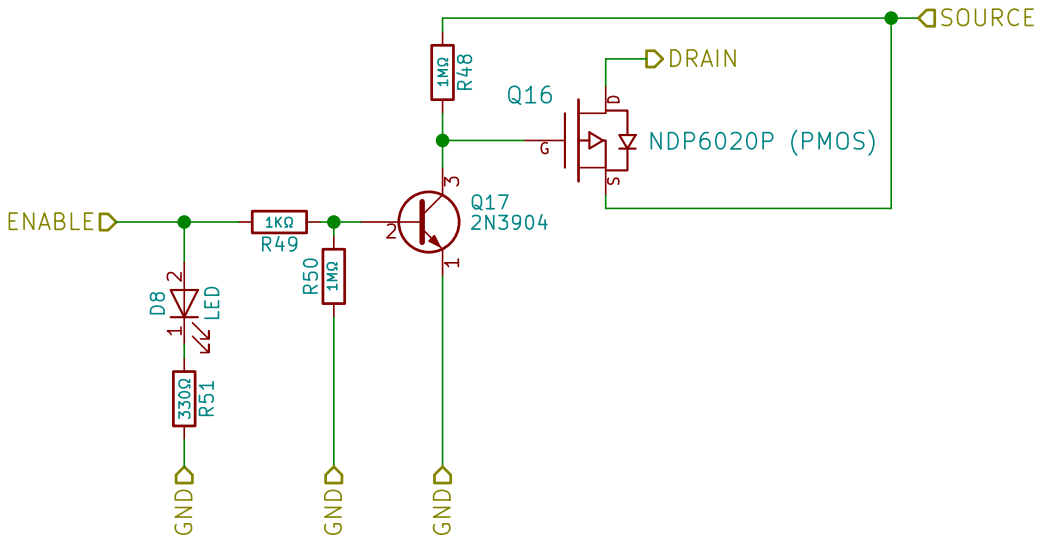
[picture p116: page 21]



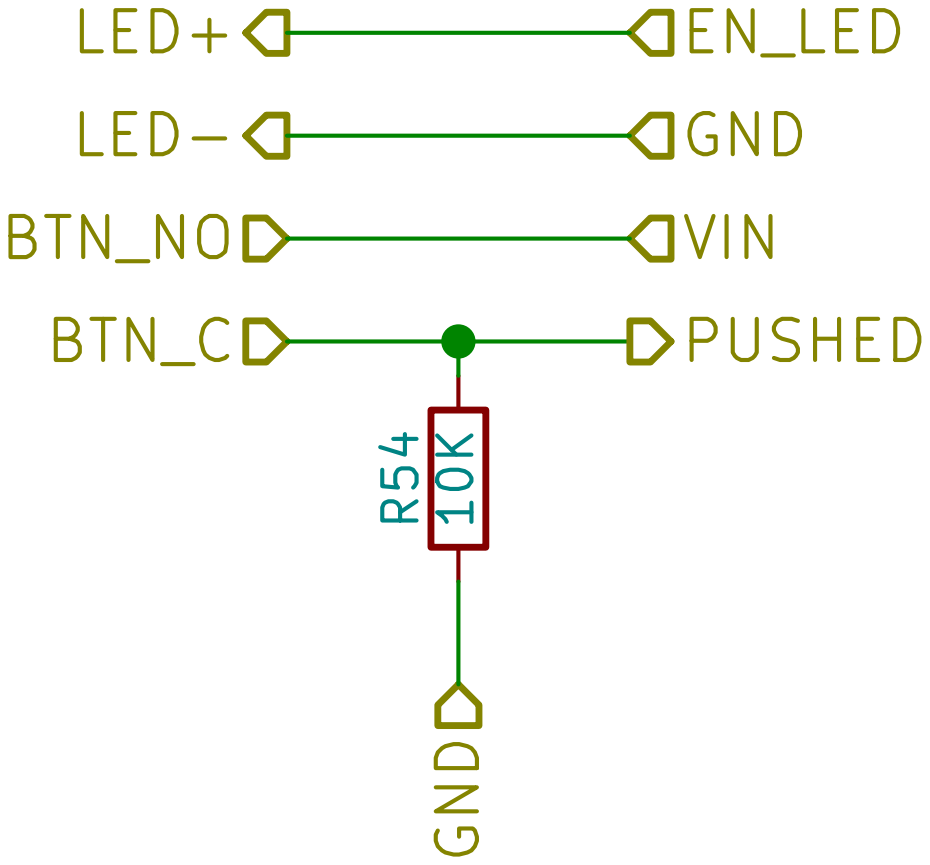
[picture p117: page 24]














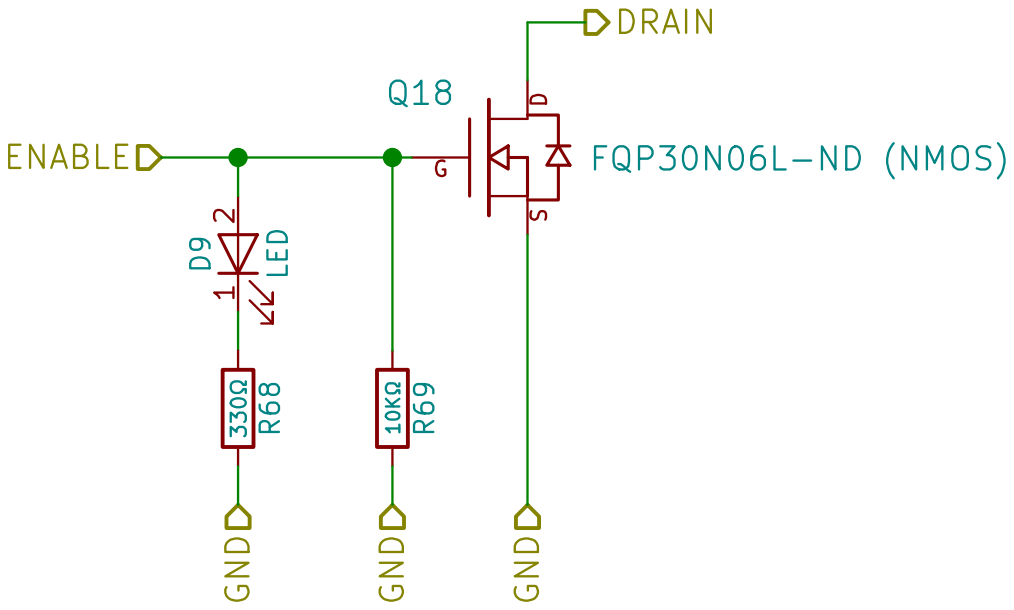
[picture p118: page 38]

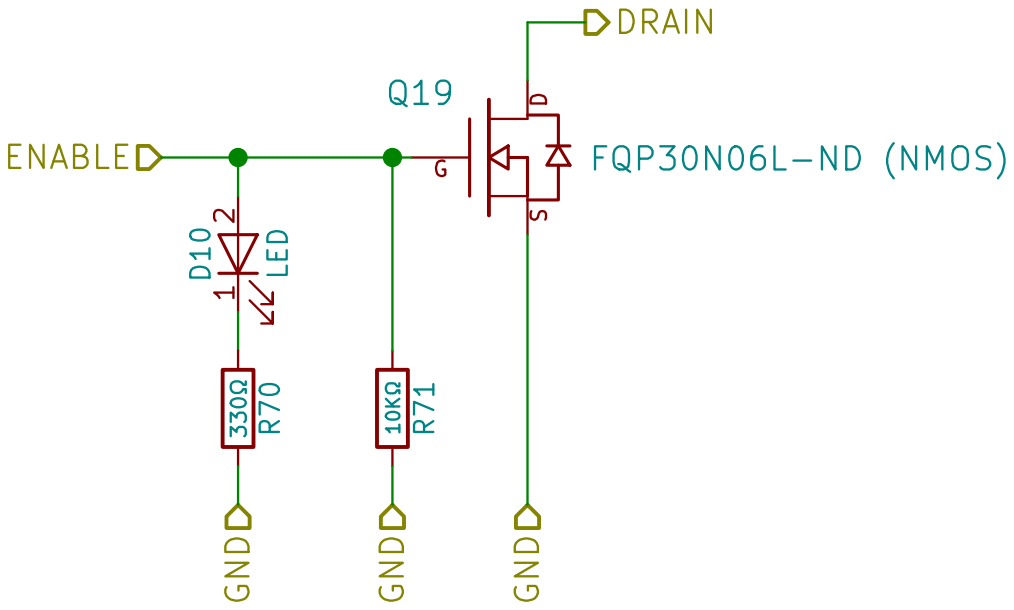
[picture p119: page 39]

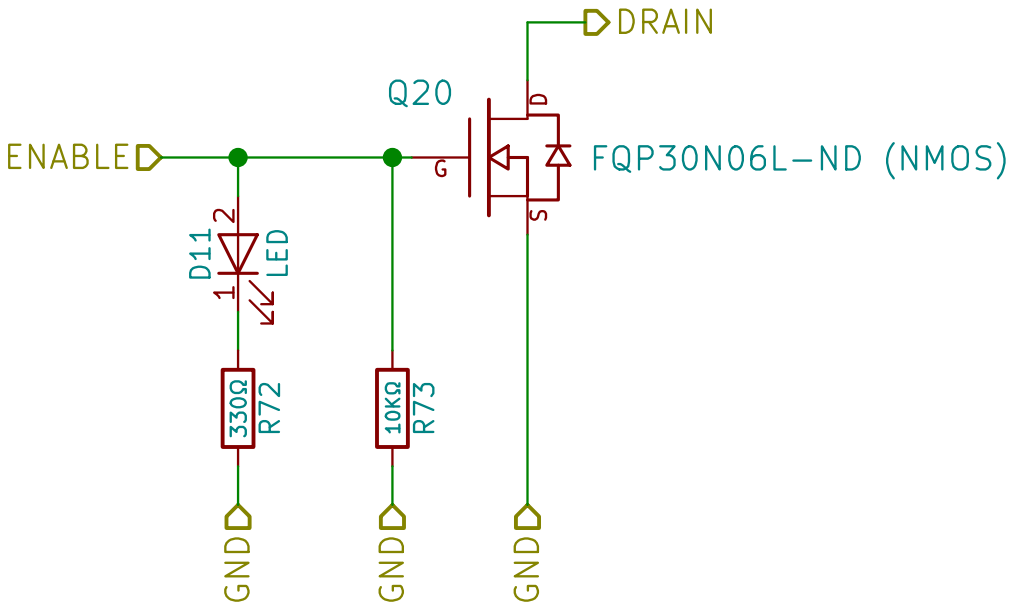
[picture p120: page 40]

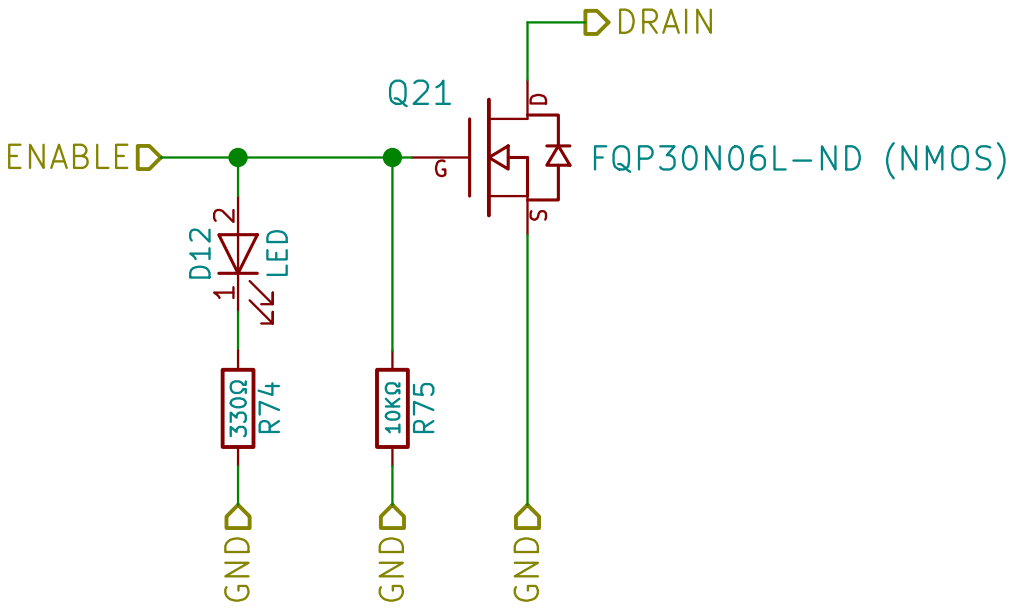
[picture p121: page 41]

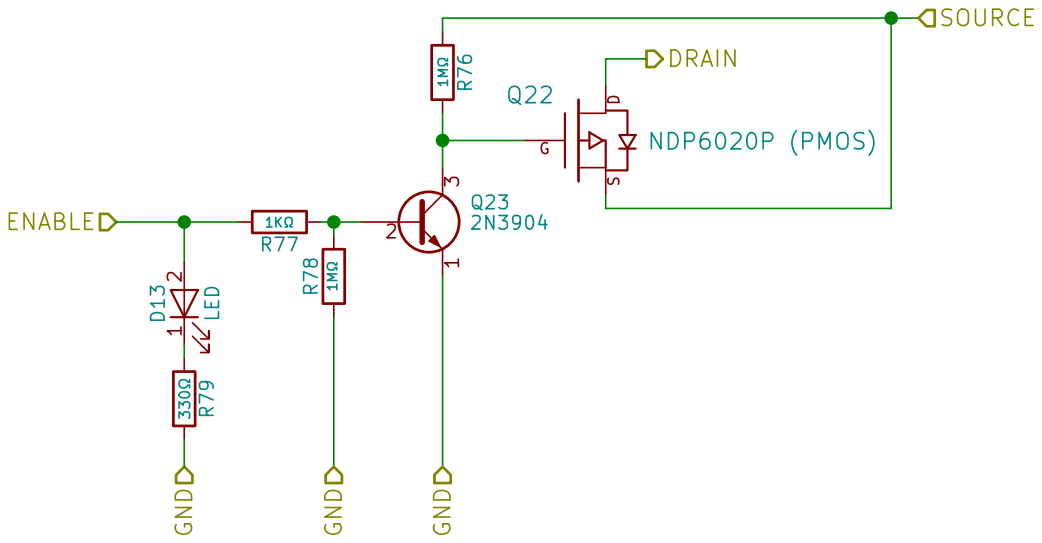
[picture p122: page 42]

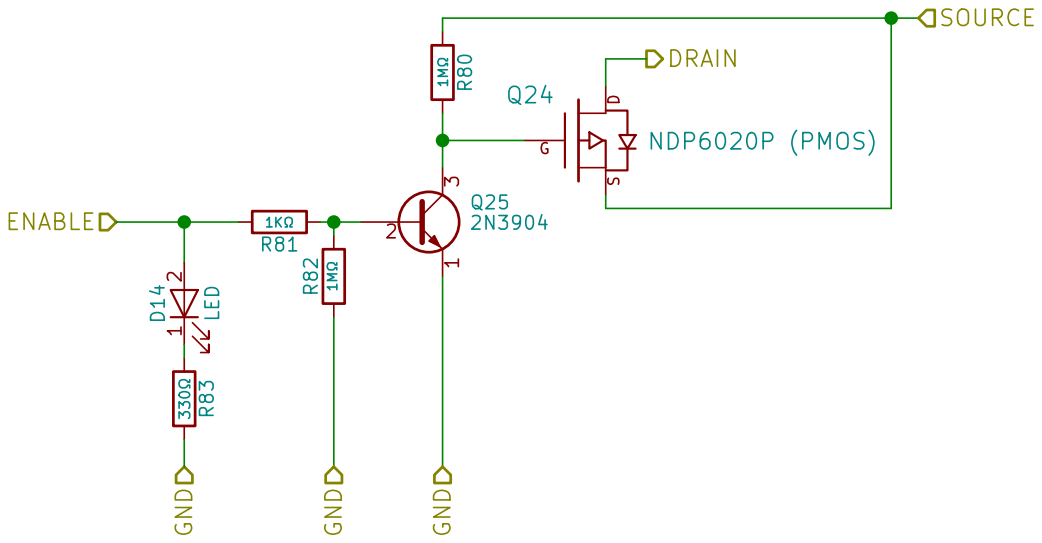
[picture p123: page 43]

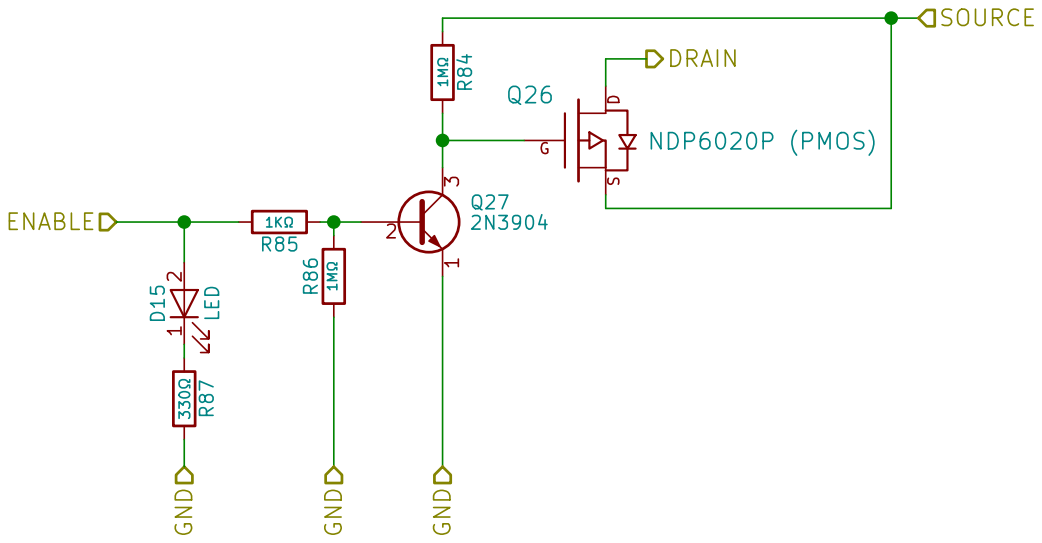
[picture p124: page 44]



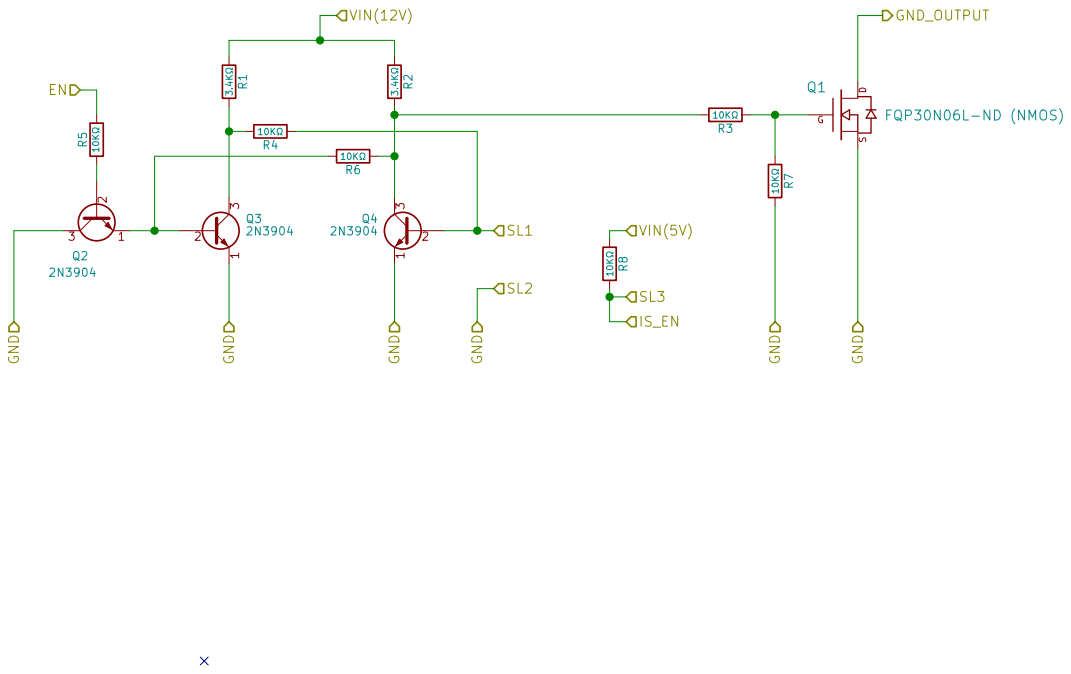
[picture p125: page 47]
