ferdymercury/Controller-Electrical-Schematics/(list of files, drawings)

Other design files:
kicad/hitchco-mk4-6.dsn
kicad/hitchco-mk4.dsn
revision-1-do-not-use/mk4-v1-blank-board/kicad/hitchco-mk4.dsn
revision-1-do-not-use/mk4-v1-board-with-fixes/kicad/hitchco-mk4.dsn
