ferdymercury/Controller-Electrical-Schematics/kicad/hitchco-mk4.kicad_pcb

## KiCad design kicad/hitchco-mk4.kicad_pcb (2018-07-02)

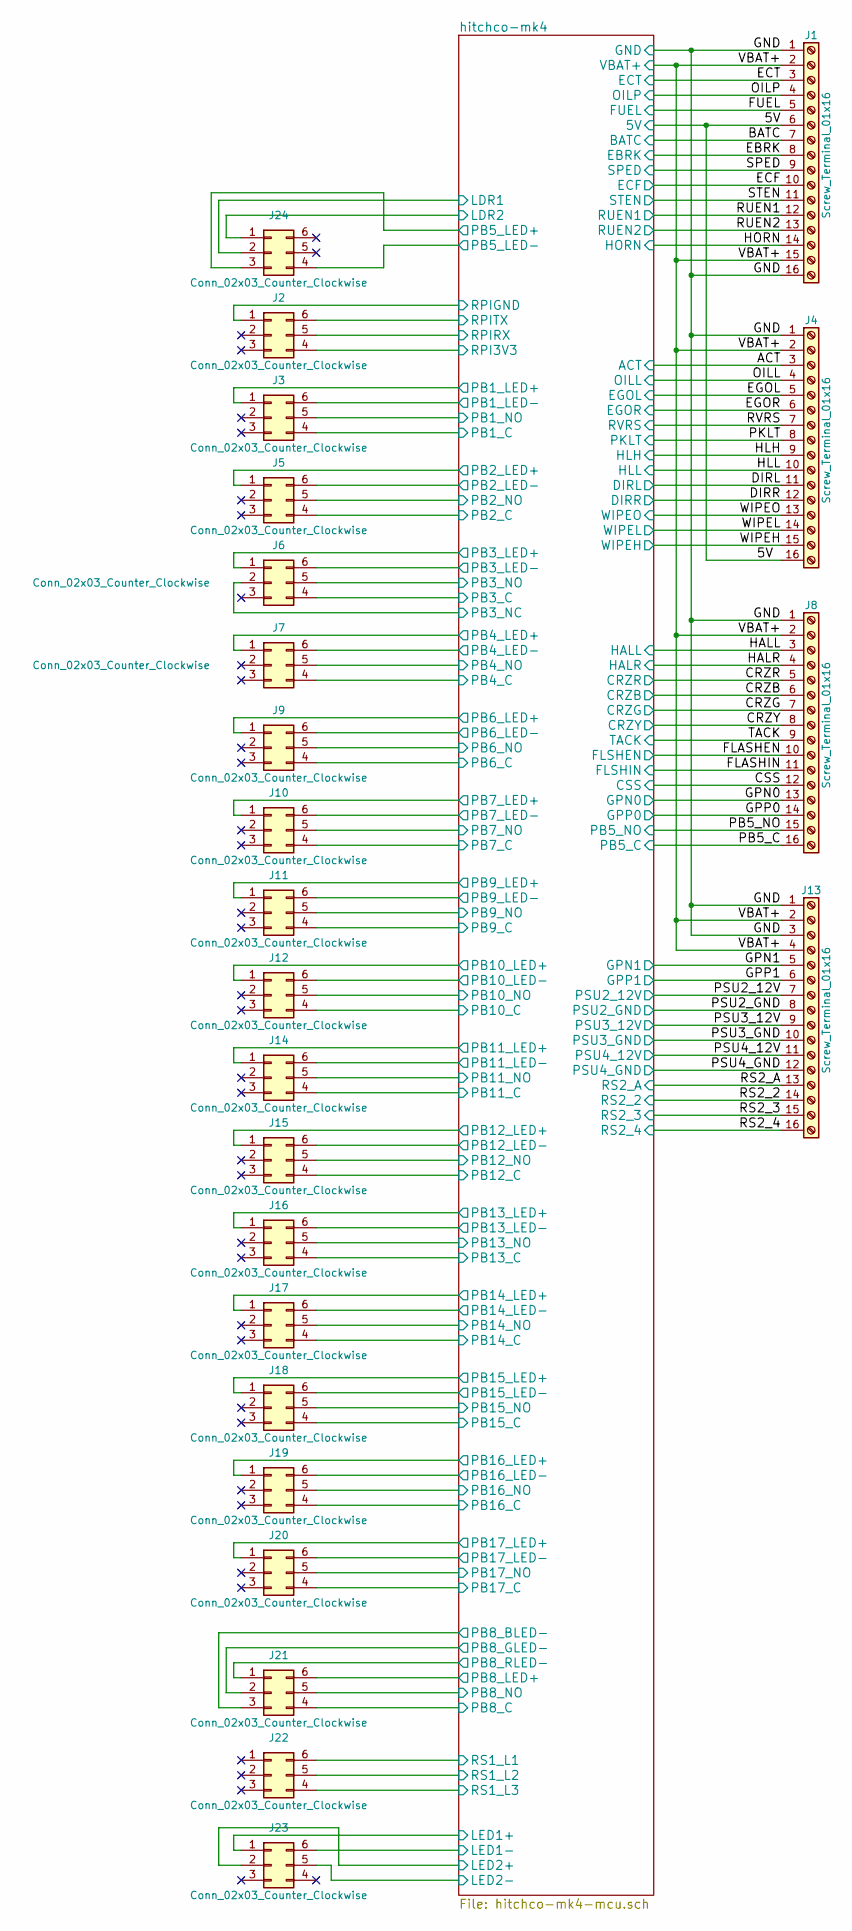
[picture p126: schematic hitchco-mk4.sch, Hitchco MK4]

Parts:
J1, J4, J8, J13: Screw_Terminal_01x16; TerminalBlock_Phoenix_45Deg_MKDS1.5-16pol; digikey-pn 277-13705-ND
J2, J3, J5, J6, J7, J9, J10, J11, J12, J14, J15, J16, J17, J18, J19, J20, J21, J22, J23, J24: Conn_02x03_Counter_Clockwise; Shroud_Socket_Strip_Straight_2x03_Pitch2.54mm; digikey-pn 609-2845-ND

Connections:
/5V: J1.6, J3.5, J4.16, J5.5, J7.5, J9.5, J10.5, J11.5, J12.5, J14.5, J15.5, J16.5, J17.5, J18.5, J19.5, J20.5, J21.5, J21.6, J24.2, J24.3; also elsewhere on the board
/BATC: J1.7; also elsewhere on the board
/CRZB: J8.6; also elsewhere on the board
/CRZG: J8.7; also elsewhere on the board
/CRZR: J8.5; also elsewhere on the board
/CRZY: J8.8; also elsewhere on the board
/CSS: J8.12; also elsewhere on the board
/DIRL: J4.11; also elsewhere on the board
/DIRR: J4.12; also elsewhere on the board
/EBRK: J1.8; also elsewhere on the board
/ECF: J1.10; also elsewhere on the board
/EGOL: J4.5; also elsewhere on the board
/EGOR: J4.6; also elsewhere on the board
/FLASHEN: J8.10; also elsewhere on the board
/FLASHIN: J6.1, J8.11; also elsewhere on the board
/GND: J1.1, J1.16, J2.1, J3.6, J4.1, J5.6, J6.6, J7.6, J8.1, J8.16, J9.6, J10.6, J11.6, J12.6, J13.1, J13.3, J13.8, J13.10, J13.12, J13.13, J14.6, J15.6, J16.6, J17.6, J18.6, J19.6, J20.6, J22.5; also elsewhere on the board
/GPN0: J8.13; also elsewhere on the board
/GPN1: J13.5; also elsewhere on the board
/GPP0: J8.14; also elsewhere on the board
/GPP1: J13.6; also elsewhere on the board
/HALL: J8.3; also elsewhere on the board
/HALR: J8.4; also elsewhere on the board
/HLH: J4.9, J13.16; also elsewhere on the board
/HLL: J4.10, J13.15; also elsewhere on the board
/HORN: J1.14, J8.15; also elsewhere on the board
/PKLT: J4.8, J13.14; also elsewhere on the board
/PSU2_12V: J13.7; also elsewhere on the board
/PSU3_12V: J13.9; also elsewhere on the board
/PSU4_12V: J13.11; also elsewhere on the board
/RUEN1: J1.12; also elsewhere on the board
/RUEN2: J1.13; also elsewhere on the board
/RVRS: J4.7; also elsewhere on the board
/SPED: J1.9; also elsewhere on the board
/STEN: J1.11; also elsewhere on the board
/TACK: J8.9; also elsewhere on the board
/VBAT+: J1.2, J1.15, J4.2, J6.4, J8.2, J13.2, J13.4, J23.1, J23.2; also elsewhere on the board
/WIPEH: J4.15; also elsewhere on the board
/WIPEL: J4.14; also elsewhere on the board
/WIPEO: J4.13; also elsewhere on the board
/hitchco-mk4/LED1-: J23.6; also elsewhere on the board
/hitchco-mk4/LED2-: J23.5; also elsewhere on the board
/hitchco-mk4/PB3_NC: J6.2; also elsewhere on the board
/hitchco-mk4/PB3_NO: J6.5; also elsewhere on the board
/hitchco-mk4/PB5_LED-: J24.4; also elsewhere on the board
/hitchco-mk4/RPI3V3: J2.4; also elsewhere on the board
/hitchco-mk4/RPIRX: J2.5; also elsewhere on the board
/hitchco-mk4/RPITX: J2.6; also elsewhere on the board
/hitchco-mk4/RS1_L1: J22.6; also elsewhere on the board
ACT_SIG_PIN: J4.3; also elsewhere on the board
ECT_SIG_PIN: J1.3; also elsewhere on the board
FUEL_SIG_PIN: J1.5; also elsewhere on the board
LDR_SIG_PIN: J24.1; also elsewhere on the board
OILL_SIG_PIN: J4.4; also elsewhere on the board
OILP_SIG_PIN: J1.4; also elsewhere on the board
PB1_LED_EN: J3.1; also elsewhere on the board
PB1_SIG_PIN: J3.4; also elsewhere on the board
PB2_LED_EN: J5.1; also elsewhere on the board
PB2_SIG_PIN: J5.4; also elsewhere on the board
PB4_LED_EN: J7.1; also elsewhere on the board
PB4_SIG_PIN: J7.4; also elsewhere on the board
PB6_LED_EN: J9.1; also elsewhere on the board
PB6_SIG_PIN: J9.4; also elsewhere on the board
PB7_LED_EN: J10.1; also elsewhere on the board
PB7_SIG_PIN: J10.4; also elsewhere on the board
PB8_BLED_EN: J21.3; also elsewhere on the board
PB8_GLED_EN: J21.2; also elsewhere on the board
PB8_RLED_EN: J21.1; also elsewhere on the board
PB8_SIG_PIN: J21.4; also elsewhere on the board
PB9_LED_EN: J11.1; also elsewhere on the board
PB9_SIG_PIN: J11.4; also elsewhere on the board
PB10_LED_EN: J12.1; also elsewhere on the board
PB10_SIG_PIN: J12.4; also elsewhere on the board
PB11_LED_EN: J14.1; also elsewhere on the board
PB11_SIG_PIN: J14.4; also elsewhere on the board
PB12_LED_EN: J15.1; also elsewhere on the board
PB12_SIG_PIN: J15.4; also elsewhere on the board
PB13_LED_EN: J16.1; also elsewhere on the board
PB13_SIG_PIN: J16.4; also elsewhere on the board
PB14_LED_EN: J17.1; also elsewhere on the board
PB14_SIG_PIN: J17.4; also elsewhere on the board
PB15_LED_EN: J18.1; also elsewhere on the board
PB15_SIG_PIN: J18.4; also elsewhere on the board
PB16_LED_EN: J19.1; also elsewhere on the board
PB16_SIG_PIN: J19.4; also elsewhere on the board
PB17_LED_EN: J20.1; also elsewhere on the board
PB17_SIG_PIN: J20.4; also elsewhere on the board
PSU1_SIG_PIN: J22.4; also elsewhere on the board

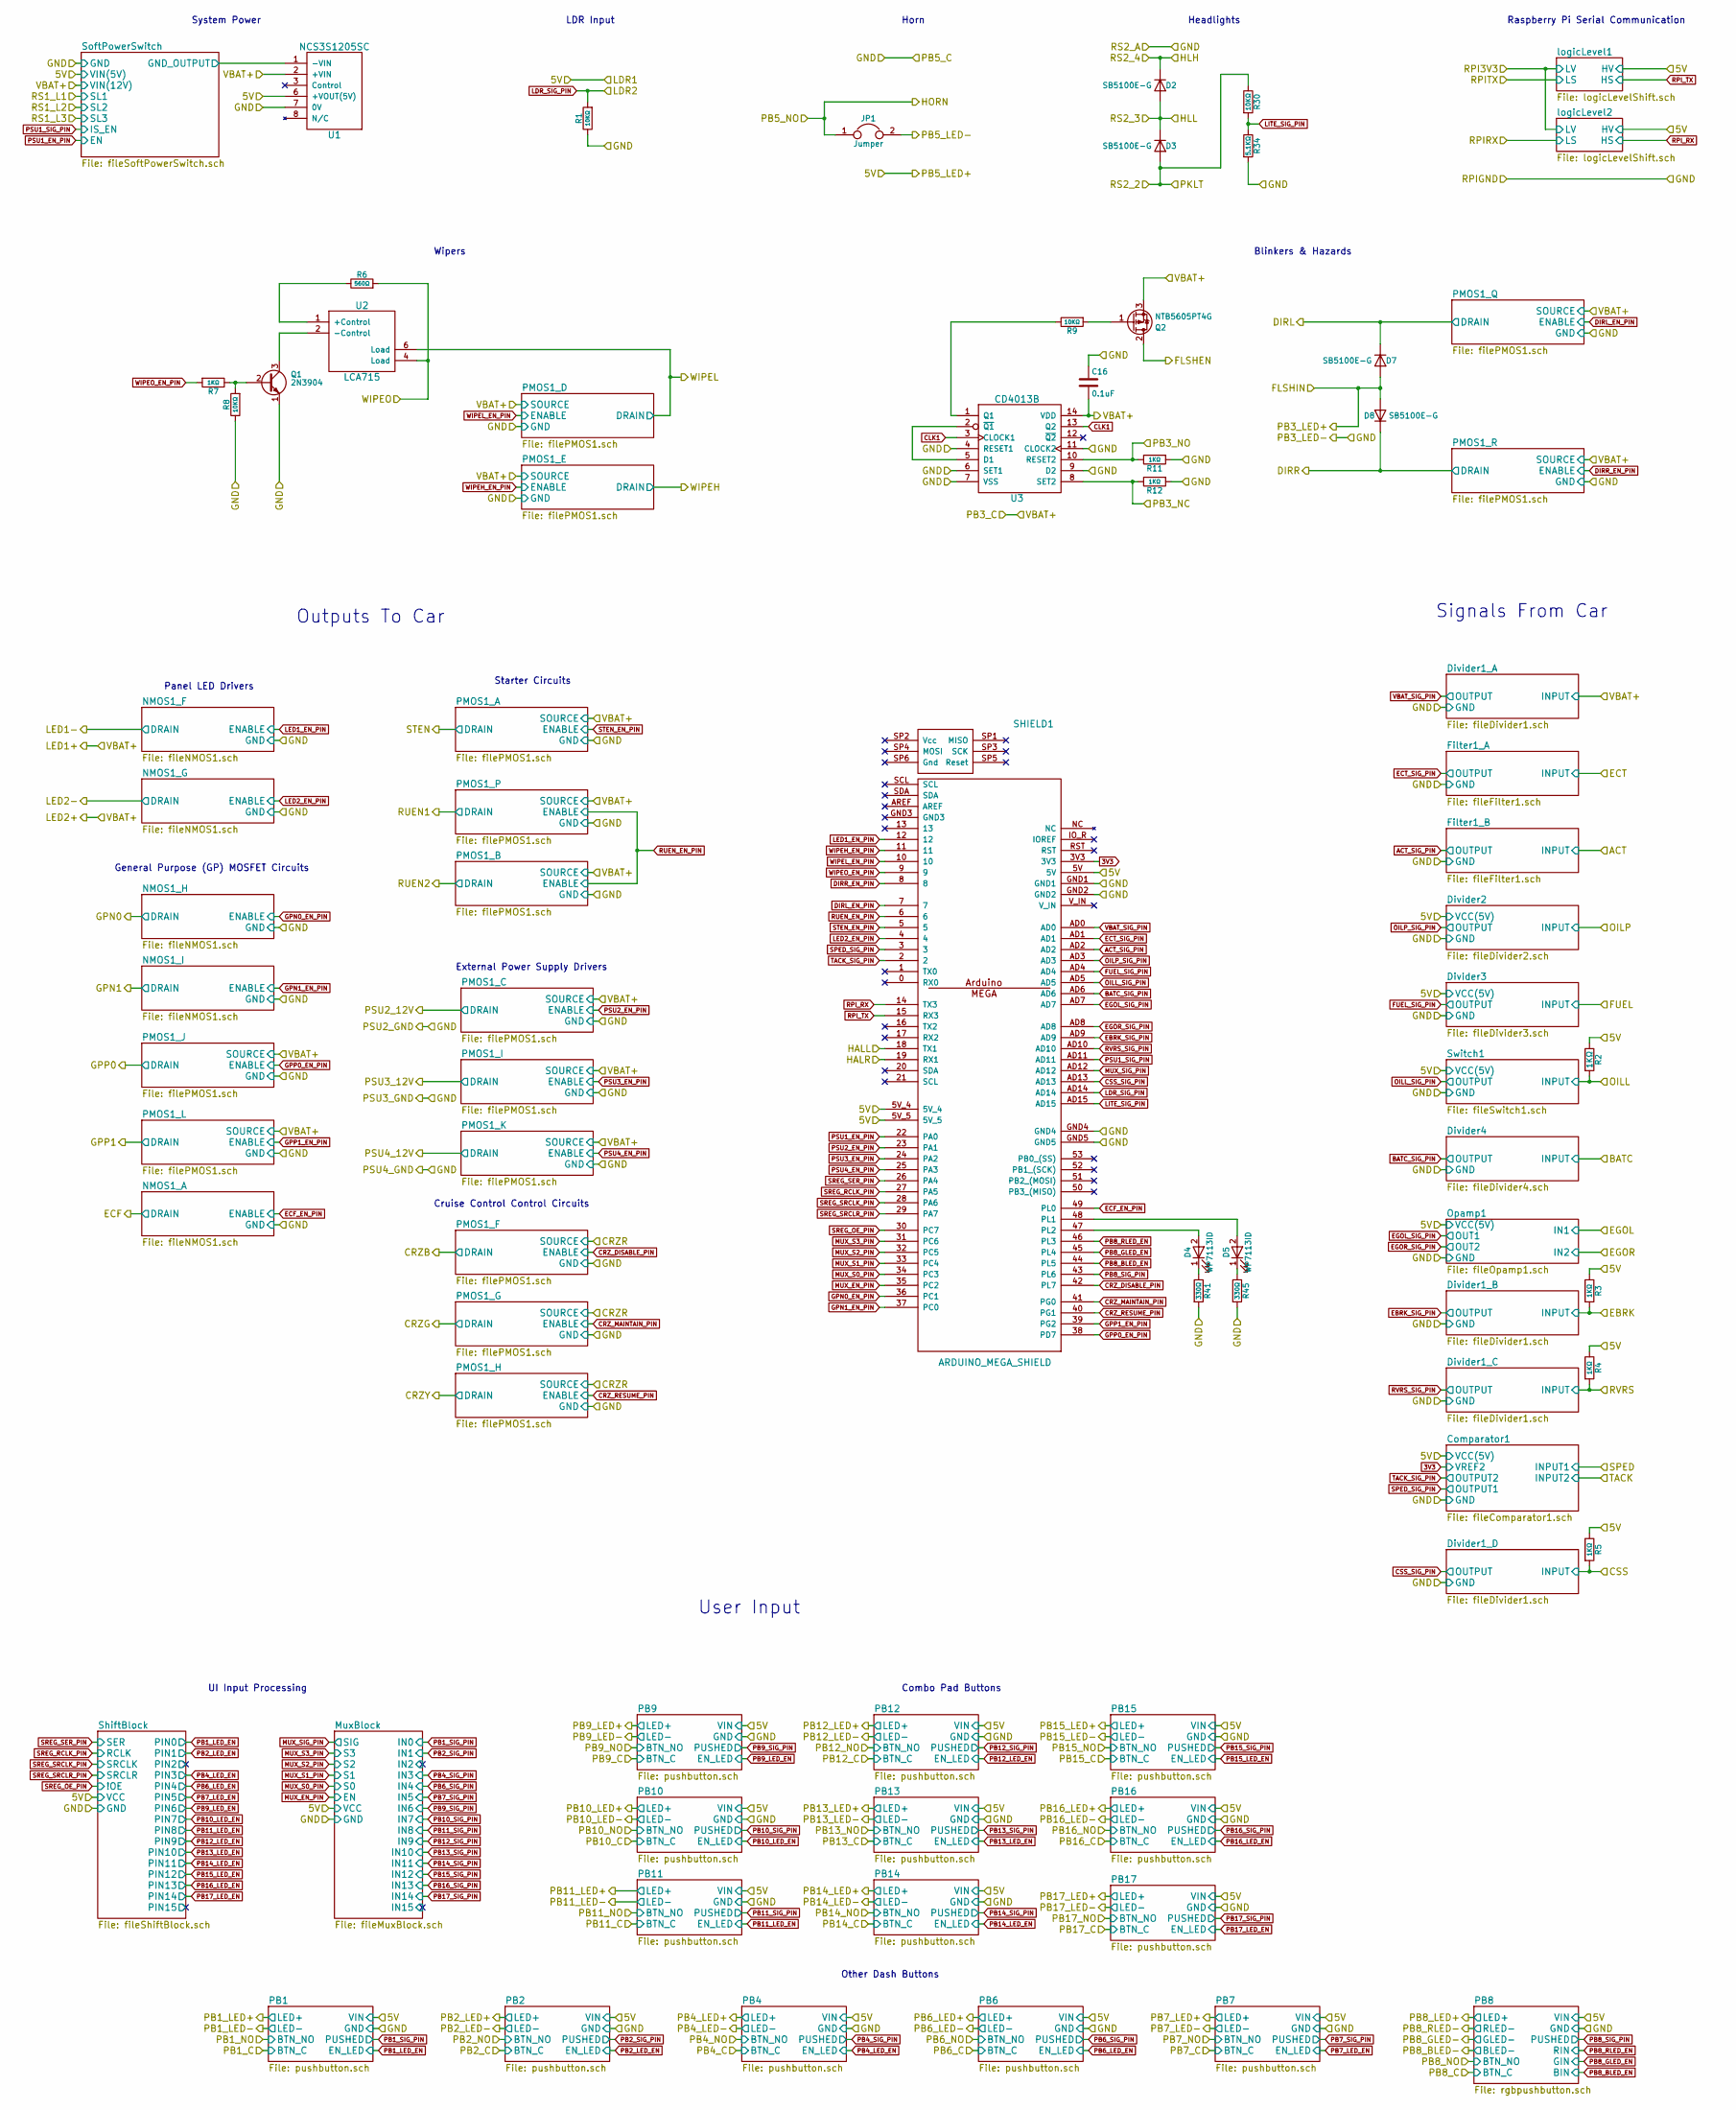
[picture p127: schematic hitchco-mk4-mcu.sch, Hitchco MK4]

Parts:
C16: 0.1uF; C_Rect_L5.08mm_W3.175mm_P2.54mm; digikey-pn 478-5096-ND
D2, D3, D7, D8: SB5100E-G; D_DO-201AD_P15.24mm_Horizontal; digikey-pn 641-1421-1-ND
D4, D5: WP7113ID; LED_D5.0mm; digikey-pn 754-1264-ND
JP1: Jumper; D_DO-201AD_P15.24mm_Horizontal
Q1: 2N3904; TO-92_Inline_Narrow_Oval; digikey-pn 2N3904FS-ND
Q2: NTB5605PT4G; TO-263-3_TabPin2; digikey-pn NTB5605PT4GOSCT-ND
R1, R8, R9, R30: 10KΩ; R_Axial_DIN0204_L3.6mm_D1.6mm_P5.08mm_Horizontal; digikey-pn BC10.0KXCT-ND
R2, R3, R4, R5, R7, R11, R12: 1KΩ; R_Axial_DIN0204_L3.6mm_D1.6mm_P5.08mm_Horizontal; digikey-pn BC1.00KXCT-ND
R6: 560Ω; R_Axial_DIN0204_L3.6mm_D1.6mm_P5.08mm_Horizontal; digikey-pn BC3282CT-ND
R34: 5.1KΩ; R_Axial_DIN0204_L3.6mm_D1.6mm_P5.08mm_Horizontal; digikey-pn BC3294CT-ND
R41, R45: 330Ω; R_Axial_DIN0204_L3.6mm_D1.6mm_P5.08mm_Horizontal; digikey-pn BC3292CT-ND
SHIELD1: ARDUINO_MEGA_SHIELD
U1: NCS3S1205SC; digikey-pn 811-3084-ND
U2: LCA715; DIP-6_W7.62mm_Socket; digikey-pn CLA308-ND
U3: CD4013B; DIP-14_W7.62mm_Socket; digikey-pn 296-2033-5-ND

Connections:
3V3: SHIELD1.3V3; also elsewhere on the board
/5V: R2.1, R3.1, R4.1, R5.1, SHIELD1.5V, SHIELD1.5V_4, SHIELD1.5V_5, U1.6 (+VOUT(5V)); also elsewhere on the board
/CSS: R5.2; also elsewhere on the board
/DIRL: D7.1 (K); also elsewhere on the board
/DIRR: D8.1 (K); also elsewhere on the board
/EBRK: R3.2; also elsewhere on the board
/FLASHEN: Q2.2 (D); also elsewhere on the board
/FLASHIN: D7.2 (A), D8.2 (A); also elsewhere on the board
/GND: C16.1, Q1.1 (E), R1.1, R8.1, R11.2, R12.2, R34.2, R41.2, R45.2, SHIELD1.GND1, SHIELD1.GND2, SHIELD1.GND4, SHIELD1.GND5, U1.7 (0V), U3.4 (RESET1), U3.6 (SET1), U3.7 (VSS), U3.9 (D2), U3.11 (CLOCK2); also elsewhere on the board
/HALL: SHIELD1.18 (TX1); also elsewhere on the board
/HALR: SHIELD1.19 (RX1); also elsewhere on the board
/HLH: D2.1 (K); also elsewhere on the board
/HLL: D2.2 (A), D3.1 (K); also elsewhere on the board
/HORN: JP1.1; also elsewhere on the board
/PKLT: D3.2 (A), R30.1; also elsewhere on the board
/RVRS: R4.2; also elsewhere on the board
/VBAT+: C16.2, Q2.3 (S), U1.2 (+VIN), U3.14 (VDD); also elsewhere on the board
/WIPEL: U2.6 (Load); also elsewhere on the board
/WIPEO: R6.2, U2.4 (Load); also elsewhere on the board
/hitchco-mk4/PB3_NC: R12.1, U3.8 (SET2); also elsewhere on the board
/hitchco-mk4/PB3_NO: R11.1, U3.10 (RESET2); also elsewhere on the board
/hitchco-mk4/PB5_LED-: JP1.2; also elsewhere on the board
/hitchco-mk4/SoftPowerSwitch/GND_OUTPUT: U1.1 (-VIN); also elsewhere on the board
ACT_SIG_PIN: SHIELD1.AD2; also elsewhere on the board
BATC_SIG_PIN: SHIELD1.AD6; also elsewhere on the board
CLK1: U3.3 (CLOCK1), U3.13 (Q2)
CRZ_DISABLE_PIN: SHIELD1.42 (PL7); also elsewhere on the board
CRZ_MAINTAIN_PIN: SHIELD1.41 (PG0); also elsewhere on the board
CRZ_RESUME_PIN: SHIELD1.40 (PG1); also elsewhere on the board
CSS_SIG_PIN: SHIELD1.AD13; also elsewhere on the board
DIRL_EN_PIN: SHIELD1.7; also elsewhere on the board
DIRR_EN_PIN: SHIELD1.8; also elsewhere on the board
EBRK_SIG_PIN: SHIELD1.AD9; also elsewhere on the board
ECF_EN_PIN: SHIELD1.49 (PL0); also elsewhere on the board
ECT_SIG_PIN: SHIELD1.AD1; also elsewhere on the board
EGOL_SIG_PIN: SHIELD1.AD7; also elsewhere on the board
EGOR_SIG_PIN: SHIELD1.AD8; also elsewhere on the board
FUEL_SIG_PIN: SHIELD1.AD4; also elsewhere on the board
GPN0_EN_PIN: SHIELD1.36 (PC1); also elsewhere on the board
GPN1_EN_PIN: SHIELD1.37 (PC0); also elsewhere on the board
GPP0_EN_PIN: SHIELD1.38 (PD7); also elsewhere on the board
GPP1_EN_PIN: SHIELD1.39 (PG2); also elsewhere on the board
LDR_SIG_PIN: R1.2, SHIELD1.AD14; also elsewhere on the board
LED1_EN_PIN: SHIELD1.12; also elsewhere on the board
LED2_EN_PIN: SHIELD1.4; also elsewhere on the board
LITE_SIG_PIN: R30.2, R34.1, SHIELD1.AD15
MUX_EN_PIN: SHIELD1.35 (PC2); also elsewhere on the board
MUX_S0_PIN: SHIELD1.34 (PC3); also elsewhere on the board
MUX_S1_PIN: SHIELD1.33 (PC4); also elsewhere on the board
MUX_S2_PIN: SHIELD1.32 (PC5); also elsewhere on the board
MUX_S3_PIN: SHIELD1.31 (PC6); also elsewhere on the board
MUX_SIG_PIN: SHIELD1.AD12; also elsewhere on the board
unnamed: D4.1 (K), R41.1
unnamed: D4.2 (A), SHIELD1.47 (PL2)
unnamed: D5.1 (K), R45.1
unnamed: D5.2 (A), SHIELD1.48 (PL1)
unnamed: Q1.2 (B), R7.1, R8.2
unnamed: Q1.3 (C), U2.2 (-Control)
unnamed: Q2.1 (G), R9.2
unnamed: R6.1, U2.1 (+Control)
unnamed: R9.1, U3.1 (Q1)
unnamed: U3.2 (~Q1), U3.5 (D1)
OILL_SIG_PIN: R2.2, SHIELD1.AD5; also elsewhere on the board
OILP_SIG_PIN: SHIELD1.AD3; also elsewhere on the board
PB8_BLED_EN: SHIELD1.44 (PL5); also elsewhere on the board
PB8_GLED_EN: SHIELD1.45 (PL4); also elsewhere on the board
PB8_RLED_EN: SHIELD1.46 (PL3); also elsewhere on the board
PB8_SIG_PIN: SHIELD1.43 (PL6); also elsewhere on the board
PSU1_EN_PIN: SHIELD1.22 (PA0); also elsewhere on the board
PSU1_SIG_PIN: SHIELD1.AD11; also elsewhere on the board
PSU2_EN_PIN: SHIELD1.23 (PA1); also elsewhere on the board
PSU3_EN_PIN: SHIELD1.24 (PA2); also elsewhere on the board
PSU4_EN_PIN: SHIELD1.25 (PA3); also elsewhere on the board
RPI_RX: SHIELD1.14 (TX3); also elsewhere on the board
RPI_TX: SHIELD1.15 (RX3); also elsewhere on the board
RUEN_EN_PIN: SHIELD1.6; also elsewhere on the board
RVRS_SIG_PIN: SHIELD1.AD10; also elsewhere on the board
SPED_SIG_PIN: SHIELD1.3; also elsewhere on the board
SREG_OE_PIN: SHIELD1.30 (PC7); also elsewhere on the board
SREG_RCLK_PIN: SHIELD1.27 (PA5); also elsewhere on the board
SREG_SER_PIN: SHIELD1.26 (PA4); also elsewhere on the board
SREG_SRCLK_PIN: SHIELD1.28 (PA6); also elsewhere on the board
SREG_SRCLR_PIN: SHIELD1.29 (PA7); also elsewhere on the board
STEN_EN_PIN: SHIELD1.5; also elsewhere on the board
TACK_SIG_PIN: SHIELD1.2; also elsewhere on the board
VBAT_SIG_PIN: SHIELD1.AD0; also elsewhere on the board
WIPEH_EN_PIN: SHIELD1.11; also elsewhere on the board
WIPEL_EN_PIN: SHIELD1.10; also elsewhere on the board
WIPEO_EN_PIN: R7.2, SHIELD1.9

Notes on the sheet:
General Purpose (GP) MOSFET Circuits
Panel LED Drivers
External Power Supply Drivers
Cruise Control Control Circuits
Starter Circuits
System Power
LDR Input
Horn
Headlights
Raspberry Pi Serial Communication
Outputs To Car
Signals From Car
Wipers
Blinkers & Hazards
User Input
UI Input Processing
Combo Pad Buttons
Other Dash Buttons

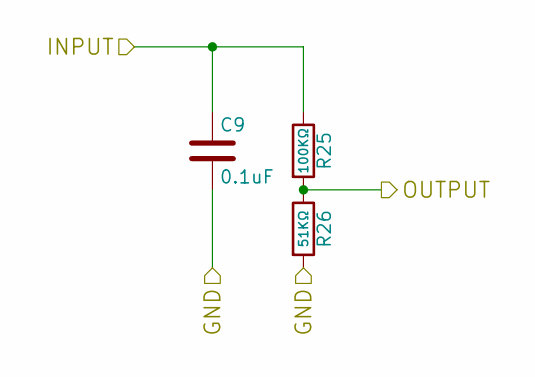
[picture p128: schematic fileDivider1.sch, Hitchco MK4]

Parts:
C1: 0.1uF; C_Rect_L5.08mm_W3.175mm_P2.54mm; digikey-pn 478-5096-ND
R13: 100KΩ; R_Axial_DIN0204_L3.6mm_D1.6mm_P5.08mm_Horizontal; digikey-pn BC100KXCT-ND
R14: 51KΩ; R_Axial_DIN0204_L3.6mm_D1.6mm_P5.08mm_Horizontal; digikey-pn BC3531CT-ND

Connections:
/GND: C1.2, R14.2; also elsewhere on the board
/VBAT+: C1.1, R13.1; also elsewhere on the board
VBAT_SIG_PIN: R13.2, R14.1; also elsewhere on the board

Parts of its further copies:
C8, C9, C15: 0.1uF; C_Rect_L5.08mm_W3.175mm_P2.54mm; digikey-pn 478-5096-ND
R23, R25, R118: 100KΩ; R_Axial_DIN0204_L3.6mm_D1.6mm_P5.08mm_Horizontal; digikey-pn BC100KXCT-ND
R24, R26, R119: 51KΩ; R_Axial_DIN0204_L3.6mm_D1.6mm_P5.08mm_Horizontal; digikey-pn BC3531CT-ND

Connections of its further copies:
/CSS: C15.1, R118.1; also elsewhere on the board
/EBRK: C8.1, R23.1; also elsewhere on the board
/GND: C8.2, C9.2, C15.2, R24.2, R26.2, R119.2; also elsewhere on the board
/RVRS: C9.1, R25.1; also elsewhere on the board
CSS_SIG_PIN: R118.2, R119.1; also elsewhere on the board
EBRK_SIG_PIN: R23.2, R24.1; also elsewhere on the board
RVRS_SIG_PIN: R25.2, R26.1; also elsewhere on the board

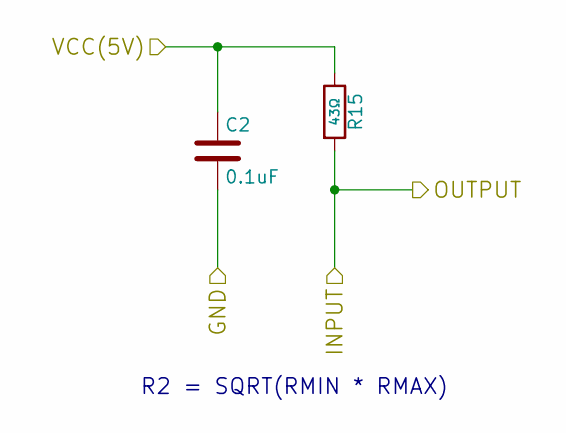
[picture p129: schematic fileDivider2.sch, Hitchco MK4]

Parts:
C2: 0.1uF; C_Rect_L5.08mm_W3.175mm_P2.54mm; digikey-pn 478-5096-ND
R15: 43Ω; R_Axial_DIN0204_L3.6mm_D1.6mm_P5.08mm_Horizontal; digikey-pn BC4443CT-ND

Connections:
/5V: C2.1, R15.1; also elsewhere on the board
/GND: C2.2; also elsewhere on the board
OILP_SIG_PIN: R15.2; also elsewhere on the board

Notes on the sheet:
R2 = SQRT(RMIN * RMAX)

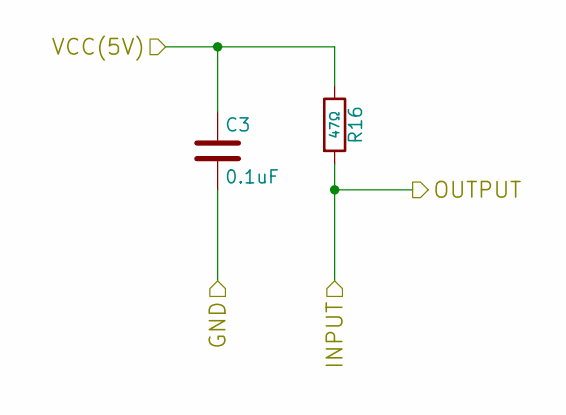
[picture p130: schematic fileDivider3.sch, Hitchco MK4]

Parts:
C3: 0.1uF; C_Rect_L5.08mm_W3.175mm_P2.54mm; digikey-pn 478-5096-ND
R16: 47Ω; R_Axial_DIN0204_L3.6mm_D1.6mm_P5.08mm_Horizontal; digikey-pn BC3277CT-ND

Connections:
/5V: C3.1, R16.1; also elsewhere on the board
/GND: C3.2; also elsewhere on the board
FUEL_SIG_PIN: R16.2; also elsewhere on the board

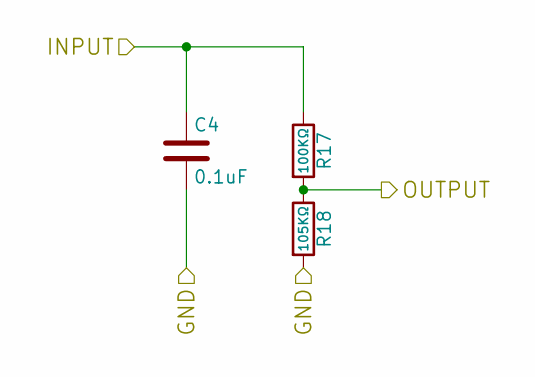
[picture p131: schematic fileDivider4.sch, Hitchco MK4]

Parts:
C4: 0.1uF; C_Rect_L5.08mm_W3.175mm_P2.54mm; digikey-pn 478-5096-ND
R17: 100KΩ; R_Axial_DIN0204_L3.6mm_D1.6mm_P5.08mm_Horizontal; digikey-pn BC100KXCT-ND
R18: 105KΩ; R_Axial_DIN0204_L3.6mm_D1.6mm_P5.08mm_Horizontal; digikey-pn 105KXBK-ND

Connections:
/BATC: C4.1, R17.1; also elsewhere on the board
/GND: C4.2, R18.2; also elsewhere on the board
BATC_SIG_PIN: R17.2, R18.1; also elsewhere on the board

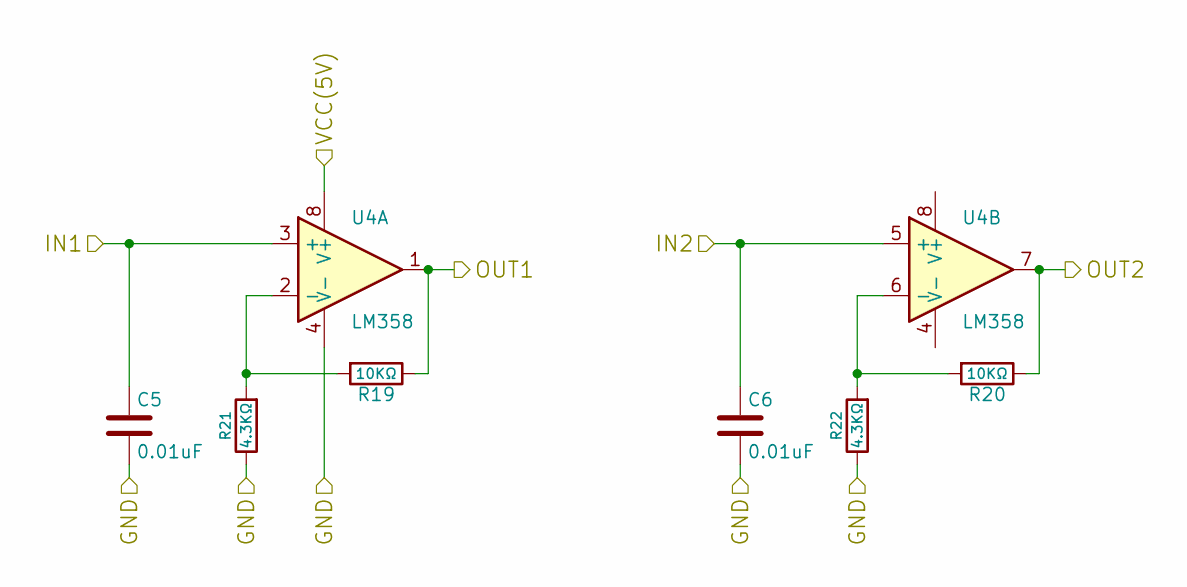
[picture p132: schematic fileOpamp1.sch, Hitchco MK4]

Parts:
C5, C6: 0.01uF; C_Rect_L5.08mm_W3.175mm_P2.54mm; digikey-pn 478-5095-ND
R19, R20: 10KΩ; R_Axial_DIN0204_L3.6mm_D1.6mm_P5.08mm_Horizontal; digikey-pn BC10.0KXCT-ND
R21, R22: 4.3KΩ; R_Axial_DIN0204_L3.6mm_D1.6mm_P5.08mm_Horizontal; digikey-pn BC3513CT-ND
U4: LM358; DIP-8_W7.62mm; digikey-pn 296-1395-5-ND

Connections:
/5V: U4.8 (V+); also elsewhere on the board
/EGOL: C5.1, U4.3 (+); also elsewhere on the board
/EGOR: C6.1, U4.5 (+); also elsewhere on the board
/GND: C5.2, C6.2, R21.1, R22.1, U4.4 (V-); also elsewhere on the board
EGOL_SIG_PIN: R19.1, U4.1; also elsewhere on the board
EGOR_SIG_PIN: R20.1, U4.7; also elsewhere on the board
unnamed: R19.2, R21.2, U4.2 (-)
unnamed: R20.2, R22.2, U4.6 (-)

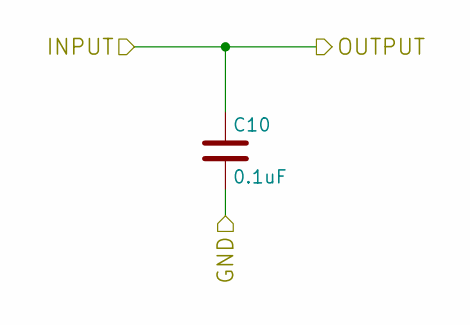
[picture p133: schematic fileFilter1.sch, Hitchco MK4]

Parts:
C7: 0.1uF; C_Rect_L5.08mm_W3.175mm_P2.54mm; digikey-pn 478-5096-ND

Connections:
/GND: C7.2; also elsewhere on the board
ACT_SIG_PIN: C7.1; also elsewhere on the board

Parts of its further copies:
C10: 0.1uF; C_Rect_L5.08mm_W3.175mm_P2.54mm; digikey-pn 478-5096-ND

Connections of its further copies:
/GND: C10.2; also elsewhere on the board
ECT_SIG_PIN: C10.1; also elsewhere on the board

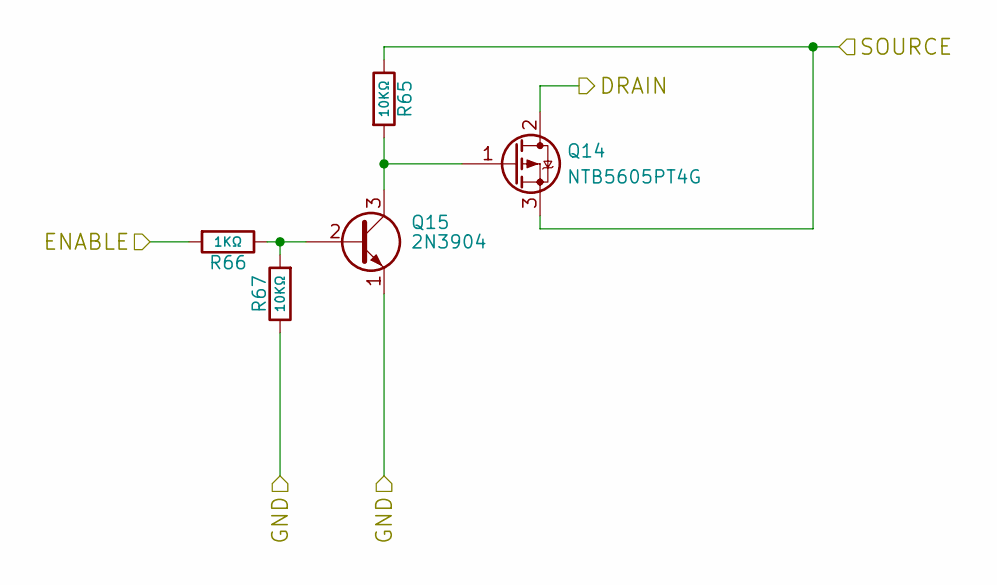
[picture p134: schematic filePMOS1.sch, Hitchco MK4]

Parts:
Q3: NTB5605PT4G; TO-263-3_TabPin2; digikey-pn NTB5605PT4GOSCT-ND
Q4: 2N3904; TO-92_Inline_Narrow_Oval; digikey-pn 2N3904FS-ND
R27, R29: 10KΩ; R_Axial_DIN0204_L3.6mm_D1.6mm_P5.08mm_Horizontal; digikey-pn BC10.0KXCT-ND
R28: 1KΩ; R_Axial_DIN0204_L3.6mm_D1.6mm_P5.08mm_Horizontal; digikey-pn BC1.00KXCT-ND

Connections:
/GND: Q4.1 (E), R29.1; also elsewhere on the board
/STEN: Q3.2 (D); also elsewhere on the board
/VBAT+: Q3.3 (S), R27.1; also elsewhere on the board
unnamed: Q3.1 (G), Q4.3 (C), R27.2
unnamed: Q4.2 (B), R28.1, R29.2
STEN_EN_PIN: R28.2; also elsewhere on the board

Parts of its further copies:
Q5, Q8, Q10, Q14, Q16, Q18, Q23, Q25, Q27, Q29, Q33, Q35, Q37, Q39: NTB5605PT4G; TO-263-3_TabPin2; digikey-pn NTB5605PT4GOSCT-ND
Q6, Q9, Q11, Q15, Q17, Q19, Q24, Q26, Q28, Q30, Q34, Q36, Q38, Q40: 2N3904; TO-92_Inline_Narrow_Oval; digikey-pn 2N3904FS-ND
R31, R33, R38, R40, R42, R44, R65, R67, R69, R71, R73, R75, R90, R92, R94, R96, R98, R100, R102, R104, R110, R112, R114, R116, R120, R122, R124, R126: 10KΩ; R_Axial_DIN0204_L3.6mm_D1.6mm_P5.08mm_Horizontal; digikey-pn BC10.0KXCT-ND
R32, R39, R43, R66, R70, R74, R91, R95, R99, R103, R111, R115, R121, R125: 1KΩ; R_Axial_DIN0204_L3.6mm_D1.6mm_P5.08mm_Horizontal; digikey-pn BC1.00KXCT-ND

Connections of its further copies:
/CRZB: Q14.2 (D); also elsewhere on the board
/CRZG: Q16.2 (D); also elsewhere on the board
/CRZR: Q14.3 (S), Q16.3 (S), Q18.3 (S), R65.1, R69.1, R73.1; also elsewhere on the board
/CRZY: Q18.2 (D); also elsewhere on the board
/DIRL: Q37.2 (D); also elsewhere on the board
/DIRR: Q39.2 (D); also elsewhere on the board
/GND: Q6.1 (E), Q9.1 (E), Q11.1 (E), Q15.1 (E), Q17.1 (E), Q19.1 (E), Q24.1 (E), Q26.1 (E), Q28.1 (E), Q30.1 (E), Q34.1 (E), Q36.1 (E), Q38.1 (E), Q40.1 (E), R33.1, R40.1, R44.1, R67.1, R71.1, R75.1, R92.1, R96.1, R100.1, R104.1, R112.1, R116.1, R122.1, R126.1; also elsewhere on the board
/GPP0: Q33.2 (D); also elsewhere on the board
/GPP1: Q35.2 (D); also elsewhere on the board
/PSU2_12V: Q25.2 (D); also elsewhere on the board
/PSU3_12V: Q23.2 (D); also elsewhere on the board
/PSU4_12V: Q27.2 (D); also elsewhere on the board
/RUEN1: Q29.2 (D); also elsewhere on the board
/RUEN2: Q5.2 (D); also elsewhere on the board
/VBAT+: Q5.3 (S), Q8.3 (S), Q10.3 (S), Q23.3 (S), Q25.3 (S), Q27.3 (S), Q29.3 (S), Q33.3 (S), Q35.3 (S), Q37.3 (S), Q39.3 (S), R31.1, R38.1, R42.1, R90.1, R94.1, R98.1, R102.1, R110.1, R114.1, R120.1, R124.1; also elsewhere on the board
/WIPEH: Q10.2 (D); also elsewhere on the board
/WIPEL: Q8.2 (D); also elsewhere on the board
CRZ_DISABLE_PIN: R66.2; also elsewhere on the board
CRZ_MAINTAIN_PIN: R70.2; also elsewhere on the board
CRZ_RESUME_PIN: R74.2; also elsewhere on the board
DIRL_EN_PIN: R121.2; also elsewhere on the board
DIRR_EN_PIN: R125.2; also elsewhere on the board
GPP0_EN_PIN: R111.2; also elsewhere on the board
GPP1_EN_PIN: R115.2; also elsewhere on the board
unnamed: Q5.1 (G), Q6.3 (C), R31.2
unnamed: Q6.2 (B), R32.1, R33.2
unnamed: Q8.1 (G), Q9.3 (C), R38.2
unnamed: Q9.2 (B), R39.1, R40.2
unnamed: Q10.1 (G), Q11.3 (C), R42.2
unnamed: Q11.2 (B), R43.1, R44.2
unnamed: Q14.1 (G), Q15.3 (C), R65.2
unnamed: Q15.2 (B), R66.1, R67.2
unnamed: Q16.1 (G), Q17.3 (C), R69.2
unnamed: Q17.2 (B), R70.1, R71.2
unnamed: Q18.1 (G), Q19.3 (C), R73.2
unnamed: Q19.2 (B), R74.1, R75.2
unnamed: Q23.1 (G), Q24.3 (C), R90.2
unnamed: Q24.2 (B), R91.1, R92.2
unnamed: Q25.1 (G), Q26.3 (C), R94.2
unnamed: Q26.2 (B), R95.1, R96.2
unnamed: Q27.1 (G), Q28.3 (C), R98.2
unnamed: Q28.2 (B), R99.1, R100.2
unnamed: Q29.1 (G), Q30.3 (C), R102.2
unnamed: Q30.2 (B), R103.1, R104.2
unnamed: Q33.1 (G), Q34.3 (C), R110.2
unnamed: Q34.2 (B), R111.1, R112.2
unnamed: Q35.1 (G), Q36.3 (C), R114.2
unnamed: Q36.2 (B), R115.1, R116.2
unnamed: Q37.1 (G), Q38.3 (C), R120.2
unnamed: Q38.2 (B), R121.1, R122.2
unnamed: Q39.1 (G), Q40.3 (C), R124.2
unnamed: Q40.2 (B), R125.1, R126.2
PSU2_EN_PIN: R95.2; also elsewhere on the board
PSU3_EN_PIN: R91.2; also elsewhere on the board
PSU4_EN_PIN: R99.2; also elsewhere on the board
RUEN_EN_PIN: R32.2, R103.2; also elsewhere on the board
WIPEH_EN_PIN: R43.2; also elsewhere on the board
WIPEL_EN_PIN: R39.2; also elsewhere on the board

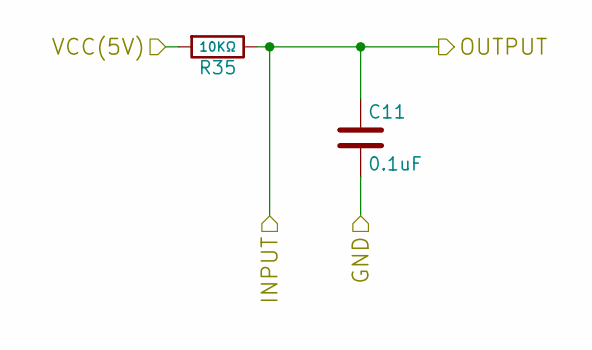
[picture p135: schematic fileSwitch1.sch, Hitchco MK4]

Parts:
C11: 0.1uF; C_Rect_L5.08mm_W3.175mm_P2.54mm; digikey-pn 478-5096-ND
R35: 10KΩ; R_Axial_DIN0204_L3.6mm_D1.6mm_P5.08mm_Horizontal; digikey-pn BC10.0KXCT-ND

Connections:
/5V: R35.2; also elsewhere on the board
/GND: C11.2; also elsewhere on the board
OILL_SIG_PIN: C11.1, R35.1; also elsewhere on the board

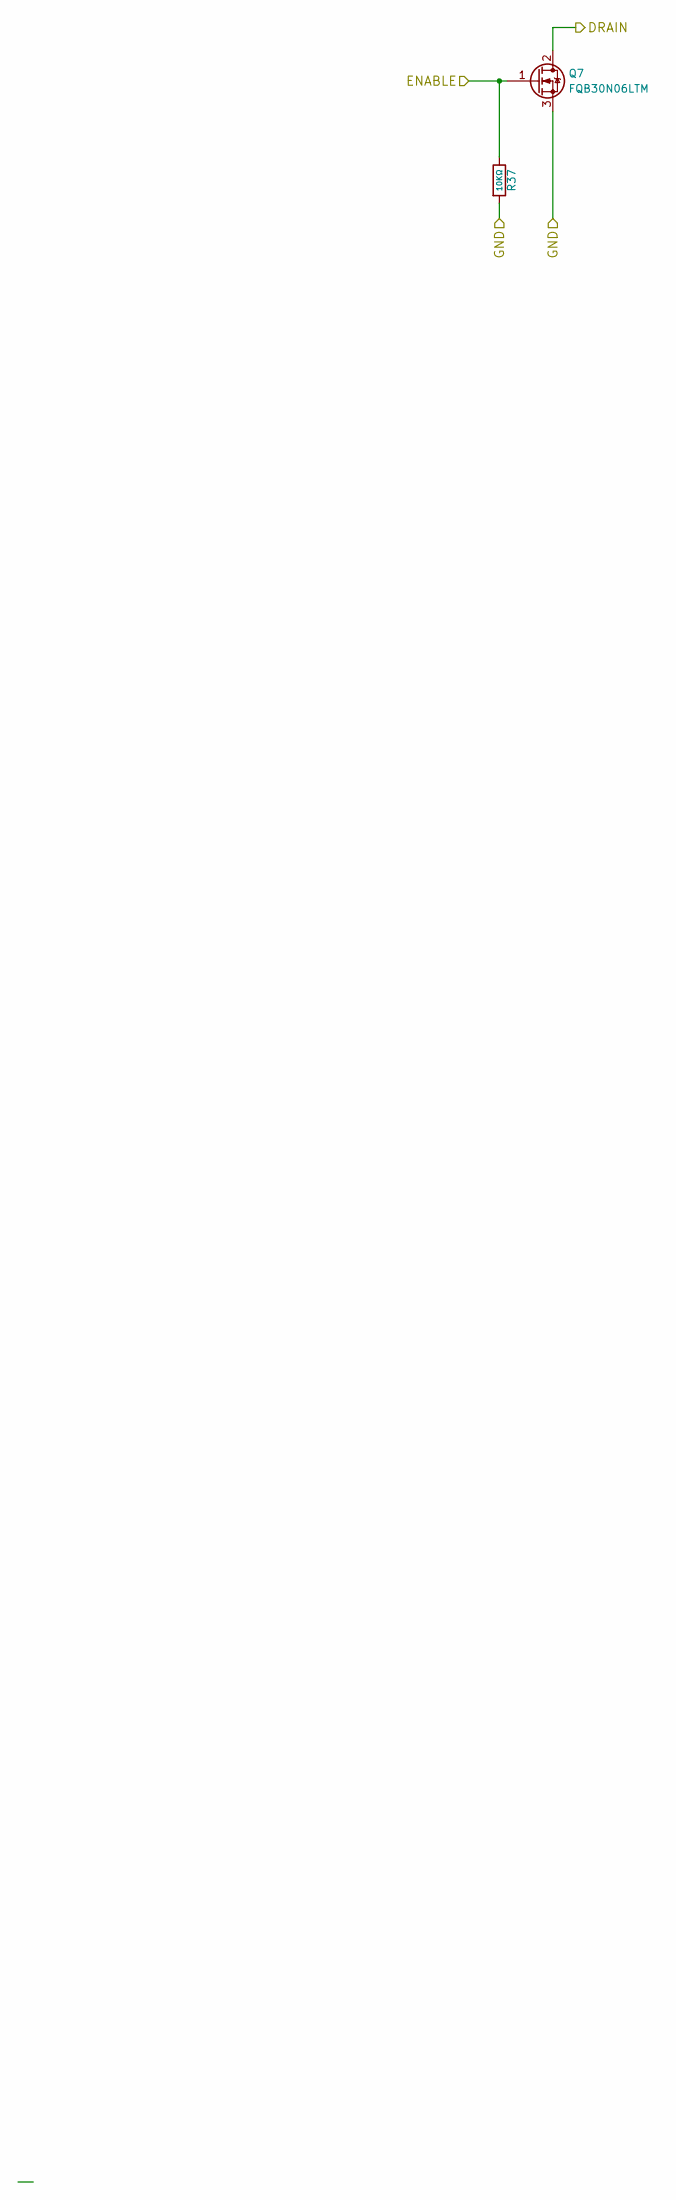
[picture p136: schematic fileNMOS1.sch, Hitchco MK4]

Parts:
Q7: FQB30N06LTM; TO-263-3_TabPin2; digikey-pn FQB30N06LTMCT-ND
R37: 10KΩ; R_Axial_DIN0204_L3.6mm_D1.6mm_P5.08mm_Horizontal; digikey-pn BC10.0KXCT-ND

Connections:
/ECF: Q7.2 (D); also elsewhere on the board
/GND: Q7.3 (S), R37.2; also elsewhere on the board
ECF_EN_PIN: Q7.1 (G), R37.1; also elsewhere on the board

Parts of its further copies:
Q12, Q13, Q31, Q32: FQB30N06LTM; TO-263-3_TabPin2; digikey-pn FQB30N06LTMCT-ND
R62, R64, R107, R109: 10KΩ; R_Axial_DIN0204_L3.6mm_D1.6mm_P5.08mm_Horizontal; digikey-pn BC10.0KXCT-ND

Connections of its further copies:
/GND: Q12.3 (S), Q13.3 (S), Q31.3 (S), Q32.3 (S), R62.2, R64.2, R107.2, R109.2; also elsewhere on the board
/GPN0: Q31.2 (D); also elsewhere on the board
/GPN1: Q32.2 (D); also elsewhere on the board
/hitchco-mk4/LED1-: Q12.2 (D); also elsewhere on the board
/hitchco-mk4/LED2-: Q13.2 (D); also elsewhere on the board
GPN0_EN_PIN: Q31.1 (G), R107.1; also elsewhere on the board
GPN1_EN_PIN: Q32.1 (G), R109.1; also elsewhere on the board
LED1_EN_PIN: Q12.1 (G), R62.1; also elsewhere on the board
LED2_EN_PIN: Q13.1 (G), R64.1; also elsewhere on the board

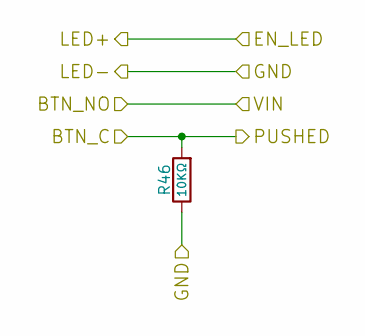
[picture p137: schematic pushbutton.sch, Hitchco MK4]

Parts:
R46: 10KΩ; R_Axial_DIN0204_L3.6mm_D1.6mm_P5.08mm_Horizontal; digikey-pn BC10.0KXCT-ND

Connections:
/GND: R46.1; also elsewhere on the board
PB1_SIG_PIN: R46.2; also elsewhere on the board

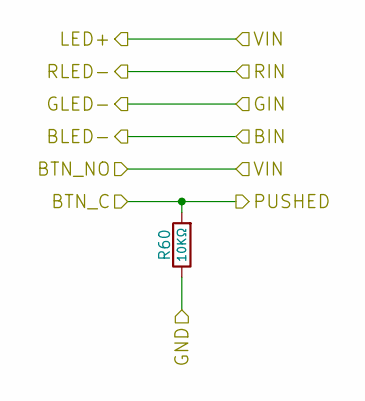
[picture p138: schematic rgbpushbutton.sch, Hitchco MK4]

Parts:
R60: 10KΩ; R_Axial_DIN0204_L3.6mm_D1.6mm_P5.08mm_Horizontal; digikey-pn BC10.0KXCT-ND

Connections:
/GND: R60.1; also elsewhere on the board
PB8_SIG_PIN: R60.2; also elsewhere on the board
