ferdymercury/Controller-Electrical-Schematics/kicad/hitchco-mk4.kicad_pcb

## KiCad design kicad/hitchco-mk4.kicad_pcb (continued)

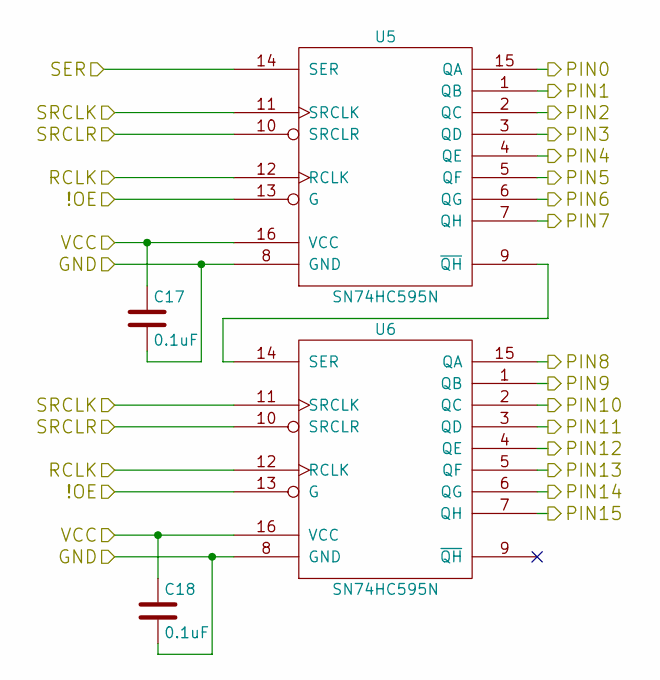
[picture p139: schematic fileShiftBlock.sch, Hitchco MK4]

Parts:
C17, C18: 0.1uF; C_Rect_L5.08mm_W3.175mm_P2.54mm; digikey-pn 478-5096-ND
U5, U6: SN74HC595N; DIP-16_W7.62mm_Socket; digikey-pn 296-1600-5-ND

Connections:
/5V: C17.1, C18.1, U5.16 (VCC), U6.16 (VCC); also elsewhere on the board
/GND: C17.2, C18.2, U5.8 (GND), U6.8 (GND); also elsewhere on the board
/hitchco-mk4/ShiftBlock/PIN2: U5.2 (QC)
/hitchco-mk4/ShiftBlock/PIN15: U6.7 (QH)
unnamed: U5.9 (~QH), U6.14 (SER)
PB1_LED_EN: U5.15 (QA); also elsewhere on the board
PB2_LED_EN: U5.1 (QB); also elsewhere on the board
PB4_LED_EN: U5.3 (QD); also elsewhere on the board
PB6_LED_EN: U5.4 (QE); also elsewhere on the board
PB7_LED_EN: U5.5 (QF); also elsewhere on the board
PB9_LED_EN: U5.6 (QG); also elsewhere on the board
PB10_LED_EN: U5.7 (QH); also elsewhere on the board
PB11_LED_EN: U6.15 (QA); also elsewhere on the board
PB12_LED_EN: U6.1 (QB); also elsewhere on the board
PB13_LED_EN: U6.2 (QC); also elsewhere on the board
PB14_LED_EN: U6.3 (QD); also elsewhere on the board
PB15_LED_EN: U6.4 (QE); also elsewhere on the board
PB16_LED_EN: U6.5 (QF); also elsewhere on the board
PB17_LED_EN: U6.6 (QG); also elsewhere on the board
SREG_OE_PIN: U5.13 (G), U6.13 (G); also elsewhere on the board
SREG_RCLK_PIN: U5.12 (RCLK), U6.12 (RCLK); also elsewhere on the board
SREG_SER_PIN: U5.14 (SER); also elsewhere on the board
SREG_SRCLK_PIN: U5.11 (SRCLK), U6.11 (SRCLK); also elsewhere on the board
SREG_SRCLR_PIN: U5.10 (SRCLR), U6.10 (SRCLR); also elsewhere on the board

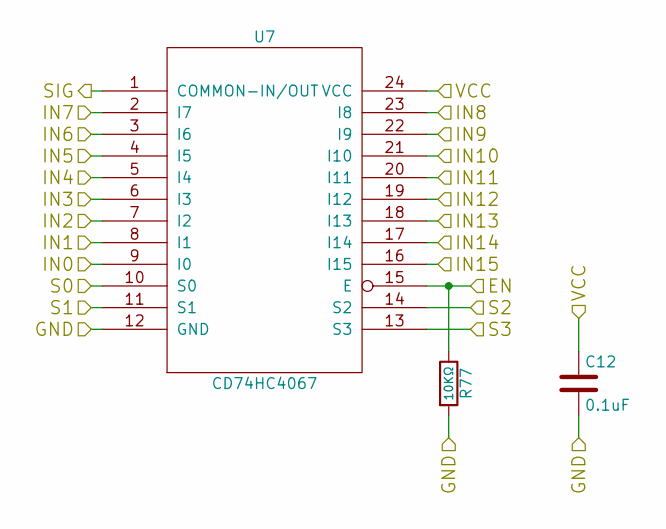
[picture p140: schematic fileMuxBlock.sch, Hitchco MK4]

Parts:
C12: 0.1uF; C_Rect_L5.08mm_W3.175mm_P2.54mm; digikey-pn 478-5096-ND
R77: 10KΩ; R_Axial_DIN0204_L3.6mm_D1.6mm_P5.08mm_Horizontal; digikey-pn BC10.0KXCT-ND
U7: CD74HC4067; SOIC-24W_7.5x15.4mm_Pitch1.27mm; digikey-pn 296-23078-ND

Connections:
/5V: C12.1, U7.24 (VCC); also elsewhere on the board
/GND: C12.2, R77.2, U7.12 (GND); also elsewhere on the board
/hitchco-mk4/MuxBlock/IN2: U7.7 (I2)
/hitchco-mk4/MuxBlock/IN15: U7.16 (I15)
MUX_EN_PIN: R77.1, U7.15 (E); also elsewhere on the board
MUX_S0_PIN: U7.10 (S0); also elsewhere on the board
MUX_S1_PIN: U7.11 (S1); also elsewhere on the board
MUX_S2_PIN: U7.14 (S2); also elsewhere on the board
MUX_S3_PIN: U7.13 (S3); also elsewhere on the board
MUX_SIG_PIN: U7.1 (COMMON-IN/OUT); also elsewhere on the board
PB1_SIG_PIN: U7.9 (I0); also elsewhere on the board
PB2_SIG_PIN: U7.8 (I1); also elsewhere on the board
PB4_SIG_PIN: U7.6 (I3); also elsewhere on the board
PB6_SIG_PIN: U7.5 (I4); also elsewhere on the board
PB7_SIG_PIN: U7.4 (I5); also elsewhere on the board
PB9_SIG_PIN: U7.3 (I6); also elsewhere on the board
PB10_SIG_PIN: U7.2 (I7); also elsewhere on the board
PB11_SIG_PIN: U7.23 (I8); also elsewhere on the board
PB12_SIG_PIN: U7.22 (I9); also elsewhere on the board
PB13_SIG_PIN: U7.21 (I10); also elsewhere on the board
PB14_SIG_PIN: U7.20 (I11); also elsewhere on the board
PB15_SIG_PIN: U7.19 (I12); also elsewhere on the board
PB16_SIG_PIN: U7.18 (I13); also elsewhere on the board
PB17_SIG_PIN: U7.17 (I14); also elsewhere on the board

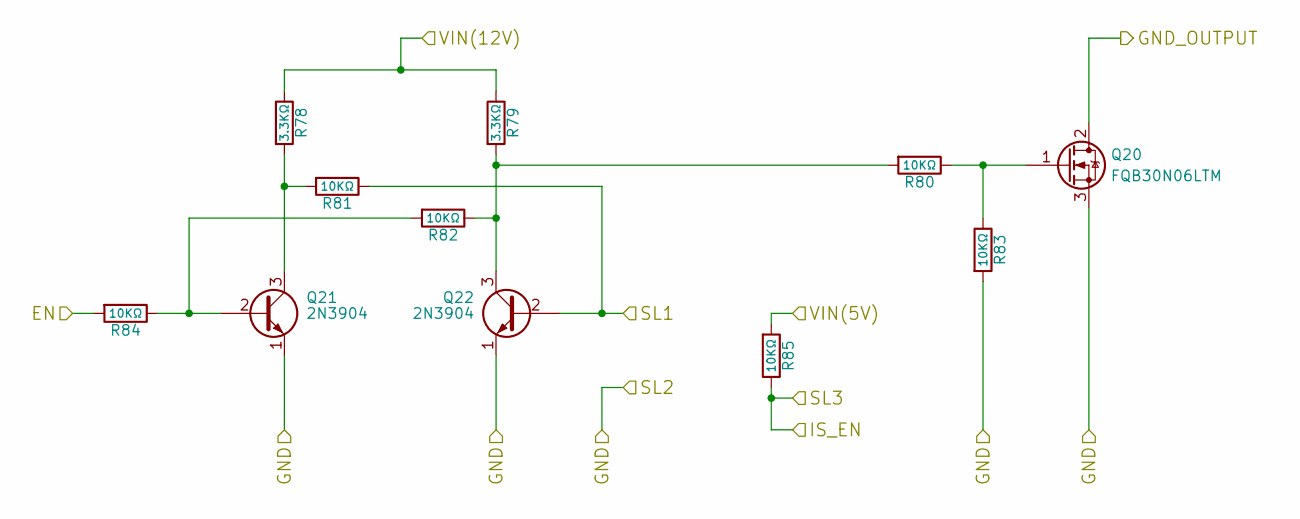
[picture p141: schematic fileSoftPowerSwitch.sch, Hitchco MK4]

Parts:
Q20: FQB30N06LTM; TO-263-3_TabPin2; digikey-pn FQB30N06LTMCT-ND
Q21, Q22: 2N3904; TO-92_Inline_Narrow_Oval; digikey-pn 2N3904FS-ND
R78, R79: 3.3KΩ; R_Axial_DIN0204_L3.6mm_D1.6mm_P5.08mm_Horizontal; digikey-pn BC3499CT-ND
R80, R81, R82, R83, R84, R85: 10KΩ; R_Axial_DIN0204_L3.6mm_D1.6mm_P5.08mm_Horizontal; digikey-pn BC10.0KXCT-ND

Connections:
/5V: R85.2; also elsewhere on the board
/GND: Q20.3 (S), Q21.1 (E), Q22.1 (E), R83.2; also elsewhere on the board
/VBAT+: R78.1, R79.1; also elsewhere on the board
/hitchco-mk4/RS1_L1: Q22.2 (B), R81.1; also elsewhere on the board
/hitchco-mk4/SoftPowerSwitch/GND_OUTPUT: Q20.2 (D); also elsewhere on the board
unnamed: Q20.1 (G), R80.1, R83.1
unnamed: Q21.2 (B), R82.2, R84.1
unnamed: Q21.3 (C), R78.2, R81.2
unnamed: Q22.3 (C), R79.2, R80.2, R82.1
PSU1_EN_PIN: R84.2; also elsewhere on the board
PSU1_SIG_PIN: R85.1; also elsewhere on the board

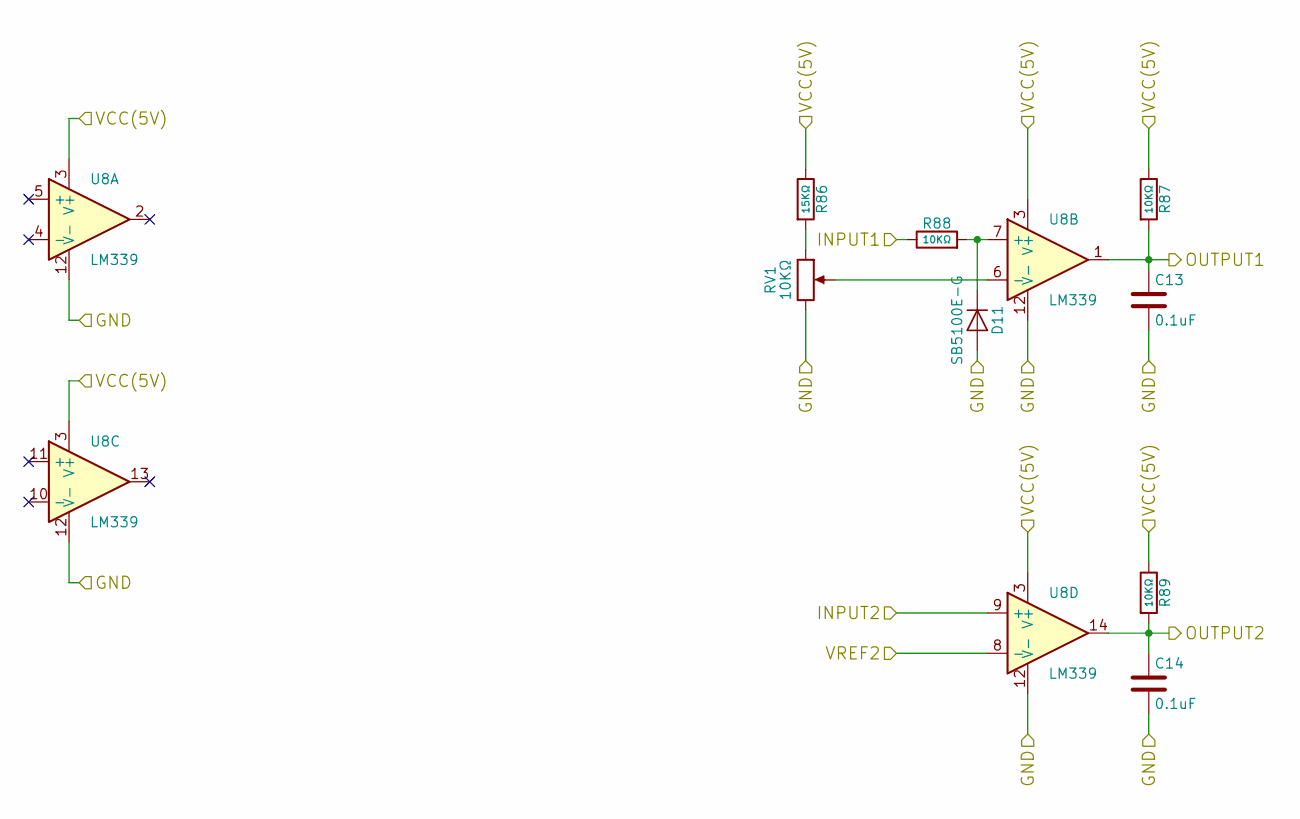
[picture p142: schematic fileComparator1.sch, Hitchco MK4]

Parts:
C13, C14: 0.1uF; C_Rect_L5.08mm_W3.175mm_P2.54mm; digikey-pn 478-5096-ND
D11: SB5100E-G; D_DO-201AD_P15.24mm_Horizontal; digikey-pn 641-1421-1-ND
R86: 15KΩ; R_Axial_DIN0204_L3.6mm_D1.6mm_P5.08mm_Horizontal; digikey-pn BC3248CT-ND
R87, R88, R89: 10KΩ; R_Axial_DIN0204_L3.6mm_D1.6mm_P5.08mm_Horizontal; digikey-pn BC10.0KXCT-ND
RV1: 10KΩ; Potentiometer_Trimmer_Bourns_PV36W; digikey-pn 490-2875-ND
U8: LM339; DIP-14_W7.62mm_Socket; digikey-pn 296-1393-5-ND

Connections:
3V3: U8.8 (-); also elsewhere on the board
/5V: R86.1, R87.1, R89.1, U8.3 (V+); also elsewhere on the board
/GND: C13.2, C14.2, D11.2 (A), RV1.3, U8.12 (V-); also elsewhere on the board
/SPED: R88.1; also elsewhere on the board
/TACK: U8.9 (+); also elsewhere on the board
unnamed: D11.1 (K), R88.2, U8.7 (+)
unnamed: R86.2, RV1.1
unnamed: RV1.2, U8.6 (-)
SPED_SIG_PIN: C13.1, R87.2, U8.1; also elsewhere on the board
TACK_SIG_PIN: C14.1, R89.2, U8.14; also elsewhere on the board

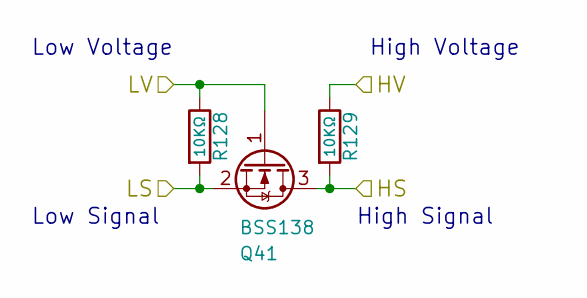
[picture p143: schematic logicLevelShift.sch, Hitchco MK4]

Parts:
Q41: BSS138; SOT-23; digikey-pn BSS138LT1GOSCT-ND
R128, R129: 10KΩ; R_Axial_DIN0204_L3.6mm_D1.6mm_P5.08mm_Horizontal; digikey-pn BC10.0KXCT-ND

Connections:
/5V: R129.1; also elsewhere on the board
/hitchco-mk4/RPI3V3: Q41.1 (G), R128.1; also elsewhere on the board
/hitchco-mk4/RPITX: Q41.2 (S), R128.2; also elsewhere on the board
RPI_TX: Q41.3 (D), R129.2; also elsewhere on the board

Parts of its further copies:
Q42: BSS138; SOT-23; digikey-pn BSS138LT1GOSCT-ND
R130, R131: 10KΩ; R_Axial_DIN0204_L3.6mm_D1.6mm_P5.08mm_Horizontal; digikey-pn BC10.0KXCT-ND

Connections of its further copies:
/5V: R131.1; also elsewhere on the board
/hitchco-mk4/RPI3V3: Q42.1 (G), R130.1; also elsewhere on the board
/hitchco-mk4/RPIRX: Q42.2 (S), R130.2; also elsewhere on the board
RPI_RX: Q42.3 (D), R131.2; also elsewhere on the board

Notes on the sheet:
Low Voltage
High Voltage
Low Signal
High Signal

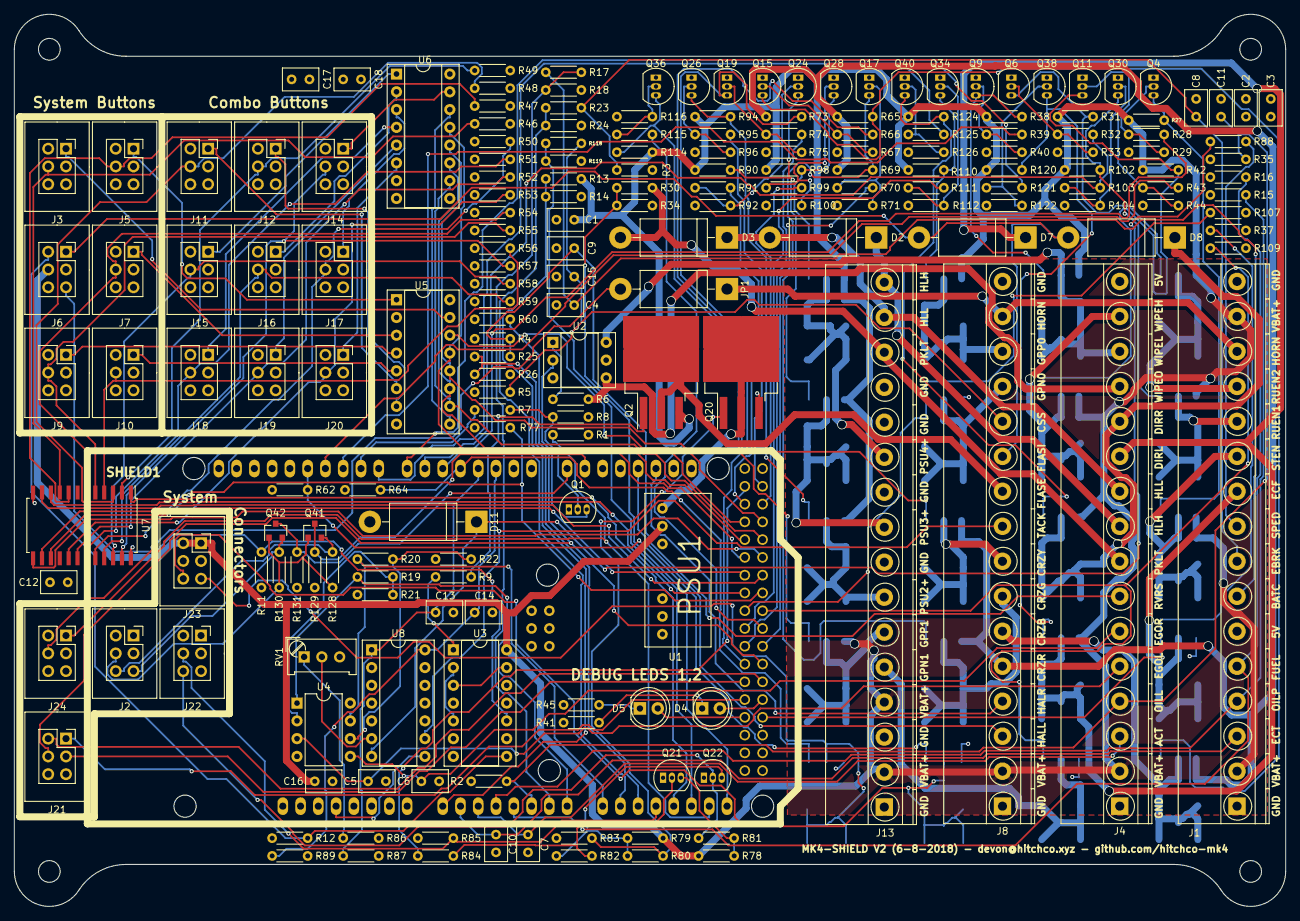
[picture p144: board kicad/hitchco-mk4.kicad_pcb from above]

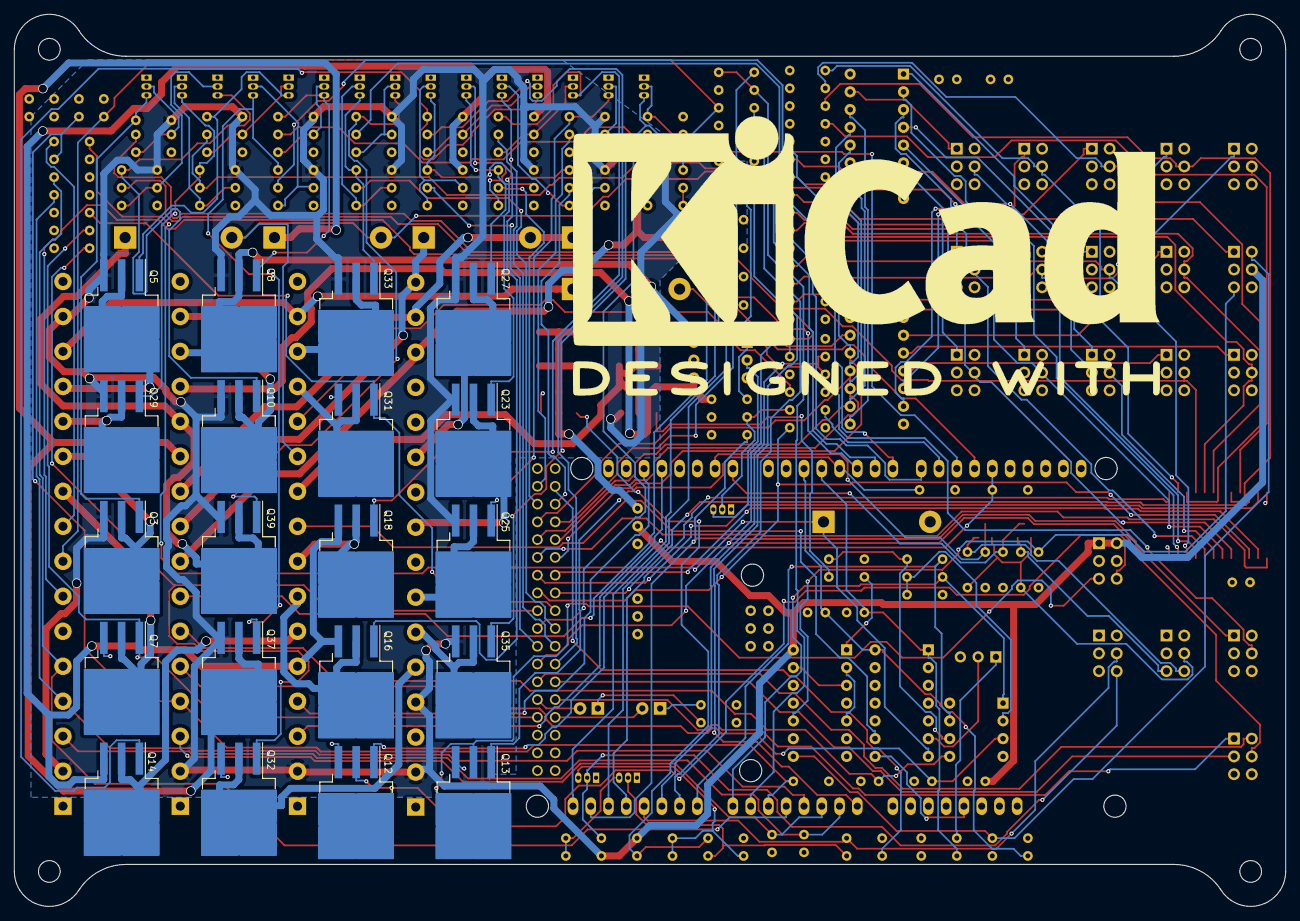
[picture p145: board kicad/hitchco-mk4.kicad_pcb from below]

Board: 4 copper layers, 181.7 x 127.5 mm, 216 parts (20 on the bottom side), 184 nets.

Other parts of the board:
R47, R48, R49, R50, R51, R52, R53, R54, R55, R56, R57, R58, R59: 10K; R_Axial_DIN0204_L3.6mm_D1.6mm_P5.08mm_Horizontal

Their connections:
/GND: R47.1, R48.1, R49.1, R50.1, R51.1, R52.1, R53.1, R54.1, R55.1, R56.1, R57.1, R58.1, R59.1; also elsewhere on the board
PB2_SIG_PIN: R47.2; also elsewhere on the board
PB4_SIG_PIN: R54.2; also elsewhere on the board
PB6_SIG_PIN: R55.2; also elsewhere on the board
PB7_SIG_PIN: R56.2; also elsewhere on the board
PB9_SIG_PIN: R48.2; also elsewhere on the board
PB10_SIG_PIN: R49.2; also elsewhere on the board
PB11_SIG_PIN: R57.2; also elsewhere on the board
PB12_SIG_PIN: R58.2; also elsewhere on the board
PB13_SIG_PIN: R59.2; also elsewhere on the board
PB14_SIG_PIN: R50.2; also elsewhere on the board
PB15_SIG_PIN: R51.2; also elsewhere on the board
PB16_SIG_PIN: R52.2; also elsewhere on the board
PB17_SIG_PIN: R53.2; also elsewhere on the board
