ferdymercury/Controller-Electrical-Schematics/revision-1-do-not-use/mk4-v1-blank-board/kicad/hitchco-mk4.kicad_pcb

## KiCad design revision-1-do-not-use/mk4-v1-blank-board/kicad/hitchco-mk4.kicad_pcb (2018-07-02)

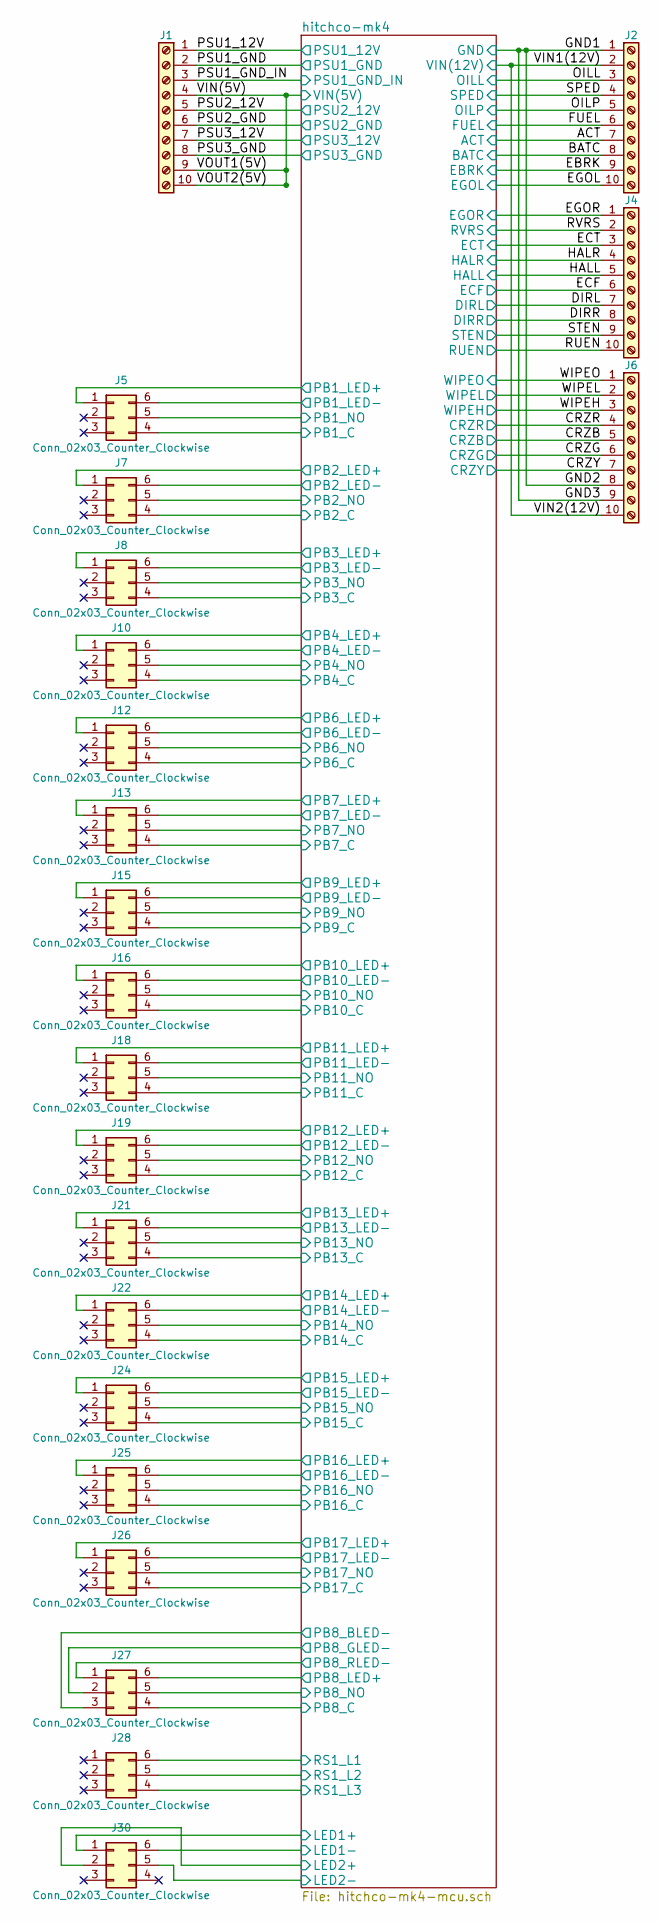
[picture p146: schematic hitchco-mk4.sch, Hitchco MK4]

Parts:
J1, J2, J4, J6: Screw_Terminal_01x10; TerminalBlock_Phoenix_MKDS1.5-10pol
J5: Conn_02x03_Counter_Clockwise; Shroud_Socket_Strip_Straight_2x03_Pitch2.54mm
J7, J8, J10, J12, J13, J15, J16, J18, J19, J21, J22, J24, J25, J26, J27, J28, J30: Conn_02x03_Counter_Clockwise; Socket_Strip_Straight_2x03_Pitch2.54mm

Connections:
/BATC: J2.8; also elsewhere on the board
/CRZB: J6.5; also elsewhere on the board
/CRZG: J6.6; also elsewhere on the board
/CRZR: J6.4; also elsewhere on the board
/CRZY: J6.7; also elsewhere on the board
/DIRL: J4.7; also elsewhere on the board
/DIRR: J4.8; also elsewhere on the board
/EBRK: J2.9; also elsewhere on the board
/ECF: J4.6; also elsewhere on the board
/EGOL: J2.10; also elsewhere on the board
/EGOR: J4.1; also elsewhere on the board
/GND1: J1.3, J2.1, J5.6, J6.8, J6.9, J7.6, J8.6, J10.6, J12.6, J13.6, J15.6, J16.6, J18.1, J18.6, J19.6, J21.6, J22.6, J24.6, J25.6, J26.6, J28.5; also elsewhere on the board
/HALL: J4.5; also elsewhere on the board
/HALR: J4.4; also elsewhere on the board
/PSU1_12V: J1.1, J1.5, J1.7, J2.2, J6.10, J30.1, J30.2; also elsewhere on the board
/PSU1_GND: J1.2; also elsewhere on the board
/PSU2_GND: J1.6; also elsewhere on the board
/PSU3_GND: J1.8; also elsewhere on the board
/RUEN: J4.10; also elsewhere on the board
/RVRS: J4.2; also elsewhere on the board
/SPED: J2.4; also elsewhere on the board
/STEN: J4.9; also elsewhere on the board
/VIN(5V): J1.4, J1.9, J1.10, J5.5, J7.5, J8.5, J10.5, J12.5, J13.5, J15.5, J16.5, J18.5, J19.5, J21.5, J22.5, J24.5, J25.5, J26.5, J27.5, J27.6; also elsewhere on the board
/WIPEH: J6.3; also elsewhere on the board
/WIPEL: J6.2; also elsewhere on the board
/WIPEO: J6.1; also elsewhere on the board
/hitchco-mk4/LED1-: J30.6; also elsewhere on the board
/hitchco-mk4/LED2-: J30.5; also elsewhere on the board
/hitchco-mk4/RS1_L1: J28.6; also elsewhere on the board
ACT_SIG_PIN: J2.7; also elsewhere on the board
ECT_SIG_PIN: J4.3; also elsewhere on the board
FUEL_SIG_PIN: J2.6; also elsewhere on the board
OILL_SIG_PIN: J2.3; also elsewhere on the board
OILP_SIG_PIN: J2.5; also elsewhere on the board
PB1_LED_EN: J5.1; also elsewhere on the board
PB1_SIG_PIN: J5.4; also elsewhere on the board
PB2_LED_EN: J7.1; also elsewhere on the board
PB2_SIG_PIN: J7.4; also elsewhere on the board
PB3_LED_EN: J8.1; also elsewhere on the board
PB3_SIG_PIN: J8.4; also elsewhere on the board
PB4_LED_EN: J10.1; also elsewhere on the board
PB4_SIG_PIN: J10.4; also elsewhere on the board
PB6_LED_EN: J12.1; also elsewhere on the board
PB6_SIG_PIN: J12.4; also elsewhere on the board
PB7_LED_EN: J13.1; also elsewhere on the board
PB7_SIG_PIN: J13.4; also elsewhere on the board
PB8_BLED_EN: J27.3; also elsewhere on the board
PB8_GLED_EN: J27.2; also elsewhere on the board
PB8_RLED_EN: J27.1; also elsewhere on the board
PB8_SIG_PIN: J27.4; also elsewhere on the board
PB9_LED_EN: J15.1; also elsewhere on the board
PB9_SIG_PIN: J15.4; also elsewhere on the board
PB10_LED_EN: J16.1; also elsewhere on the board
PB10_SIG_PIN: J16.4; also elsewhere on the board
PB11_SIG_PIN: J18.4; also elsewhere on the board
PB12_LED_EN: J19.1; also elsewhere on the board
PB12_SIG_PIN: J19.4; also elsewhere on the board
PB13_LED_EN: J21.1; also elsewhere on the board
PB13_SIG_PIN: J21.4; also elsewhere on the board
PB14_LED_EN: J22.1; also elsewhere on the board
PB14_SIG_PIN: J22.4; also elsewhere on the board
PB15_LED_EN: J24.1; also elsewhere on the board
PB15_SIG_PIN: J24.4; also elsewhere on the board
PB16_LED_EN: J25.1; also elsewhere on the board
PB16_SIG_PIN: J25.4; also elsewhere on the board
PB17_LED_EN: J26.1; also elsewhere on the board
PB17_SIG_PIN: J26.4; also elsewhere on the board
PSU1_SIG_PIN: J28.4; also elsewhere on the board

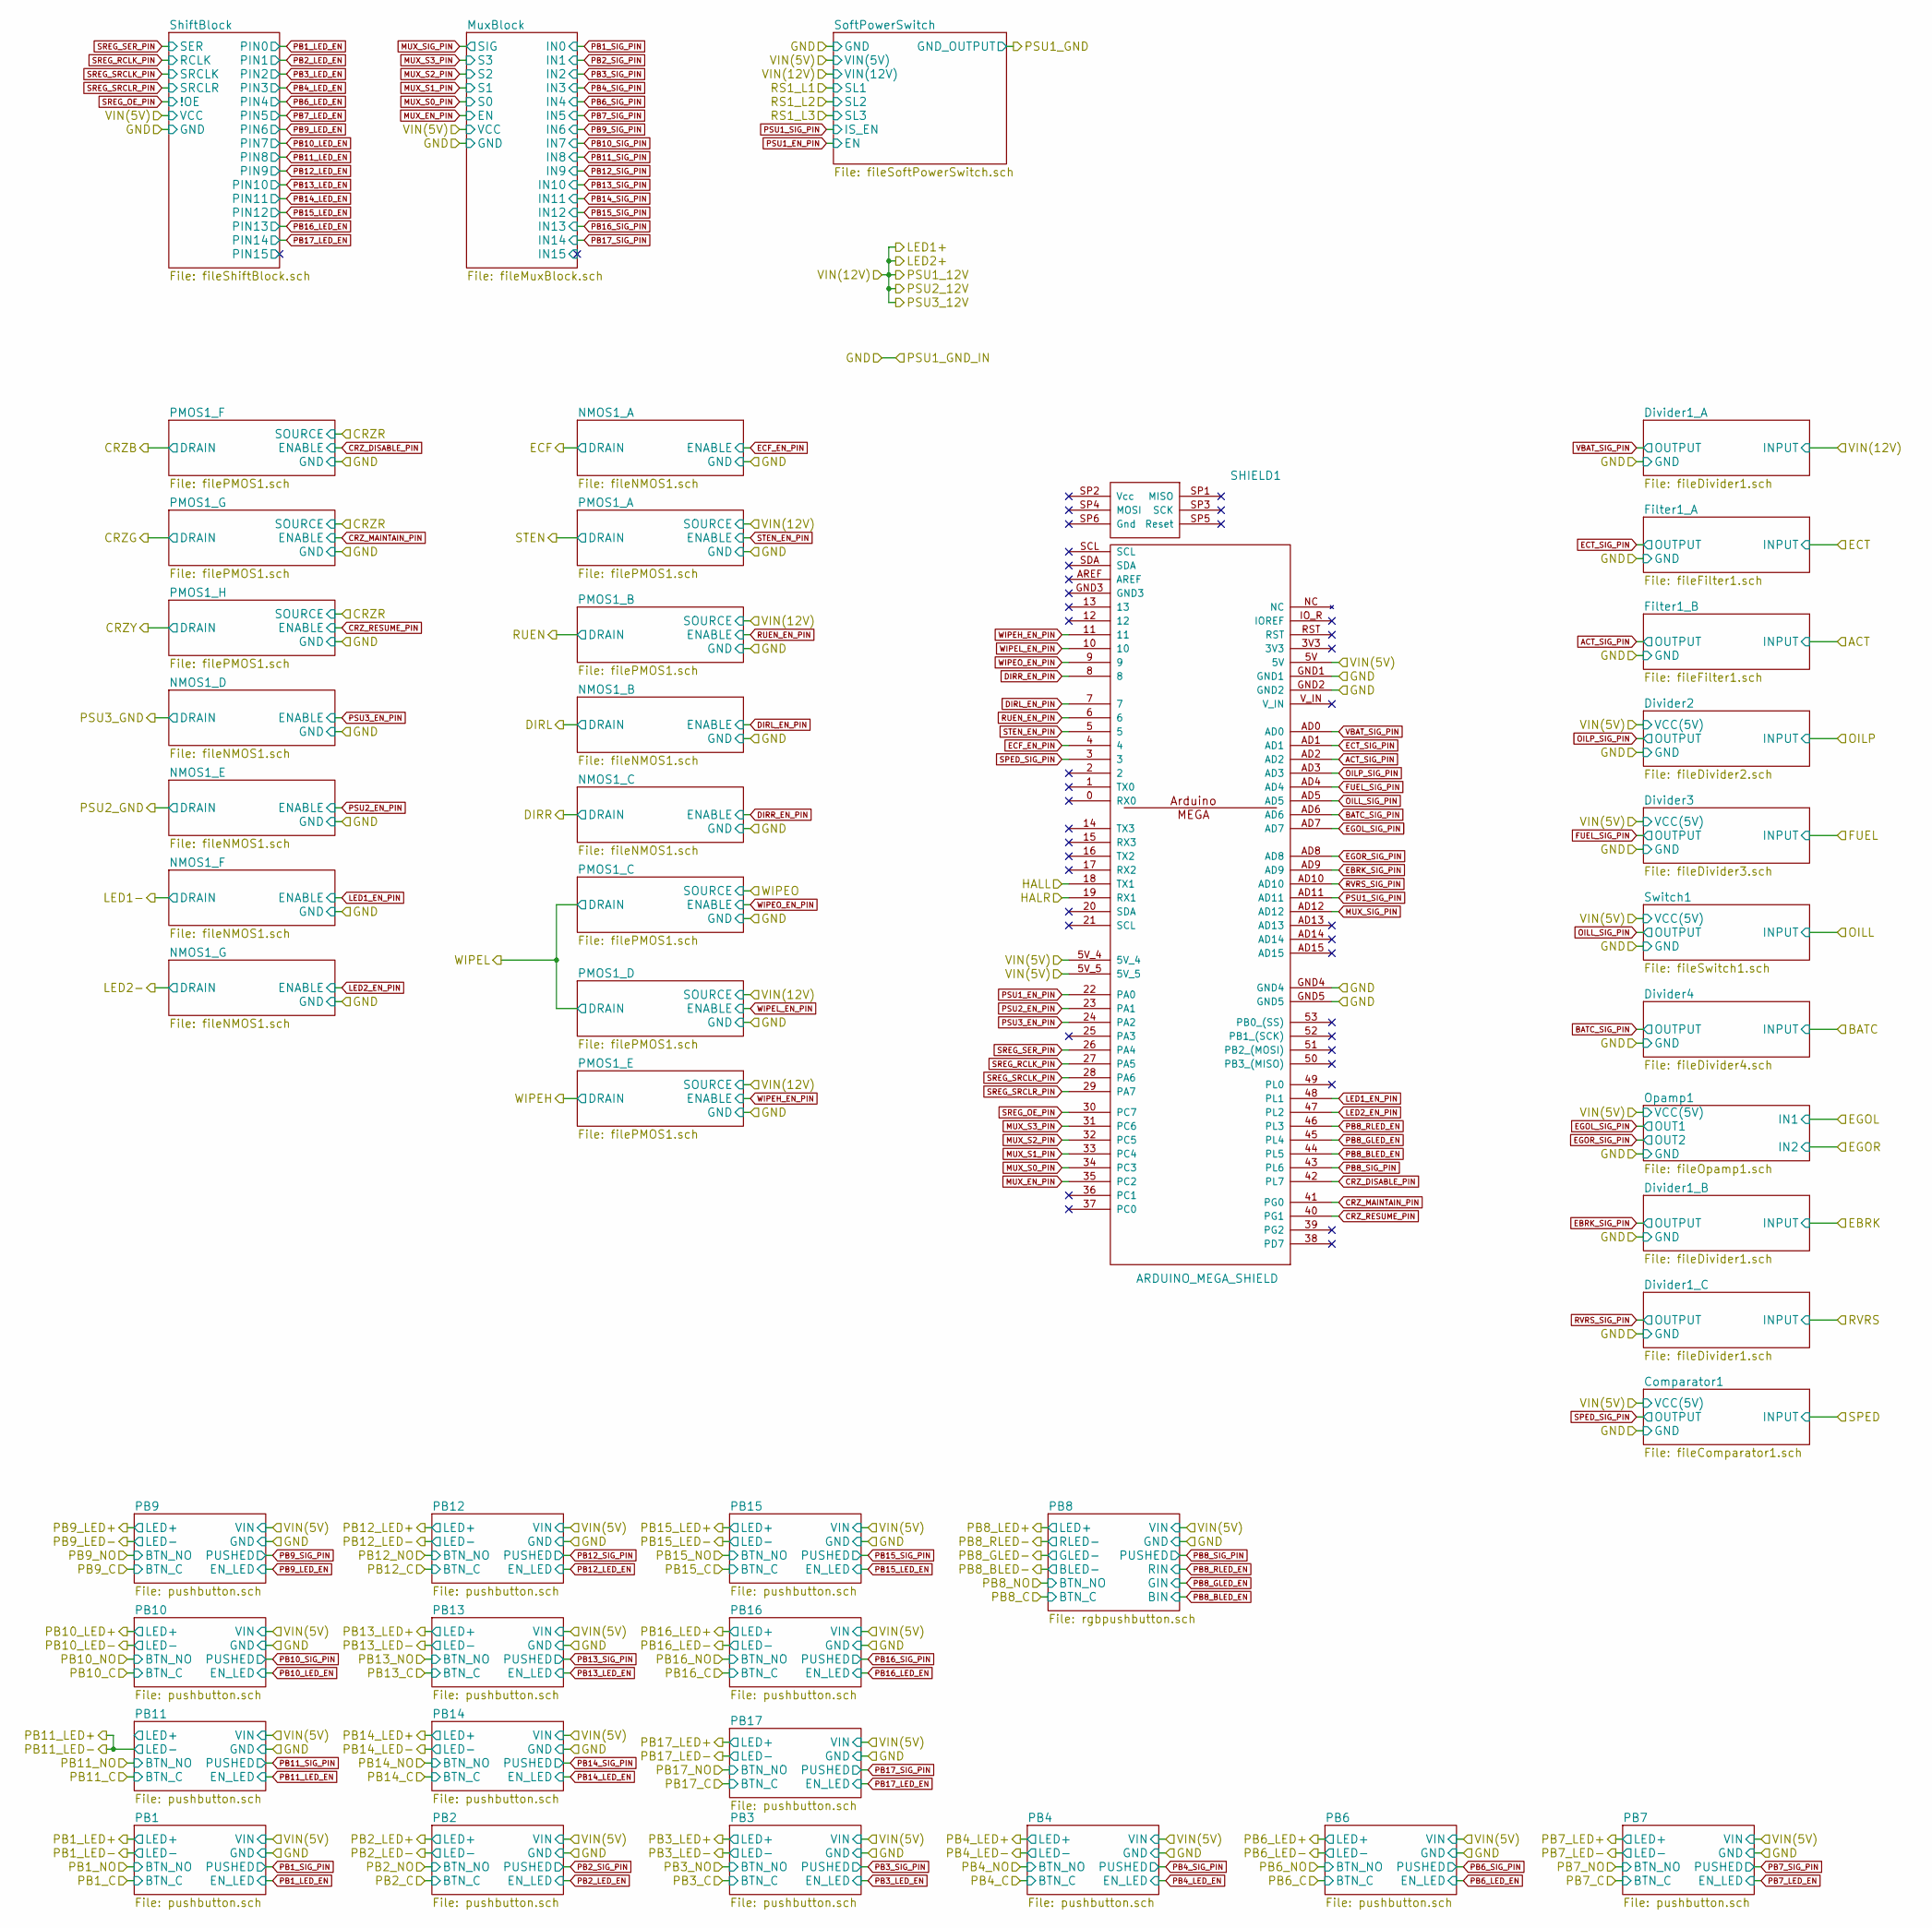
[picture p147: schematic hitchco-mk4-mcu.sch]

Parts:
SHIELD1: ARDUINO_MEGA_SHIELD

Connections:
/GND1: SHIELD1.GND1, SHIELD1.GND2, SHIELD1.GND4, SHIELD1.GND5; also elsewhere on the board
/HALL: SHIELD1.18 (TX1); also elsewhere on the board
/HALR: SHIELD1.19 (RX1); also elsewhere on the board
/VIN(5V): SHIELD1.5V, SHIELD1.5V_4, SHIELD1.5V_5; also elsewhere on the board
ACT_SIG_PIN: SHIELD1.AD2; also elsewhere on the board
BATC_SIG_PIN: SHIELD1.AD6; also elsewhere on the board
CRZ_DISABLE_PIN: SHIELD1.42 (PL7); also elsewhere on the board
CRZ_MAINTAIN_PIN: SHIELD1.41 (PG0); also elsewhere on the board
CRZ_RESUME_PIN: SHIELD1.40 (PG1); also elsewhere on the board
DIRL_EN_PIN: SHIELD1.7; also elsewhere on the board
DIRR_EN_PIN: SHIELD1.8; also elsewhere on the board
EBRK_SIG_PIN: SHIELD1.AD9; also elsewhere on the board
ECF_EN_PIN: SHIELD1.4; also elsewhere on the board
ECT_SIG_PIN: SHIELD1.AD1; also elsewhere on the board
EGOL_SIG_PIN: SHIELD1.AD7; also elsewhere on the board
EGOR_SIG_PIN: SHIELD1.AD8; also elsewhere on the board
FUEL_SIG_PIN: SHIELD1.AD4; also elsewhere on the board
LED1_EN_PIN: SHIELD1.48 (PL1); also elsewhere on the board
LED2_EN_PIN: SHIELD1.47 (PL2); also elsewhere on the board
MUX_EN_PIN: SHIELD1.35 (PC2); also elsewhere on the board
MUX_S0_PIN: SHIELD1.34 (PC3); also elsewhere on the board
MUX_S1_PIN: SHIELD1.33 (PC4); also elsewhere on the board
MUX_S2_PIN: SHIELD1.32 (PC5); also elsewhere on the board
MUX_S3_PIN: SHIELD1.31 (PC6); also elsewhere on the board
MUX_SIG_PIN: SHIELD1.AD12; also elsewhere on the board
OILL_SIG_PIN: SHIELD1.AD5; also elsewhere on the board
OILP_SIG_PIN: SHIELD1.AD3; also elsewhere on the board
PB8_BLED_EN: SHIELD1.44 (PL5); also elsewhere on the board
PB8_GLED_EN: SHIELD1.45 (PL4); also elsewhere on the board
PB8_RLED_EN: SHIELD1.46 (PL3); also elsewhere on the board
PB8_SIG_PIN: SHIELD1.43 (PL6); also elsewhere on the board
PSU1_EN_PIN: SHIELD1.22 (PA0); also elsewhere on the board
PSU1_SIG_PIN: SHIELD1.AD11; also elsewhere on the board
PSU2_EN_PIN: SHIELD1.23 (PA1); also elsewhere on the board
PSU3_EN_PIN: SHIELD1.24 (PA2); also elsewhere on the board
RUEN_EN_PIN: SHIELD1.6; also elsewhere on the board
RVRS_SIG_PIN: SHIELD1.AD10; also elsewhere on the board
SPED_SIG_PIN: SHIELD1.3; also elsewhere on the board
SREG_OE_PIN: SHIELD1.30 (PC7); also elsewhere on the board
SREG_RCLK_PIN: SHIELD1.27 (PA5); also elsewhere on the board
SREG_SER_PIN: SHIELD1.26 (PA4); also elsewhere on the board
SREG_SRCLK_PIN: SHIELD1.28 (PA6); also elsewhere on the board
SREG_SRCLR_PIN: SHIELD1.29 (PA7); also elsewhere on the board
STEN_EN_PIN: SHIELD1.5; also elsewhere on the board
VBAT_SIG_PIN: SHIELD1.AD0; also elsewhere on the board
WIPEH_EN_PIN: SHIELD1.11; also elsewhere on the board
WIPEL_EN_PIN: SHIELD1.10; also elsewhere on the board
WIPEO_EN_PIN: SHIELD1.9; also elsewhere on the board

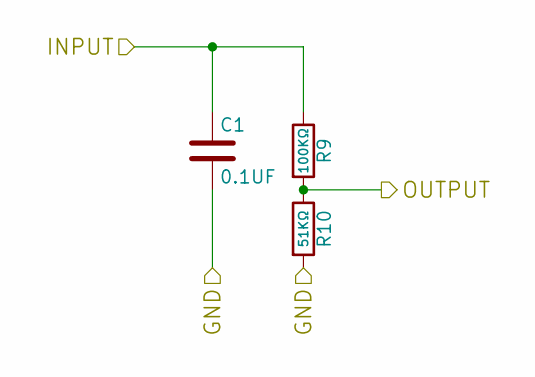
[picture p148: schematic fileDivider1.sch, sensor-mcu]

Parts:
C1: 0.1UF; CP_Radial_D5.0mm_P2.00mm
R9: 100KΩ; R_Axial_DIN0207_L6.3mm_D2.5mm_P10.16mm_Horizontal
R10: 51KΩ; R_Axial_DIN0207_L6.3mm_D2.5mm_P10.16mm_Horizontal

Connections:
/GND1: C1.2, R10.2; also elsewhere on the board
/PSU1_12V: C1.1, R9.1; also elsewhere on the board
VBAT_SIG_PIN: R9.2, R10.1; also elsewhere on the board

Parts of its further copies:
C8, C9: 0.1UF; CP_Radial_D5.0mm_P2.00mm
R21, R23: 100KΩ; R_Axial_DIN0207_L6.3mm_D2.5mm_P10.16mm_Horizontal
R22, R24: 51KΩ; R_Axial_DIN0207_L6.3mm_D2.5mm_P10.16mm_Horizontal

Connections of its further copies:
/EBRK: C8.1, R21.1; also elsewhere on the board
/GND1: C8.2, C9.2, R22.2, R24.2; also elsewhere on the board
/RVRS: C9.1, R23.1; also elsewhere on the board
EBRK_SIG_PIN: R21.2, R22.1; also elsewhere on the board
RVRS_SIG_PIN: R23.2, R24.1; also elsewhere on the board

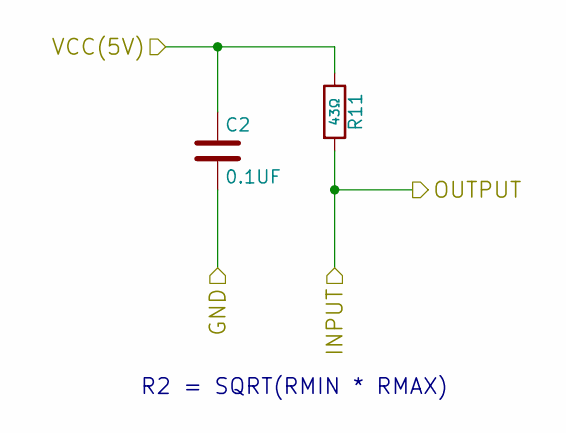
[picture p149: schematic fileDivider2.sch, sensor-mcu]

Parts:
C2: 0.1UF; CP_Radial_D5.0mm_P2.00mm
R11: 43Ω; R_Axial_DIN0207_L6.3mm_D2.5mm_P10.16mm_Horizontal

Connections:
/GND1: C2.2; also elsewhere on the board
/VIN(5V): C2.1, R11.1; also elsewhere on the board
OILP_SIG_PIN: R11.2; also elsewhere on the board

Notes on the sheet:
R2 = SQRT(RMIN * RMAX)

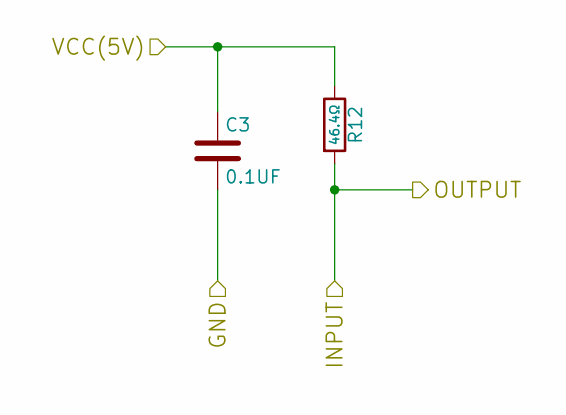
[picture p150: schematic fileDivider3.sch, sensor-mcu]

Parts:
C3: 0.1UF; CP_Radial_D5.0mm_P2.00mm
R12: 46.4Ω; R_Axial_DIN0207_L6.3mm_D2.5mm_P10.16mm_Horizontal

Connections:
/GND1: C3.2; also elsewhere on the board
/VIN(5V): C3.1, R12.1; also elsewhere on the board
FUEL_SIG_PIN: R12.2; also elsewhere on the board

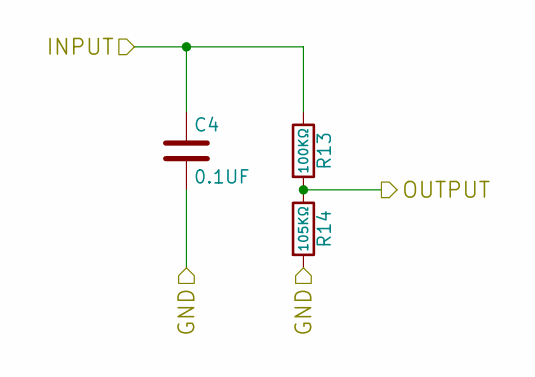
[picture p151: schematic fileDivider4.sch, sensor-mcu]

Parts:
C4: 0.1UF; CP_Radial_D5.0mm_P2.00mm
R13: 100KΩ; R_Axial_DIN0207_L6.3mm_D2.5mm_P10.16mm_Horizontal
R14: 105KΩ; R_Axial_DIN0207_L6.3mm_D2.5mm_P10.16mm_Horizontal

Connections:
/BATC: C4.1, R13.1; also elsewhere on the board
/GND1: C4.2, R14.2; also elsewhere on the board
BATC_SIG_PIN: R13.2, R14.1; also elsewhere on the board

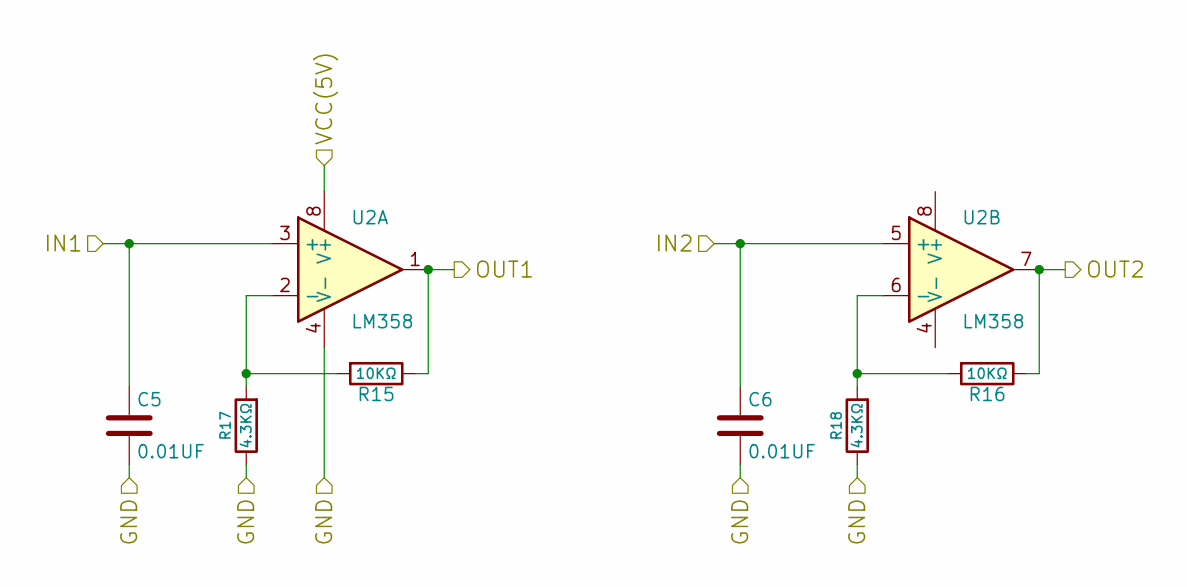
[picture p152: schematic fileOpamp1.sch, sensor-mcu]

Parts:
C5, C6: 0.01UF; C_Disc_D12.0mm_W4.4mm_P7.75mm
R15, R16: 10KΩ; R_Axial_DIN0207_L6.3mm_D2.5mm_P10.16mm_Horizontal
R17, R18: 4.3KΩ; R_Axial_DIN0207_L6.3mm_D2.5mm_P10.16mm_Horizontal
U2: LM358; DIP-8_W7.62mm

Connections:
/EGOL: C5.1, U2.3 (+); also elsewhere on the board
/EGOR: C6.1, U2.5 (+); also elsewhere on the board
/GND1: C5.2, C6.2, R17.1, R18.1, U2.4 (V-); also elsewhere on the board
/VIN(5V): U2.8 (V+); also elsewhere on the board
EGOL_SIG_PIN: R15.1, U2.1; also elsewhere on the board
EGOR_SIG_PIN: R16.1, U2.7; also elsewhere on the board
unnamed: R15.2, R17.2, U2.2 (-)
unnamed: R16.2, R18.2, U2.6 (-)
