ferdymercury/Controller-Electrical-Schematics/revision-1-do-not-use/mk4-v1-blank-board/kicad/hitchco-mk4.kicad_pcb

## KiCad design revision-1-do-not-use/mk4-v1-blank-board/kicad/hitchco-mk4.kicad_pcb (continued)

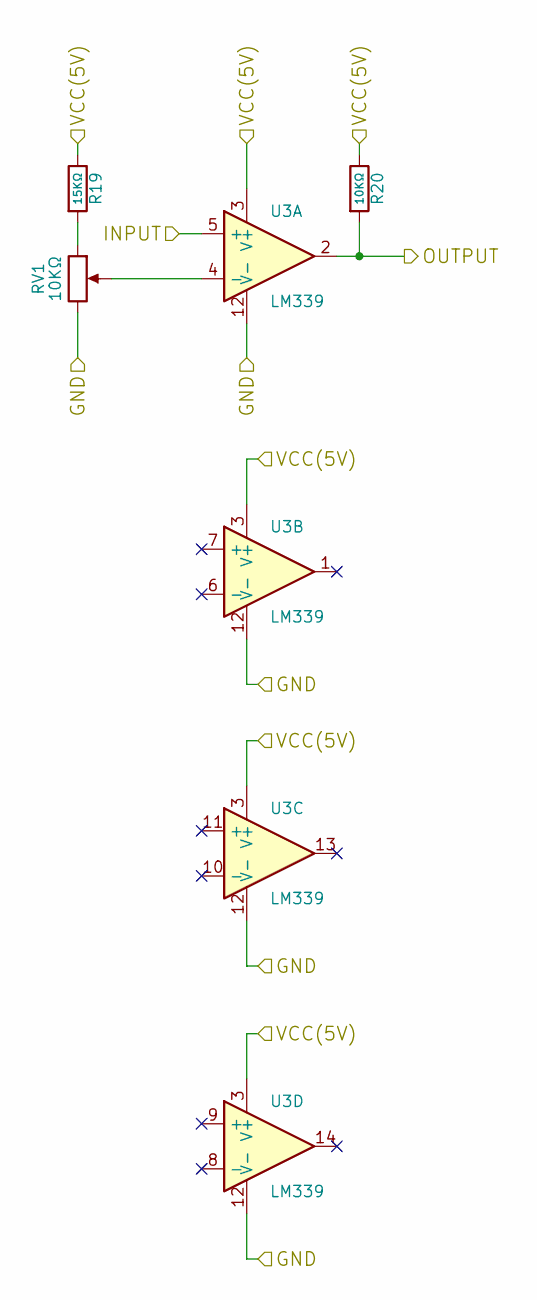
[picture p153: schematic fileComparator1.sch, sensor-mcu]

Parts:
R19: 15KΩ; R_Axial_DIN0207_L6.3mm_D2.5mm_P10.16mm_Horizontal
R20: 10KΩ; R_Axial_DIN0207_L6.3mm_D2.5mm_P10.16mm_Horizontal
RV1: 10KΩ; Potentiometer_Trimmer_Bourns_PV36W
U3: LM339; DIP-16_W7.62mm

Connections:
/GND1: RV1.3, U3.12 (V-); also elsewhere on the board
/SPED: U3.5 (+); also elsewhere on the board
/VIN(5V): R19.1, R20.1, U3.3 (V+); also elsewhere on the board
unnamed: R19.2, RV1.1
unnamed: RV1.2, U3.4 (-)
SPED_SIG_PIN: R20.2, U3.2; also elsewhere on the board

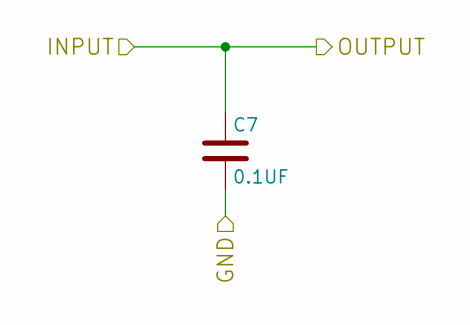
[picture p154: schematic fileFilter1.sch, sensor-mcu]

Parts:
C7: 0.1UF; CP_Radial_D5.0mm_P2.00mm

Connections:
/GND1: C7.2; also elsewhere on the board
ACT_SIG_PIN: C7.1; also elsewhere on the board

Parts of its further copies:
C10: 0.1UF; CP_Radial_D5.0mm_P2.00mm

Connections of its further copies:
/GND1: C10.2; also elsewhere on the board
ECT_SIG_PIN: C10.1; also elsewhere on the board

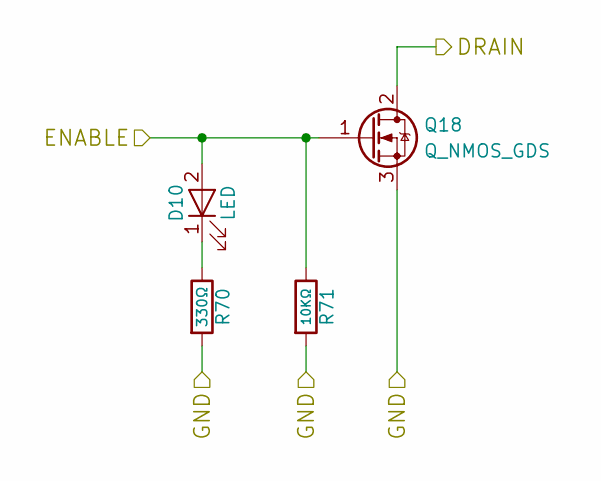
[picture p155: schematic fileNMOS1.sch, sensor-mcu]

Parts:
D1: LED; LED_D5.0mm
Q1: Q_NMOS_GDS; TO-220-3_Vertical
R25: 330Ω; R_Axial_DIN0207_L6.3mm_D2.5mm_P10.16mm_Horizontal
R26: 10KΩ; R_Axial_DIN0207_L6.3mm_D2.5mm_P10.16mm_Horizontal

Connections:
/DIRR: Q1.2 (D); also elsewhere on the board
/GND1: Q1.3 (S), R25.2, R26.2; also elsewhere on the board
DIRR_EN_PIN: D1.2 (A), Q1.1 (G), R26.1; also elsewhere on the board
unnamed: D1.1 (K), R25.1

Parts of its further copies:
D2, D5, D9, D10, D11, D12: LED; LED_D5.0mm
Q5, Q9, Q16, Q18, Q19, Q20: Q_NMOS_GDS; TO-220-3_Vertical
R27, R38, R68, R70, R72, R74: 330Ω; R_Axial_DIN0207_L6.3mm_D2.5mm_P10.16mm_Horizontal
R28, R39, R69, R71, R73, R75: 10KΩ; R_Axial_DIN0207_L6.3mm_D2.5mm_P10.16mm_Horizontal

Connections of its further copies:
/DIRL: Q5.2 (D); also elsewhere on the board
/ECF: Q9.2 (D); also elsewhere on the board
/GND1: Q5.3 (S), Q9.3 (S), Q16.3 (S), Q18.3 (S), Q19.3 (S), Q20.3 (S), R27.2, R28.2, R38.2, R39.2, R68.2, R69.2, R70.2, R71.2, R72.2, R73.2, R74.2, R75.2; also elsewhere on the board
/PSU2_GND: Q16.2 (D); also elsewhere on the board
/PSU3_GND: Q18.2 (D); also elsewhere on the board
/hitchco-mk4/LED1-: Q19.2 (D); also elsewhere on the board
/hitchco-mk4/LED2-: Q20.2 (D); also elsewhere on the board
DIRL_EN_PIN: D2.2 (A), Q5.1 (G), R28.1; also elsewhere on the board
ECF_EN_PIN: D5.2 (A), Q9.1 (G), R39.1; also elsewhere on the board
LED1_EN_PIN: D11.2 (A), Q19.1 (G), R73.1; also elsewhere on the board
LED2_EN_PIN: D12.2 (A), Q20.1 (G), R75.1; also elsewhere on the board
unnamed: D2.1 (K), R27.1
unnamed: D5.1 (K), R38.1
unnamed: D9.1 (K), R68.1
unnamed: D10.1 (K), R70.1
unnamed: D11.1 (K), R72.1
unnamed: D12.1 (K), R74.1
PSU2_EN_PIN: D9.2 (A), Q16.1 (G), R69.1; also elsewhere on the board
PSU3_EN_PIN: D10.2 (A), Q18.1 (G), R71.1; also elsewhere on the board

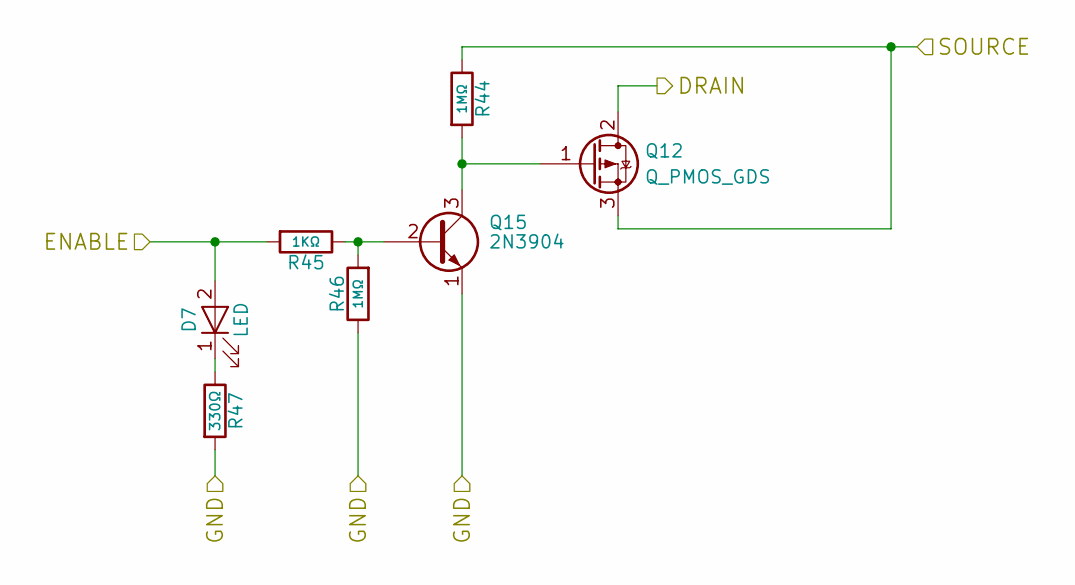
[picture p156: schematic filePMOS1.sch]

Parts:
D3: LED; LED_D5.0mm
Q6: Q_PMOS_GDS; TO-220-3_Vertical
Q8: 2N3904; TO-92_Molded_Narrow
R29, R31: 1MΩ; R_Axial_DIN0207_L6.3mm_D2.5mm_P10.16mm_Horizontal
R30: 1KΩ; R_Axial_DIN0207_L6.3mm_D2.5mm_P10.16mm_Horizontal
R32: 330Ω; R_Axial_DIN0207_L6.3mm_D2.5mm_P10.16mm_Horizontal

Connections:
/GND1: Q8.1 (E), R31.1, R32.2; also elsewhere on the board
/PSU1_12V: Q6.3 (S), R29.1; also elsewhere on the board
/STEN: Q6.2 (D); also elsewhere on the board
unnamed: D3.1 (K), R32.1
unnamed: Q6.1 (G), Q8.3 (C), R29.2
unnamed: Q8.2 (B), R30.1, R31.2
STEN_EN_PIN: D3.2 (A), R30.2; also elsewhere on the board

Parts of its further copies:
D4, D6, D7, D8, D13, D14, D15: LED; LED_D5.0mm
Q7, Q11, Q12, Q14, Q21, Q22, Q24: Q_PMOS_GDS; TO-220-3_Vertical
Q10, Q13, Q15, Q17, Q23, Q25, Q27: 2N3904; TO-92_Molded_Narrow
R33, R35, R40, R42, R44, R46, R48, R50, R76, R78, R80, R82, R84, R86: 1MΩ; R_Axial_DIN0207_L6.3mm_D2.5mm_P10.16mm_Horizontal
R34, R41, R45, R49, R77, R81, R85: 1KΩ; R_Axial_DIN0207_L6.3mm_D2.5mm_P10.16mm_Horizontal
R36, R43, R47, R51, R79, R83, R87: 330Ω; R_Axial_DIN0207_L6.3mm_D2.5mm_P10.16mm_Horizontal

Connections of its further copies:
/CRZB: Q21.2 (D); also elsewhere on the board
/CRZG: Q22.2 (D); also elsewhere on the board
/CRZR: Q21.3 (S), Q22.3 (S), Q24.3 (S), R76.1, R80.1, R84.1; also elsewhere on the board
/CRZY: Q24.2 (D); also elsewhere on the board
/GND1: Q10.1 (E), Q13.1 (E), Q15.1 (E), Q17.1 (E), Q23.1 (E), Q25.1 (E), Q27.1 (E), R35.1, R36.2, R42.1, R43.2, R46.1, R47.2, R50.1, R51.2, R78.1, R79.2, R82.1, R83.2, R86.1, R87.2; also elsewhere on the board
/PSU1_12V: Q7.3 (S), Q12.3 (S), Q14.3 (S), R33.1, R44.1, R48.1; also elsewhere on the board
/RUEN: Q7.2 (D); also elsewhere on the board
/WIPEH: Q14.2 (D); also elsewhere on the board
/WIPEL: Q11.2 (D), Q12.2 (D); also elsewhere on the board
/WIPEO: Q11.3 (S), R40.1; also elsewhere on the board
CRZ_DISABLE_PIN: D13.2 (A), R77.2; also elsewhere on the board
CRZ_MAINTAIN_PIN: D14.2 (A), R81.2; also elsewhere on the board
CRZ_RESUME_PIN: D15.2 (A), R85.2; also elsewhere on the board
unnamed: D4.1 (K), R36.1
unnamed: D6.1 (K), R43.1
unnamed: D7.1 (K), R47.1
unnamed: D8.1 (K), R51.1
unnamed: D13.1 (K), R79.1
unnamed: D14.1 (K), R83.1
unnamed: D15.1 (K), R87.1
unnamed: Q10.2 (B), R34.1, R35.2
unnamed: Q7.1 (G), Q10.3 (C), R33.2
unnamed: Q11.1 (G), Q13.3 (C), R40.2
unnamed: Q12.1 (G), Q15.3 (C), R44.2
unnamed: Q13.2 (B), R41.1, R42.2
unnamed: Q14.1 (G), Q17.3 (C), R48.2
unnamed: Q15.2 (B), R45.1, R46.2
unnamed: Q17.2 (B), R49.1, R50.2
unnamed: Q21.1 (G), Q23.3 (C), R76.2
unnamed: Q22.1 (G), Q25.3 (C), R80.2
unnamed: Q23.2 (B), R77.1, R78.2
unnamed: Q24.1 (G), Q27.3 (C), R84.2
unnamed: Q25.2 (B), R81.1, R82.2
unnamed: Q27.2 (B), R85.1, R86.2
RUEN_EN_PIN: D4.2 (A), R34.2; also elsewhere on the board
WIPEH_EN_PIN: D8.2 (A), R49.2; also elsewhere on the board
WIPEL_EN_PIN: D7.2 (A), R45.2; also elsewhere on the board
WIPEO_EN_PIN: D6.2 (A), R41.2; also elsewhere on the board

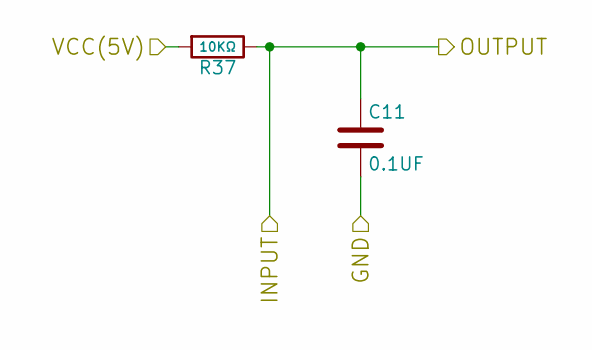
[picture p157: schematic fileSwitch1.sch, sensor-mcu]

Parts:
C11: 0.1UF; CP_Radial_D5.0mm_P2.00mm
R37: 10KΩ; R_Axial_DIN0207_L6.3mm_D2.5mm_P10.16mm_Horizontal

Connections:
/GND1: C11.2; also elsewhere on the board
/VIN(5V): R37.2; also elsewhere on the board
OILL_SIG_PIN: C11.1, R37.1; also elsewhere on the board

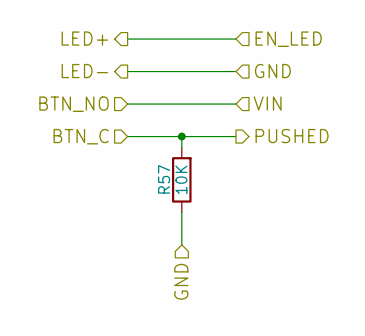
[picture p158: schematic pushbutton.sch]

Parts:
R52: 10K; R_Axial_DIN0207_L6.3mm_D2.5mm_P10.16mm_Horizontal

Connections:
/GND1: R52.1; also elsewhere on the board
PB1_SIG_PIN: R52.2; also elsewhere on the board

Parts of its further copies:
R53, R54, R55, R56, R57, R58, R59, R60, R61, R62, R63, R64, R65, R66: 10K; R_Axial_DIN0207_L6.3mm_D2.5mm_P10.16mm_Horizontal

Connections of its further copies:
/GND1: R53.1, R54.1, R55.1, R56.1, R57.1, R58.1, R59.1, R60.1, R61.1, R62.1, R63.1, R64.1, R65.1, R66.1; also elsewhere on the board
PB2_SIG_PIN: R53.2; also elsewhere on the board
PB3_SIG_PIN: R54.2; also elsewhere on the board
PB4_SIG_PIN: R61.2; also elsewhere on the board
PB6_SIG_PIN: R62.2; also elsewhere on the board
PB7_SIG_PIN: R63.2; also elsewhere on the board
PB9_SIG_PIN: R55.2; also elsewhere on the board
PB10_SIG_PIN: R56.2; also elsewhere on the board
PB11_SIG_PIN: R64.2; also elsewhere on the board
PB12_SIG_PIN: R65.2; also elsewhere on the board
PB13_SIG_PIN: R66.2; also elsewhere on the board
PB14_SIG_PIN: R57.2; also elsewhere on the board
PB15_SIG_PIN: R58.2; also elsewhere on the board
PB16_SIG_PIN: R59.2; also elsewhere on the board
PB17_SIG_PIN: R60.2; also elsewhere on the board

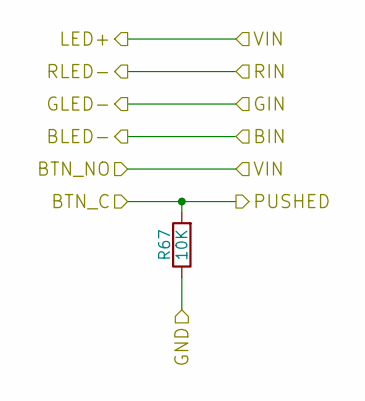
[picture p159: schematic rgbpushbutton.sch]

Parts:
R67: 10K; R_Axial_DIN0207_L6.3mm_D2.5mm_P10.16mm_Horizontal

Connections:
/GND1: R67.1; also elsewhere on the board
PB8_SIG_PIN: R67.2; also elsewhere on the board

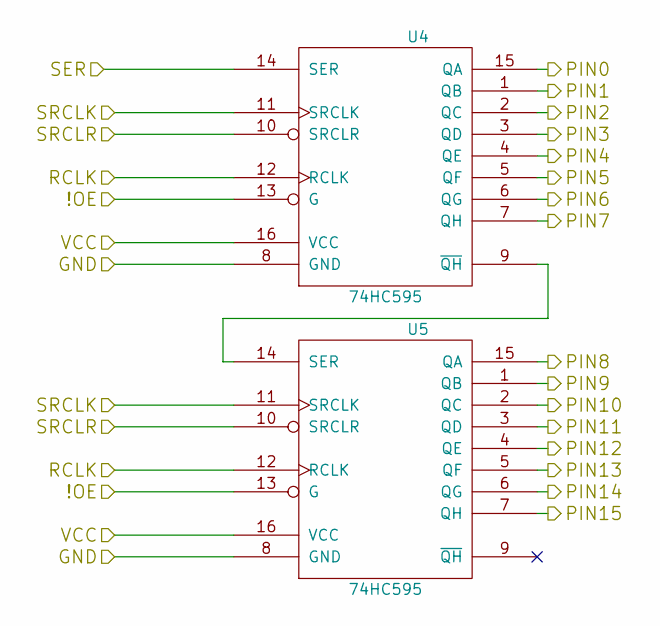
[picture p160: schematic fileShiftBlock.sch]

Parts:
U4, U5: 74HC595; DIP-16_W7.62mm

Connections:
/GND1: U4.8 (GND), U5.8 (GND); also elsewhere on the board
/VIN(5V): U4.16 (VCC), U5.16 (VCC); also elsewhere on the board
/hitchco-mk4/ShiftBlock/PIN15: U5.7 (QH)
unnamed: U4.9 (~QH), U5.14 (SER)
PB1_LED_EN: U4.15 (QA); also elsewhere on the board
PB2_LED_EN: U4.1 (QB); also elsewhere on the board
PB3_LED_EN: U4.2 (QC); also elsewhere on the board
PB4_LED_EN: U4.3 (QD); also elsewhere on the board
PB6_LED_EN: U4.4 (QE); also elsewhere on the board
PB7_LED_EN: U4.5 (QF); also elsewhere on the board
PB9_LED_EN: U4.6 (QG); also elsewhere on the board
PB10_LED_EN: U4.7 (QH); also elsewhere on the board
PB11_LED_EN: U5.15 (QA)
PB12_LED_EN: U5.1 (QB); also elsewhere on the board
PB13_LED_EN: U5.2 (QC); also elsewhere on the board
PB14_LED_EN: U5.3 (QD); also elsewhere on the board
PB15_LED_EN: U5.4 (QE); also elsewhere on the board
PB16_LED_EN: U5.5 (QF); also elsewhere on the board
PB17_LED_EN: U5.6 (QG); also elsewhere on the board
SREG_OE_PIN: U4.13 (G), U5.13 (G); also elsewhere on the board
SREG_RCLK_PIN: U4.12 (RCLK), U5.12 (RCLK); also elsewhere on the board
SREG_SER_PIN: U4.14 (SER); also elsewhere on the board
SREG_SRCLK_PIN: U4.11 (SRCLK), U5.11 (SRCLK); also elsewhere on the board
SREG_SRCLR_PIN: U4.10 (SRCLR), U5.10 (SRCLR); also elsewhere on the board

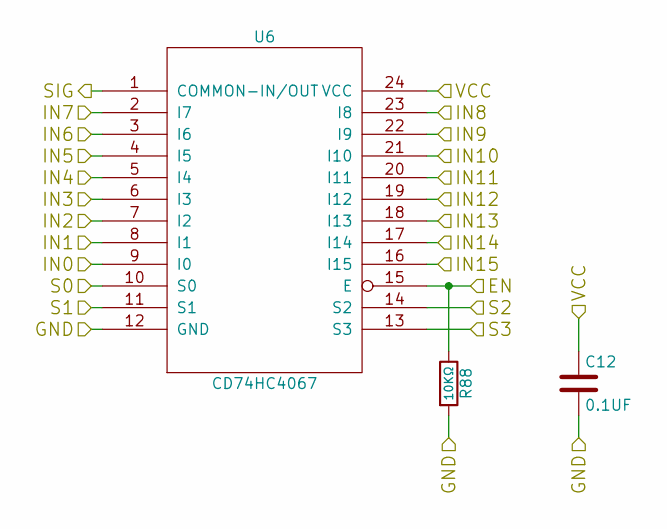
[picture p161: schematic fileMuxBlock.sch]

Parts:
C12: 0.1UF; CP_Radial_D5.0mm_P2.00mm
R88: 10KΩ; R_Axial_DIN0207_L6.3mm_D2.5mm_P10.16mm_Horizontal
U6: CD74HC4067; SOIC-24W_7.5x15.4mm_Pitch1.27mm

Connections:
/GND1: C12.2, R88.2, U6.12 (GND); also elsewhere on the board
/VIN(5V): C12.1, U6.24 (VCC); also elsewhere on the board
/hitchco-mk4/MuxBlock/IN15: U6.16 (I15)
MUX_EN_PIN: R88.1, U6.15 (E); also elsewhere on the board
MUX_S0_PIN: U6.10 (S0); also elsewhere on the board
MUX_S1_PIN: U6.11 (S1); also elsewhere on the board
MUX_S2_PIN: U6.14 (S2); also elsewhere on the board
MUX_S3_PIN: U6.13 (S3); also elsewhere on the board
MUX_SIG_PIN: U6.1 (COMMON-IN/OUT); also elsewhere on the board
PB1_SIG_PIN: U6.9 (I0); also elsewhere on the board
PB2_SIG_PIN: U6.8 (I1); also elsewhere on the board
PB3_SIG_PIN: U6.7 (I2); also elsewhere on the board
PB4_SIG_PIN: U6.6 (I3); also elsewhere on the board
PB6_SIG_PIN: U6.5 (I4); also elsewhere on the board
PB7_SIG_PIN: U6.4 (I5); also elsewhere on the board
PB9_SIG_PIN: U6.3 (I6); also elsewhere on the board
PB10_SIG_PIN: U6.2 (I7); also elsewhere on the board
PB11_SIG_PIN: U6.23 (I8); also elsewhere on the board
PB12_SIG_PIN: U6.22 (I9); also elsewhere on the board
PB13_SIG_PIN: U6.21 (I10); also elsewhere on the board
PB14_SIG_PIN: U6.20 (I11); also elsewhere on the board
PB15_SIG_PIN: U6.19 (I12); also elsewhere on the board
PB16_SIG_PIN: U6.18 (I13); also elsewhere on the board
PB17_SIG_PIN: U6.17 (I14); also elsewhere on the board

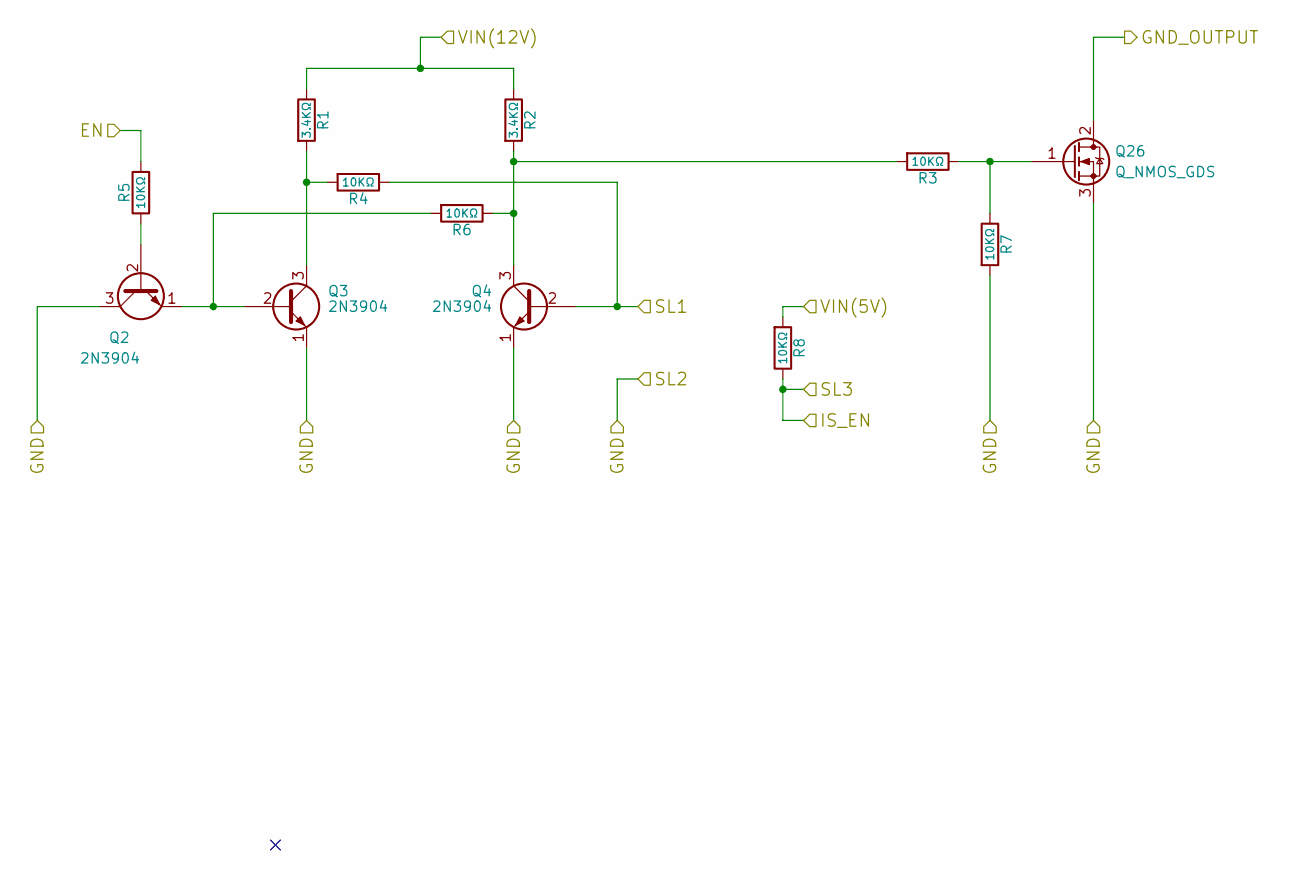
[picture p162: schematic fileSoftPowerSwitch.sch]

Parts:
Q2, Q3, Q4: 2N3904; TO-92_Molded_Narrow
Q26: Q_NMOS_GDS; TO-220-3_Vertical
R1, R2: 3.4KΩ; R_Axial_DIN0207_L6.3mm_D2.5mm_P10.16mm_Horizontal
R3, R4, R5, R6, R7, R8: 10KΩ; R_Axial_DIN0207_L6.3mm_D2.5mm_P10.16mm_Horizontal

Connections:
/GND1: Q2.3 (C), Q3.1 (E), Q4.1 (E), Q26.3 (S), R7.2; also elsewhere on the board
/PSU1_12V: R1.1, R2.1; also elsewhere on the board
/PSU1_GND: Q26.2 (D); also elsewhere on the board
/VIN(5V): R8.2; also elsewhere on the board
/hitchco-mk4/RS1_L1: Q4.2 (B), R4.1; also elsewhere on the board
unnamed: Q2.1 (E), Q3.2 (B), R6.2
unnamed: Q2.2 (B), R5.1
unnamed: Q3.3 (C), R1.2, R4.2
unnamed: Q4.3 (C), R2.2, R3.2, R6.1
unnamed: Q26.1 (G), R3.1, R7.1
PSU1_EN_PIN: R5.2; also elsewhere on the board
PSU1_SIG_PIN: R8.1; also elsewhere on the board

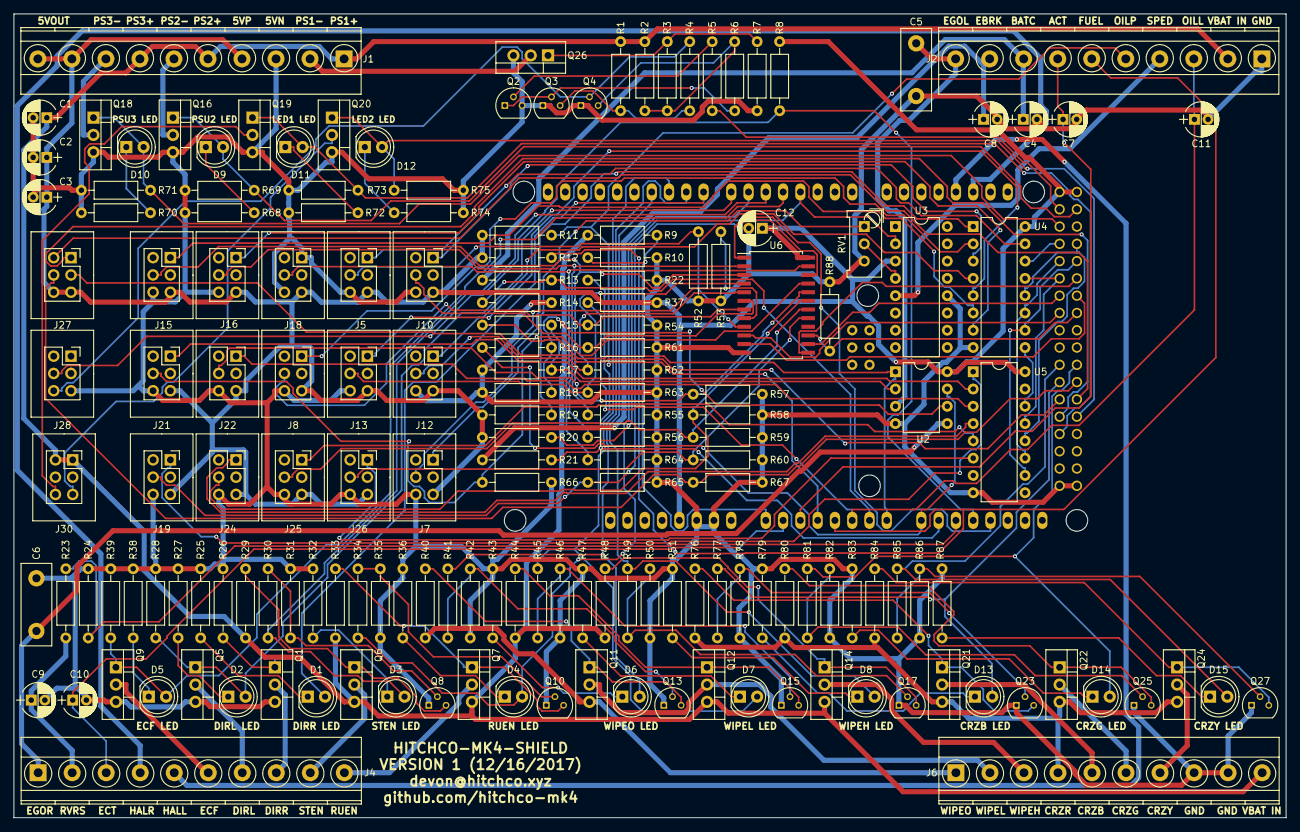
[picture p163: board revision-1-do-not-use/mk4-v1-blank-board/kicad/hitchco-mk4.kicad_pcb from above]

Board: 2 copper layers, 186.9 x 118.1 mm, 171 parts (0 on the bottom side), 143 nets.
