ferdymercury/Controller-Electrical-Schematics/(commit log)

2018-04-18 adding files
    [_saved_NPN1.sch, _saved_filestarter-mcu.sch, extra.sch, fileComparator1.sch, fileDivider1.sch, fileDivider2.sch, fileDivider3.sch, fileDivider4.sch]
2018-04-27 added multiple folders for both versions
    [_saved_NPN1.sch, _saved_filestarter-mcu.sch, extra.sch, fileComparator1.sch, fileDivider1.sch, fileDivider2.sch, fileDivider3.sch, fileDivider4.sch]
2018-05-04 Soft push of v2 board modifications
    [_saved_NPN1.sch, _saved_filestarter-mcu.sch, extra.sch, fileComparator1.sch, fileDivider1.sch, fileDivider2.sch, fileDivider3.sch, fileDivider4.sch]
2018-05-20 working through adding new features
    [_saved_NPN1.sch, _saved_filestarter-mcu.sch, extra.sch, fileComparator1.sch, fileDivider1.sch, fileDivider2.sch, fileDivider3.sch, fileDivider4.sch]
2018-05-22 got most of the screw terminals planned out in schem
    [fileComparator1.sch, fileDivider1.sch, fileDivider2.sch, fileDivider3.sch, fileDivider4.sch, fileFilter1.sch, fileMuxBlock.sch, fileNMOS1.sch]
2018-05-23 added headnight diodes, I don't think software control of them is going to be possible
    [fileComparator1.sch, fileDivider1.sch, fileDivider2.sch, fileDivider3.sch, fileDivider4.sch, fileFilter1.sch, fileMuxBlock.sch, fileNMOS1.sch]
2018-06-02 schematic is done, footprint association and netlist are also done
    [_saved_NPN1.sch, _saved_filestarter-mcu.sch, extra.sch, fileComparator1.sch, fileDivider1.sch, fileDivider2.sch, fileDivider3.sch, fileDivider4.sch]
2018-06-05 all components on the board
    [fileDivider1.sch, fileNMOS1.sch, filePMOS1.sch, fileSoftPowerSwitch.sch, hitchco-mk4-mcu.sch, hitchco-mk4.kicad_pcb, hitchco-mk4.sch, logicLevelShift.sch]
2018-06-06 before ar
    [hitchco-mk4.kicad_pcb, pcb.DXF]
2018-06-09 all files are in, time to order!
    [fileMuxBlock.sch, fileNMOS1.sch, hitchco-mk4-6.dsn, hitchco-mk4.kicad_pcb, hitchco-mk4_0.1.csv, pushbutton.sch, rgbpushbutton.sch]
2018-07-02 images up
    [_saved_NPN1.sch, _saved_filestarter-mcu.sch, extra.sch, fileComparator1.sch, fileDivider1.sch, fileDivider2.sch, fileDivider3.sch, fileDivider4.sch]
2021-11-10 Update README.md
    https://forum.kicad.info/t/warning-avoid-all-links-to-kicad-pcb-org-use-kicad-org/31521
